AeroKITties/Kitties-Hardware/Hardware/ciam/impeller/impeller/Картинки/Снимок экрана (45).png

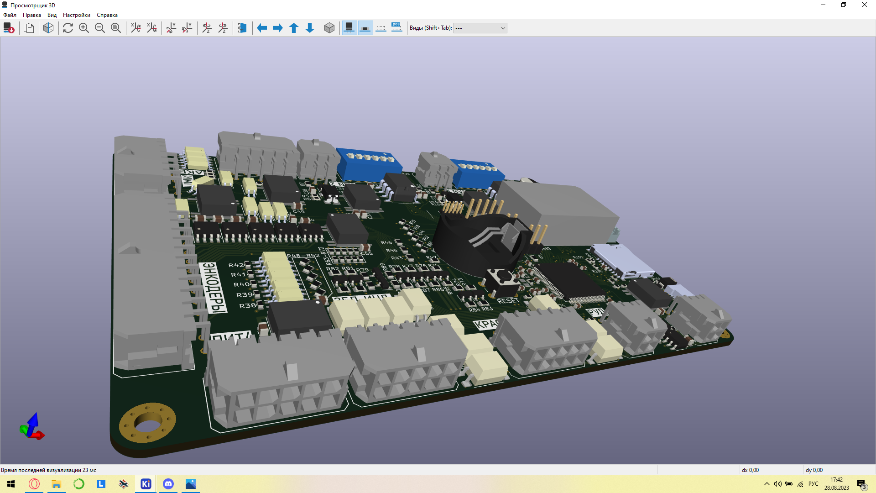
Hardware/ciam/impeller/impeller/Картинки/Снимок экрана (45).png
