AeroKITties/Kitties-Hardware/Hardware/ciam/impeller/impeller/Картинки/Снимок экрана (46).png

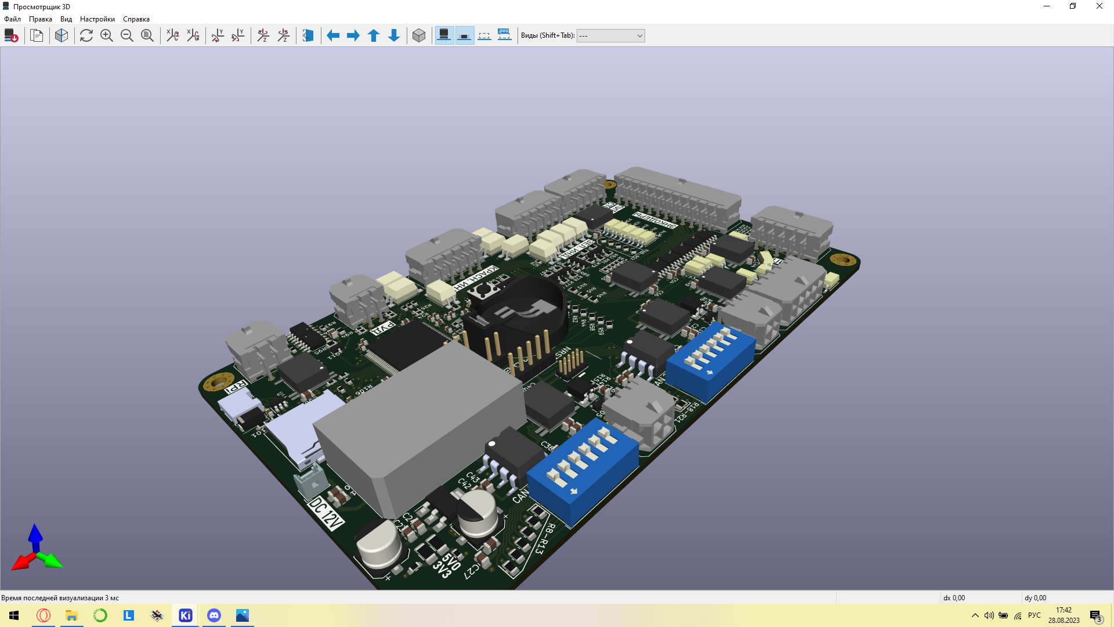
Hardware/ciam/impeller/impeller/Картинки/Снимок экрана (46).png
