AeroKITties/Kitties-Hardware/Documentation/gps/H52ce5d94572c492c8bb03de4b48cf365b.png

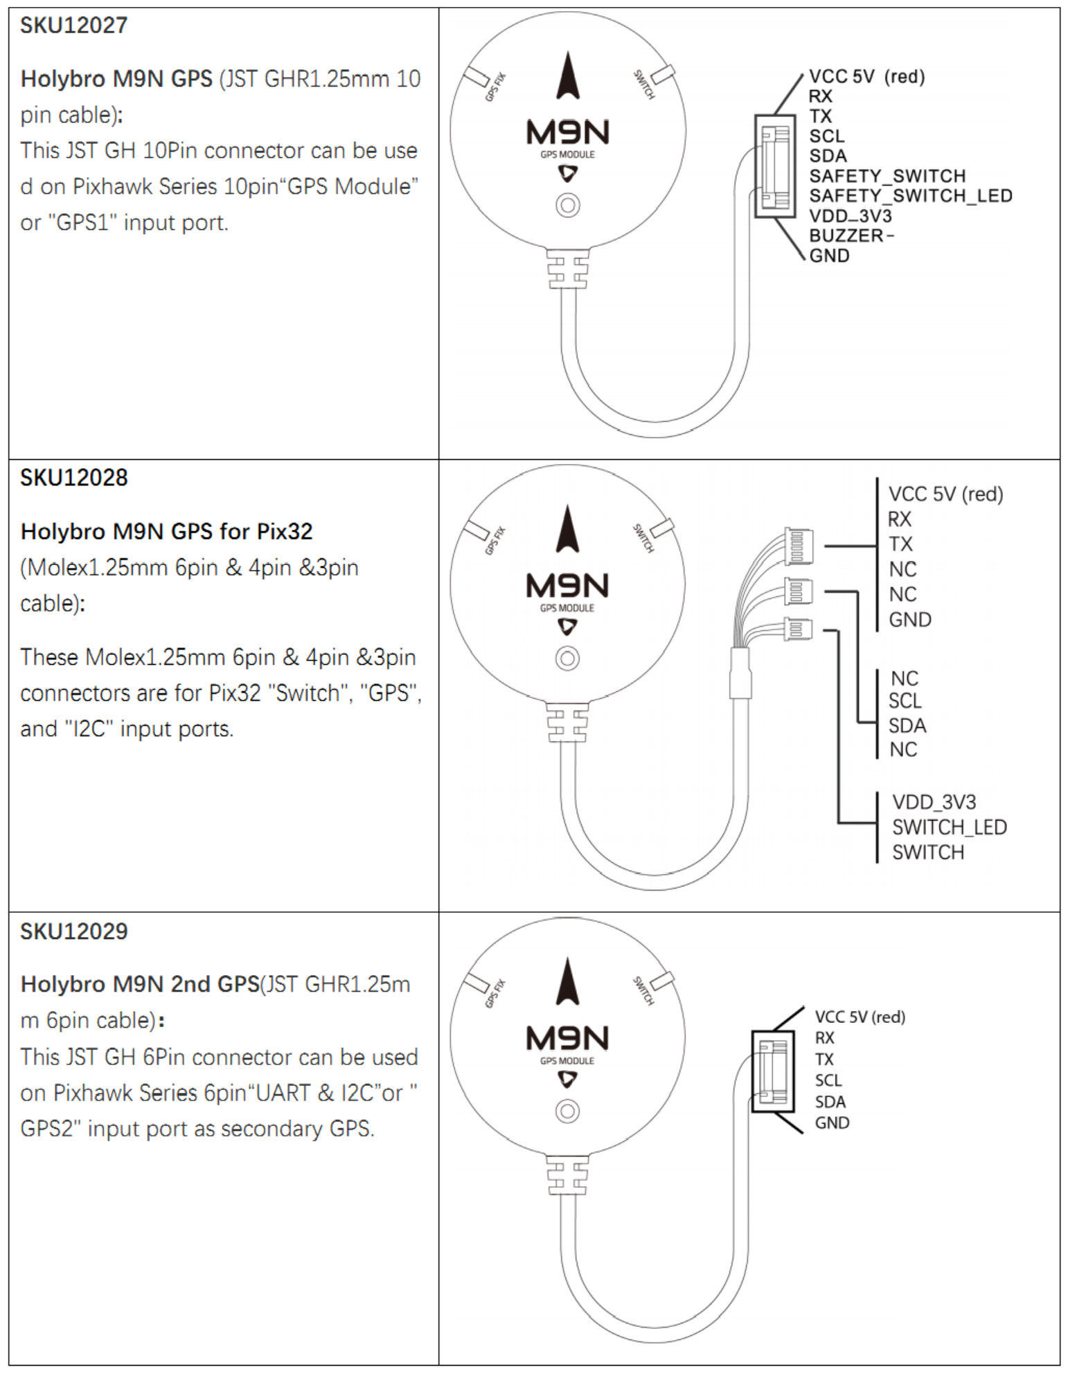
Documentation/gps/H52ce5d94572c492c8bb03de4b48cf365b.png
