AeroKITties/Kitties-Hardware/Documentation/gps/Neo-6-Neo7 module.jpg

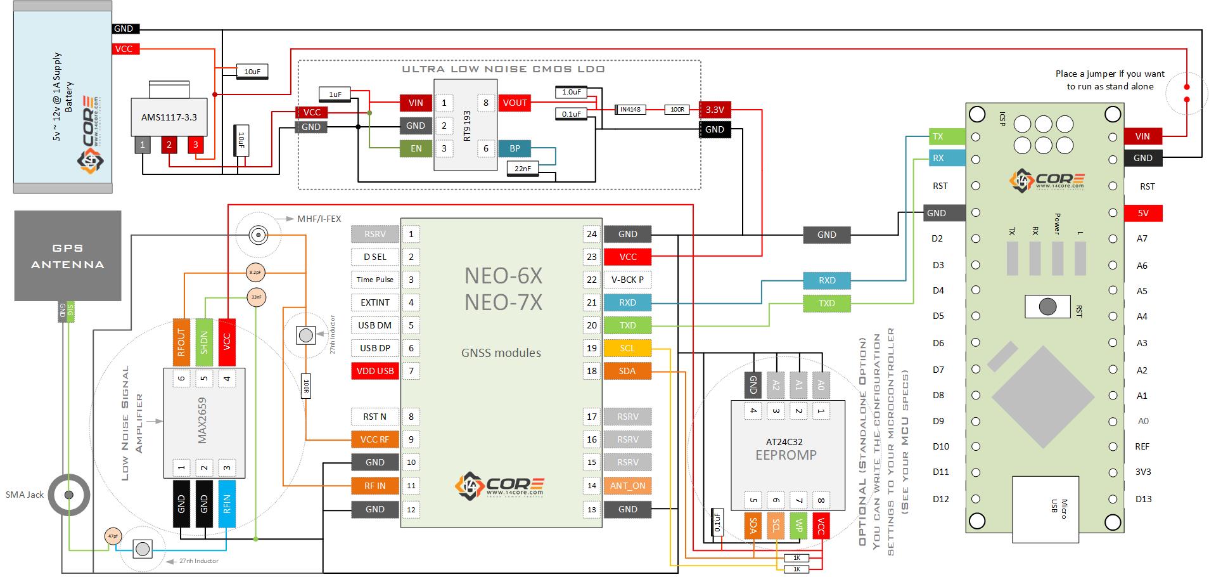
Documentation/gps/Neo-6-Neo7 module.jpg
