AeroKITties/Kitties-Hardware/Documentation/Transistor/MOSFET/mosfet-cheat-sheet.png

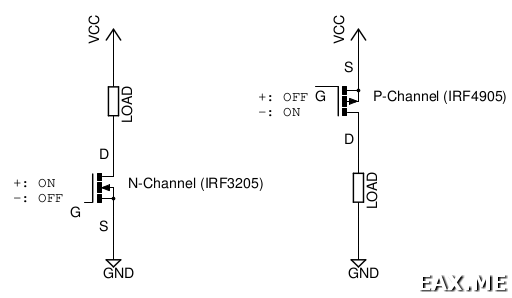
Documentation/Transistor/MOSFET/mosfet-cheat-sheet.png
