AeroKITties/Kitties-Hardware/Documentation/usb connector/EARU.jpg

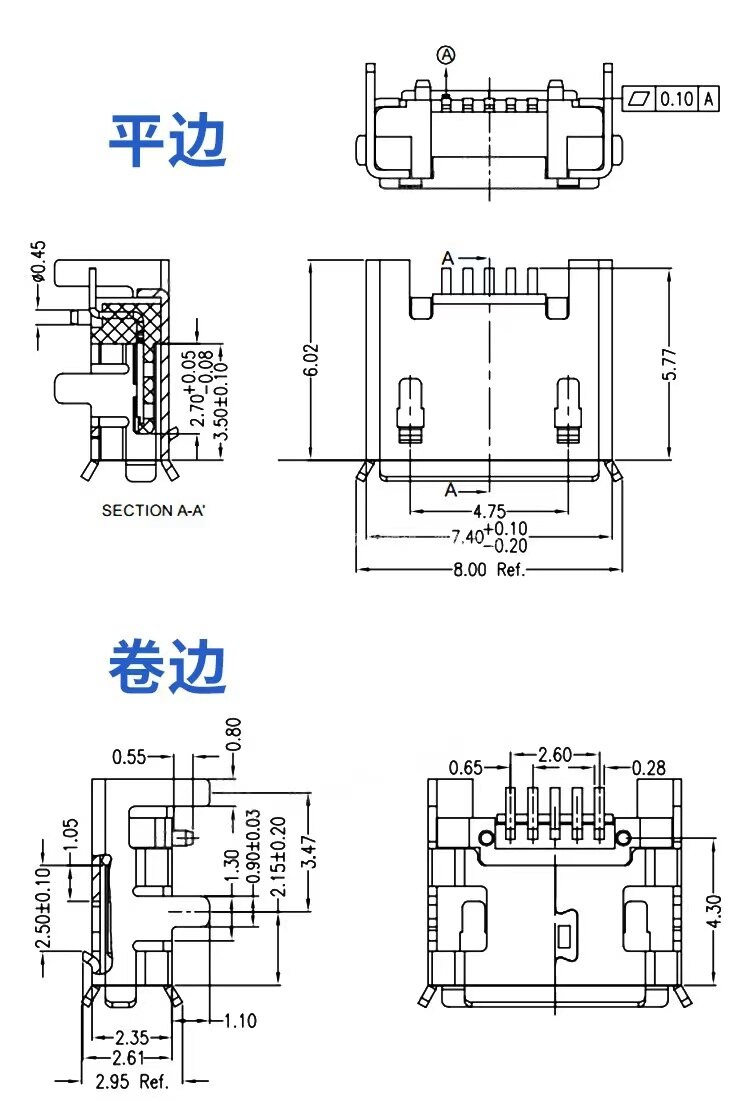
Documentation/usb connector/EARU.jpg
