AeroKITties/Kitties-Hardware/Documentation/usb connector/NIUEWISX.jpg

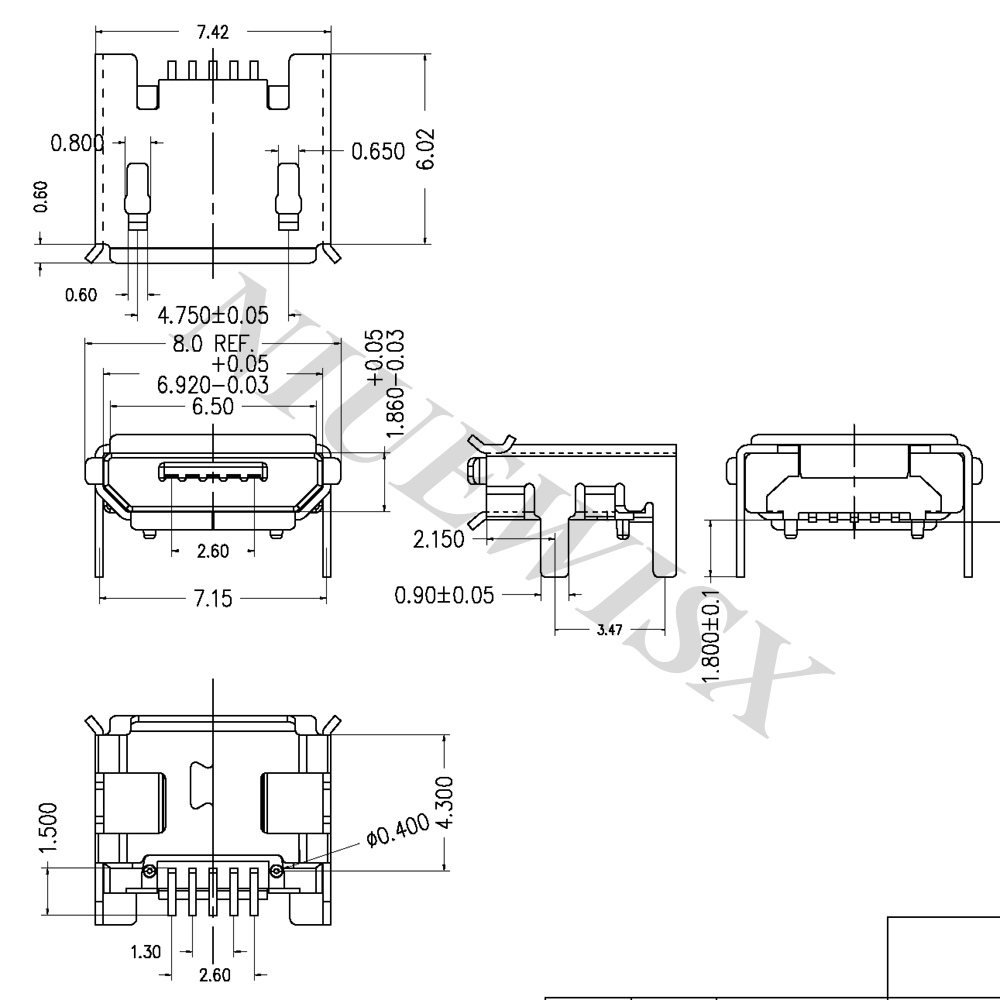
Documentation/usb connector/NIUEWISX.jpg
