AeroKITties/Kitties-Hardware/Hardware/ciam/impeller/impeller/Картинки/Снимок экрана (40).png

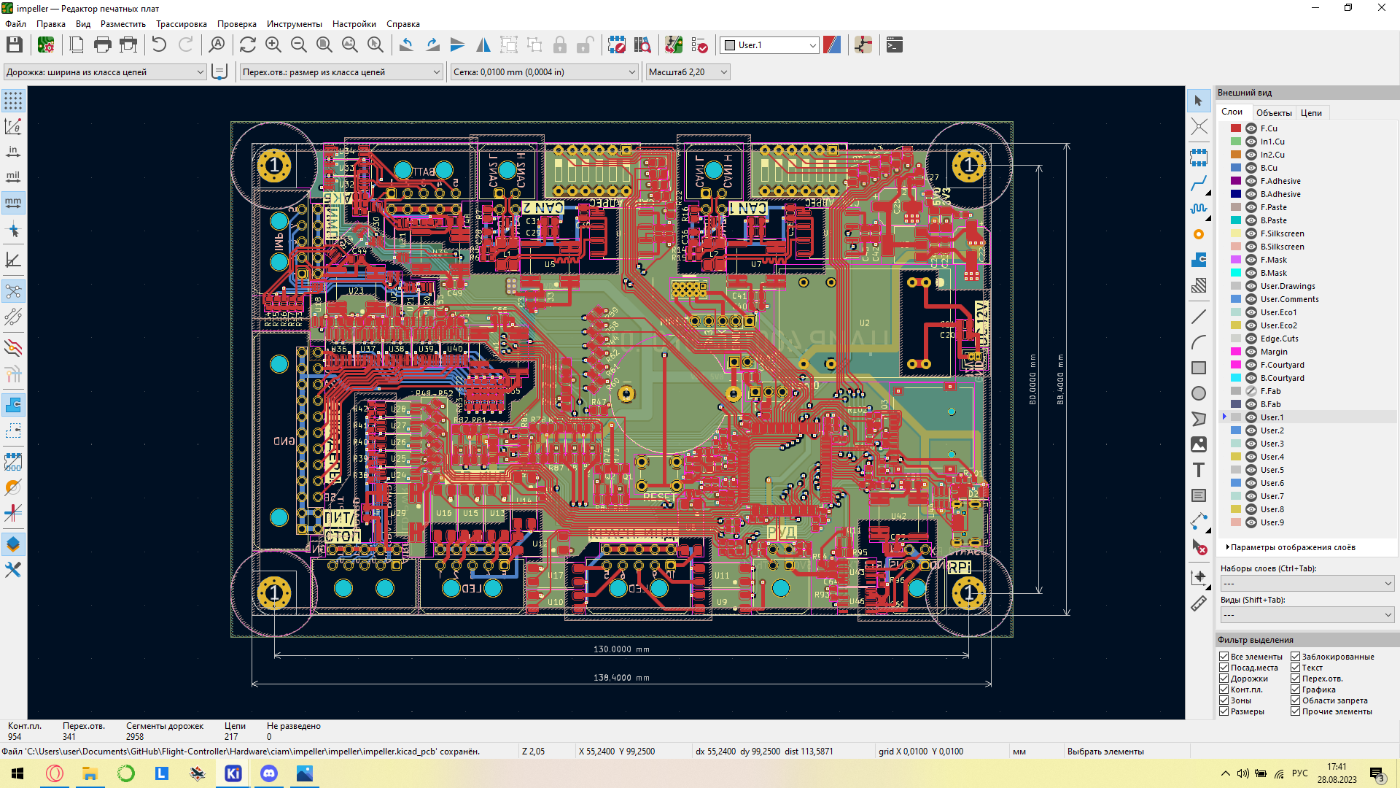
Hardware/ciam/impeller/impeller/Картинки/Снимок экрана (40).png
