AeroKITties/Kitties-Hardware/Hardware/ciam/impeller/impeller/Картинки/Снимок экрана (41).png

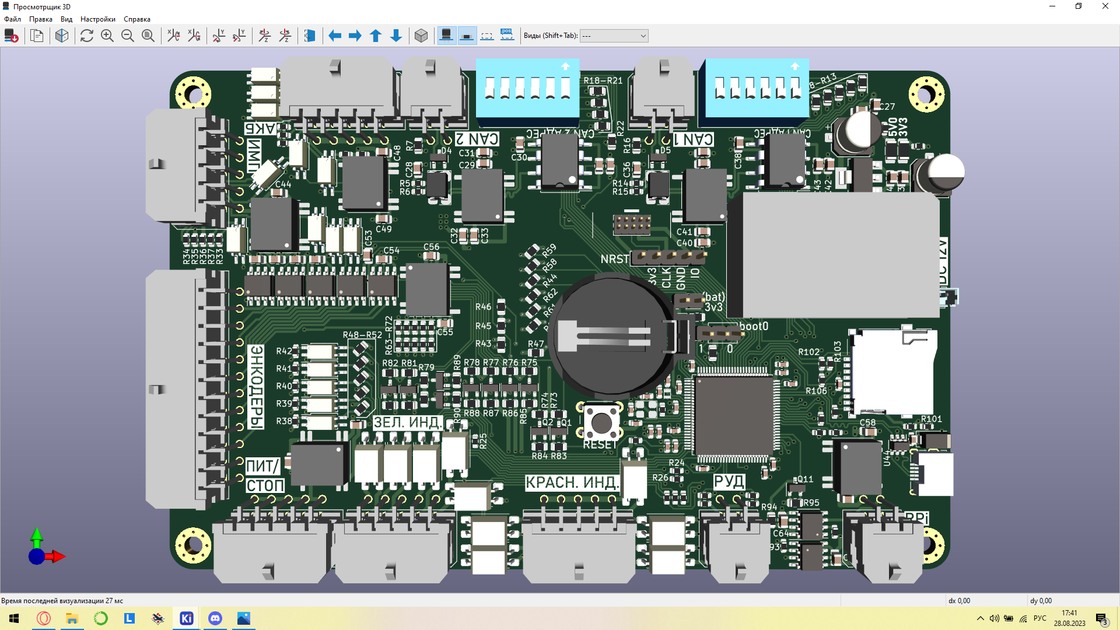
Hardware/ciam/impeller/impeller/Картинки/Снимок экрана (41).png
