AeroKITties/Kitties-Hardware/Hardware/ciam/impeller/impeller/Картинки/Снимок экрана (42).png

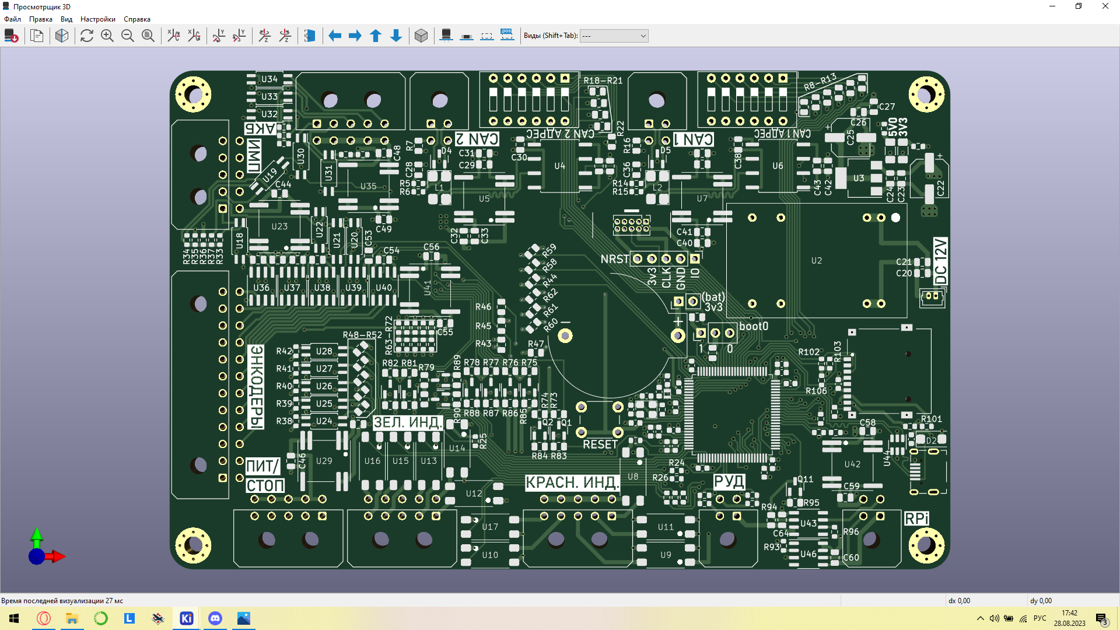
Hardware/ciam/impeller/impeller/Картинки/Снимок экрана (42).png
