AeroKITties/Kitties-Hardware/Hardware/ciam/impeller/impeller/Картинки/Снимок экрана (43).png

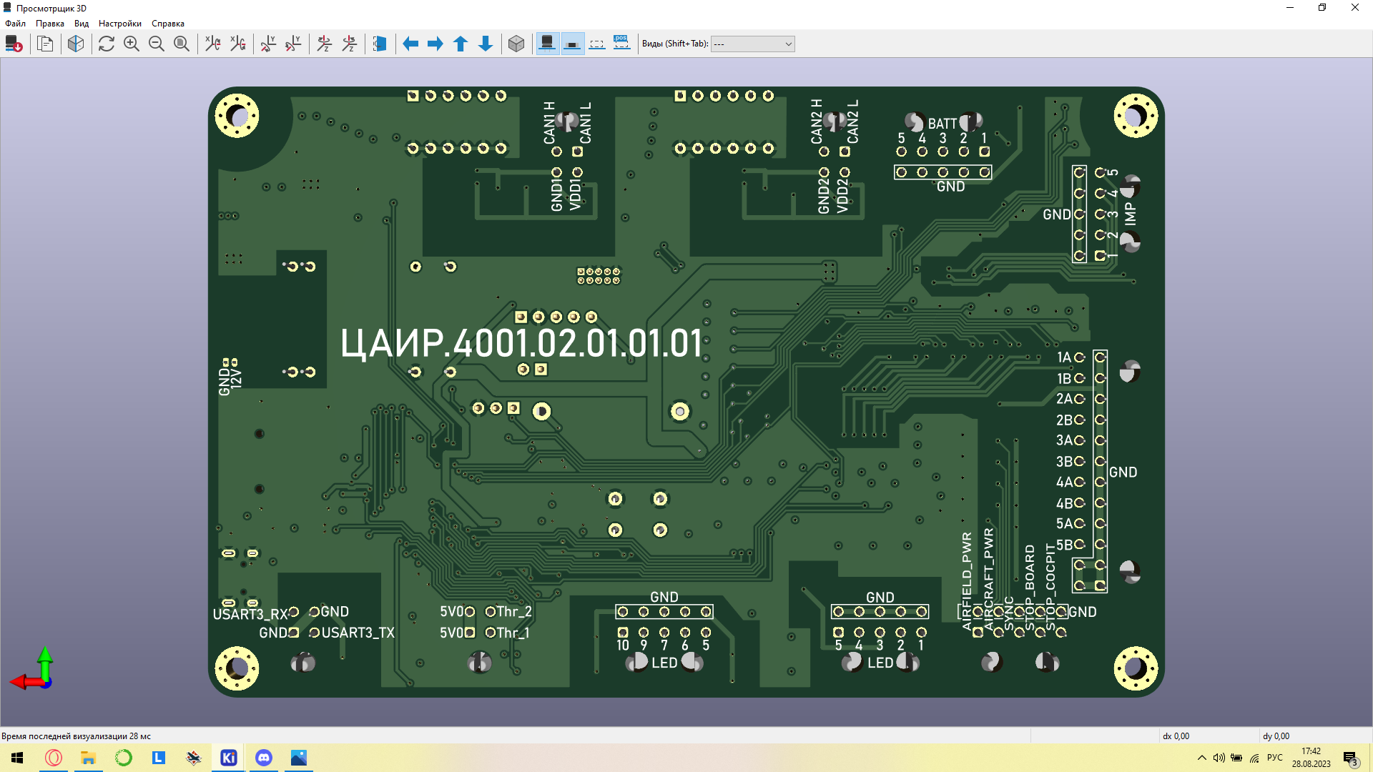
Hardware/ciam/impeller/impeller/Картинки/Снимок экрана (43).png
