AeroKITties/Kitties-Hardware/Hardware/ciam/impeller/rpi_power_shield/Картинки/Снимок экрана (33).png

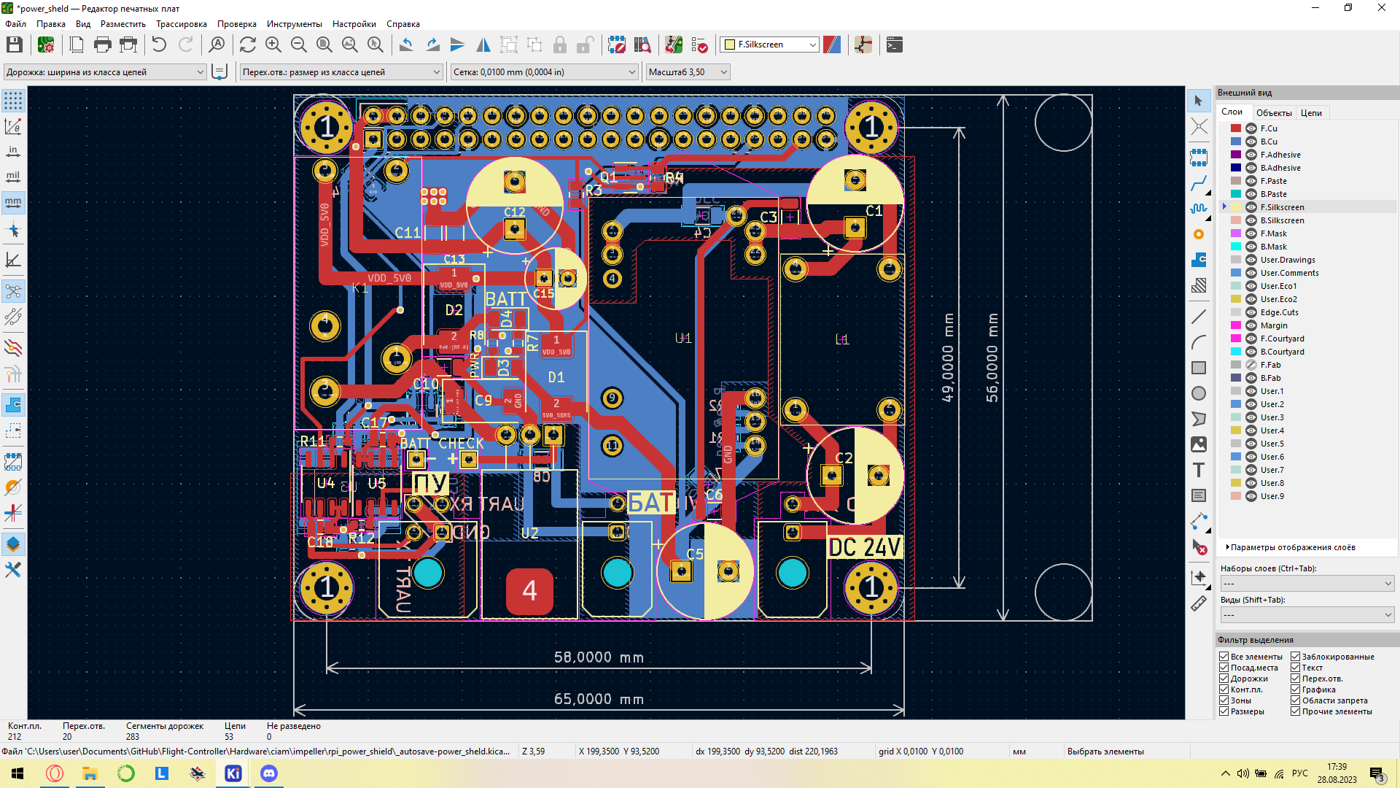
Hardware/ciam/impeller/rpi_power_shield/Картинки/Снимок экрана (33).png
