AeroKITties/Kitties-Hardware/Hardware/ciam/impeller/rpi_power_shield/Картинки/Снимок экрана (58).png

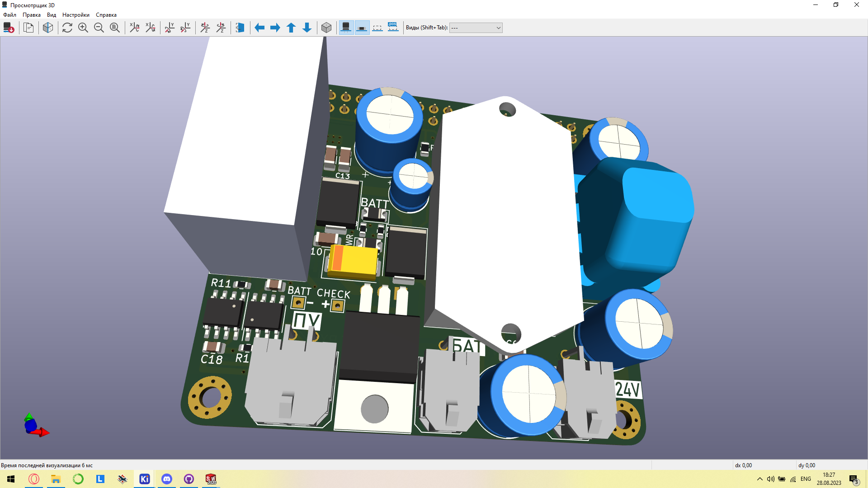
Hardware/ciam/impeller/rpi_power_shield/Картинки/Снимок экрана (58).png
