AeroKITties/Kitties-Hardware/Hardware/Royal Penguin/0.0/FC0.jpg

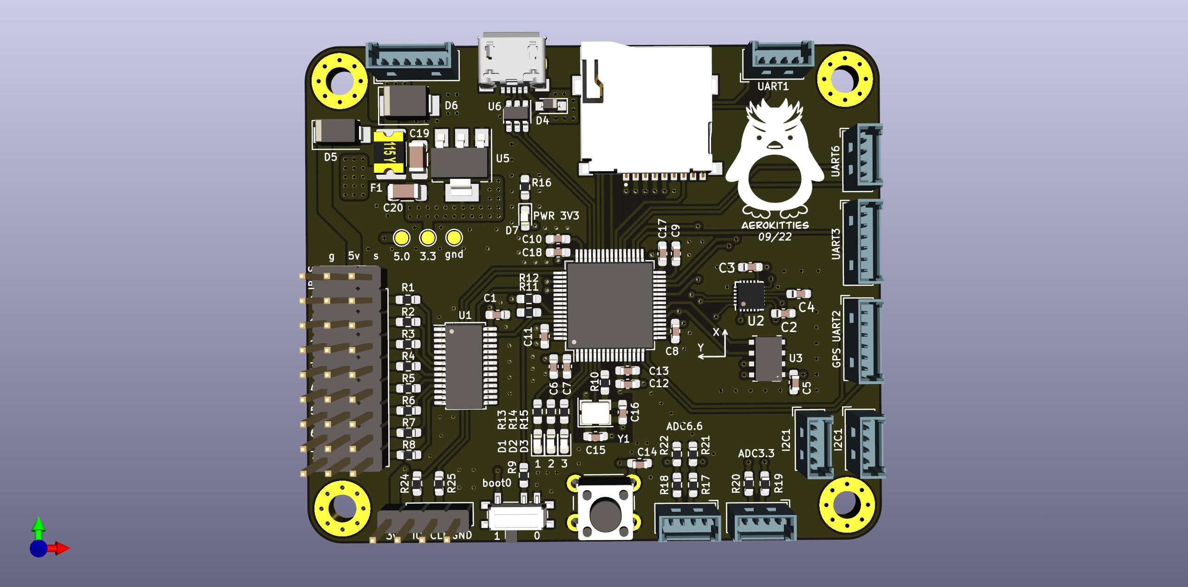
Hardware/Royal Penguin/0.0/FC0.jpg
