AeroKITties/Kitties-Hardware/Hardware/ciam/impeller/impeller/BOM_другое.xlsx

N | Название | Цена | Кол-во | Кол-во с запасом | Сумма | Ссылка
1 | Лампа зеленая | 170 | 5 | 10 | 1700 | https://www.chipdip.ru/product/ad-22ds-24-iek | СУММА
2 | Лампа красная | 180 | 5 | 10 | 1800 | https://www.chipdip.ru/product/ad-22ds-24 | 169717
3 | Кнопка аварийной остановки | 7220 | 2 | 2 | 14440 | https://www.chipdip.ru/product/ce4t-10r-11
4 | Энкодер инкрементальный | 370 | 5 | 10 | 3700 | https://www.platan.ru/cgi-bin/qwery.pl/id=216226127
5 | Ручка для энкодера | 370 | 5 | 10 | 3700 | https://www.chipdip.ru/product/knobs-42031-2
6 | Кнопка без фиксации зеленая | 530 | 1 | 3 | 1590 | https://www.chipdip.ru/product/mb100dy
7 | РУД Thrustmaster | 9449 | 1 | 1 | 9449 | https://www.citilink.ru/product/dzhoistik-thrustmaster-tca-quardrant-airbus-edition-ww-version-seryi-c-1583059/
8 | Тумблер | 1600 | 13 | 16 | 25600 | https://www.chipdip.ru/product/ma122
9 | Защитный колпачок | 71 | 1 | 3 | 213 | https://www.chipdip.ru/product0/8544855179
10 | Мышь компьютерная | 1710 | 1 | 2 | 3420 | https://www.chipdip.ru/product0/8020808726
11 | Одноплатный компьютер Raspberry pi | 23860 | 2 | 3 | 71580 | https://www.chipdip.ru/product/raspberry-pi-3-model-b-2
12 | Медный провод 22AWG красный | 510 | 3 | 5 | 2550 | https://www.li-force.ru/shop/view/22awg-10-033-60008-ul3135-lfw-22w-2
13 | Медный провод 22AWG серый | 510 | 3 | 5 | 2550 | https://www.li-force.ru/shop/view/22awg-10-033-60008-ul3135-lfw-22o
14 | Медный провод 22AWG синий | 510 | 2 | 3 | 1530 | https://www.li-force.ru/shop/view/22awg-10-033-60008-ul3135-lfw-22gr
15 | Медный провод 22AWG зеленый | 510 | 2 | 3 | 1530 | https://www.li-force.ru/shop/view/22awg-10-033-60008-ul3135-lfw-22y-2
16 | Потенциометр | 1130 | 2 | 5 | 5650 | https://www.chipdip.ru/product0/8008840025
17 | Разъем Micro-Fit 2x2 Ж | 30 | 4 | 15 | 450 | https://www.chipdip.ru/product/sct3001mh-2x2p
18 | Разъем Micro-Fit 2x5 Ж | 33 | 5 | 15 | 495 | https://www.chipdip.ru/product/sct3001mh-2x5p
19 | Разъем Micro-Fit 2x12 Ж | 60 | 1 | 5 | 300 | https://www.chipdip.ru/product/sct3001mh-2x12p
20 | Контакт-гнездо Micro-Fit | 8 | 200 | 500 | 4000 | https://www.chipdip.ru/product/sct3001-ft
21 | ethernet шнур m-m 15м | 720 | 1 | 2 | 1440 | https://www.chipdip.ru/product0/8003235821
22 | ethernet шнур m-m 2м | 830 | 1 | 2 | 1660 | https://www.chipdip.ru/product0/8007831350
23 | ethernet шнур m-m 20м | 1000 | 1 | 2 | 2000 | https://www.chipdip.ru/product0/8011591466
24 | Кабель HDMI - HDMI 1м | 320 | 1 | 2 | 640 | https://www.chipdip.ru/product/ox-hdmi1v1.4lx
25 | Кабель HDMI - HDMI 1.5м | 865 | 1 | 2 | 1730 | https://www.chipdip.ru/product0/8015598655
26 | Батарейка 3В плоская | 180 | 1 | 10 | 1800 | https://www.chipdip.ru/product/gp-cr2032
27 | micro sd карта | 700 | 3 | 6 | 4200 | https://www.chipdip.ru/product/sdcs2-64gb
