AeroKITties/Kitties-Hardware/Hardware/ciam/impeller/impeller/BOM_плата_кпу.xlsx

Reference | Value | Footprint | Ссылка | Цена | Человекопонятное название | Кол. | Кол-во с запасом | Сумма
BT1 | KLS5-CR2032-01 | user_lib:KLS5-CR2032-01 | https://www.chipdip.ru/product/bh-642 | 16 | Разъем для плоской батарейки 3В | 1 | 3 | 48
C1, C2, C4, C7-C12, C15, C56, C63 | 100n | Capacitor_SMD:C_0603_1608Metric | https://www.chipdip.ru/product/grm188r71h104k | 19 | Конденсатор 100нФ | 12 | 36 | 684
C3, C5 | 1u | Capacitor_SMD:C_0603_1608Metric | https://www.chipdip.ru/product/grm188r71c105ka12d | 20 | Конденсатор 1мкФ | 2 | 6 | 120
C6 | 4u7 | Capacitor_SMD:C_0603_1608Metric | https://www.chipdip.ru/product0/9000348448 | 21 | Конденсатор 4.7мкФ | 1 | 3 | 63
C13, C14, C16, C17 | 15p | Capacitor_SMD:C_0603_1608Metric | https://www.chipdip.ru/product/grm1885c2a150j | 6 | Конденсатор 15пФ | 4 | 12 | 72
C18, C19 | 2u2 | Capacitor_SMD:C_0603_1608Metric | https://www.chipdip.ru/product/grm188r61a225k | 11 | Конденсатор 2.2мкФ | 2 | 6 | 66
C20, C22, C25, C44, C46, C48, C55, C58, C61 | 4u7 | Capacitor_SMD:C_0805_2012Metric | https://www.chipdip.ru/product/grm21br61e475ka12l | 13 | Конденсатор 4.7мкФ | 9 | 27 | 351
C21, C24 | 47u | Capacitor_SMD:CP_Elec_6.3x5.4 | https://www.chipdip.ru/product0/9000565730 | 16 | Конденсатор 47мкФ | 2 | 6 | 96
C23, C26, C28, C30, C35, C38, C39, C42, C49-C53, C57, C60, C62 | 100n | Capacitor_SMD:C_0805_2012Metric | https://www.chipdip.ru/product/grm21br71h104k | 13 | Конденсатор 100нФ | 16 | 48 | 624
C27, C29, C31, C32 | 1u | Capacitor_SMD:C_0805_2012Metric | https://www.chipdip.ru/product/grm21br71e105k | 13 | Конденсатор 1мкФ | 4 | 12 | 156
C33, C34 | 4n7 | Capacitor_SMD:C_0805_2012Metric | https://www.chipdip.ru/product/grm216r71h472k | 8 | Конденсатор 4.7нФ | 2 | 6 | 48
C36, C37, C40, C41, C43, C45, C47, C54, C59 | 10u | Capacitor_SMD:C_0805_2012Metric | https://www.chipdip.ru/product/grm21br61e106ka73l | 13 | Конденсатор 10мкФ | 9 | 27 | 351
D1, D2 | PESD1CAN | Package_TO_SOT_SMD:SOT-23 | https://www.chipdip.ru/product/pesd1can.215 | 87 | Защитный диод от ESD для CAN шины | 2 | 6 | 522
D3 | ss24 | user_lib:SS24 | https://www.chipdip.ru/product/ss24-umw | 5 | Диод Шоттки | 1 | 3 | 15
D4, D5 | FYLS-1206SRC | Resistor_SMD:R_1206_3216Metric_Pad1.30x1.75mm_HandSolder | https://www.chipdip.ru/product0/8002031702 | 38 | Светодиод красный | 2 | 6 | 228
J1 | PLS-3 | Connector_PinHeader_2.54mm:PinHeader_1x03_P2.54mm_Vertical | https://www.chipdip.ru/product/pls-3 | 8 | Вилка штыревая 1x3 | 1 | 3 | 24
J5 | PicoBlade_1x2P | Connector_Molex:Molex_PicoBlade_53047-0210_1x02_P1.25mm_Vertical | https://www.chipdip.ru/product/sct1251wv-2p | 8 | Разъем Picoblade 1x2 | 1 | 3 | 24
J6, J7, J16, J17 | Micro-Fit_2x2P | Connector_Molex:Molex_Micro-Fit_3.0_43045-0400_2x02_P3.00mm_Horizontal | https://www.chipdip.ru/product/sct3001wr-2x02p | 26 | Разъем Micro-Fit 2x2 М | 4 | 12 | 312
J8-J12 | Micro-Fit_2x5P | Connector_Molex:Molex_Micro-Fit_3.0_43045-1000_2x05_P3.00mm_Horizontal | https://www.chipdip.ru/product/sct3001wr-2x05p | 34 | Разъем Micro-Fit 2x5 М | 5 | 15 | 510
J13 | Micro-Fit_2x12P | Connector_Molex:Molex_Micro-Fit_3.0_43045-2400_2x12_P3.00mm_Horizontal | https://www.chipdip.ru/product/sct3001wr-2x12p | 51 | Разъем Micro-Fit 2x12 М | 1 | 3 | 153
J14 | PLS-5 | Connector_PinHeader_2.54mm:PinHeader_1x05_P2.54mm_Vertical | https://www.chipdip.ru/product/pls-5 | 8 | Вилка штыревая 1x5 | 1 | 3 | 24
JP1 | PLS-2 | Connector_PinHeader_2.54mm:PinHeader_1x02_P2.54mm_Vertical | https://www.chipdip.ru/product/pls-2 | 8 | Вилка штыревая 1x2 | 1 | 3 | 24
L1, L2 | B82789C0513H002 | user_lib:B82789C0513H002 | https://www.chipdip.ru/product0/8002015174 | 510 | Подавитель синфазных помех | 2 | 6 | 3060
Q1-Q12 | BSS138 | Package_TO_SOT_SMD:SOT-23 | https://www.chipdip.ru/product/bss138-umw | 3 | Транзистор полевой n типа | 12 | 36 | 108
R1, R9-R20, R31, R32, R35, R36, R39, R40, R43, R44, R47, R48, R51, R53, R55, R57, R59, R61, R62, R64, R65, R67, R68, R70, R71, R73, R74, R76, R77, R79, R80, R82, R83, R85, R86, R88, R89, R91, R92, R94, R95 | 10k | Resistor_SMD:R_0805_2012Metric | https://www.chipdip.ru/product/0.125w-0805-10-kom-5 | 5 | Резистор 10k Ом | 52 | 156 | 780
R2 | 0 | Resistor_SMD:R_0603_1608Metric | https://www.chipdip.ru/product/0.1w-0603-0-om-5 | 5 | Резистор 0 ОМ (перемычка) | 1 | 3 | 15
R7, R8 | 0 | Resistor_SMD:R_0805_2012Metric | https://www.chipdip.ru/product/0.125w-0805-peremychka-0-om | 5 | Резистор 0 ОМ (перемычка) | 2 | 6 | 30
R21-R30, R93, R96 | 220 | Resistor_SMD:R_0603_1608Metric | https://www.chipdip.ru/product/0.1w-0603-220-om-1 | 5 | Резистор 220 Ом | 12 | 36 | 180
R33, R34, R37, R38, R41, R42, R45, R46, R49, R50, R52, R54, R56, R58, R60 | 360 | Resistor_SMD:R_0603_1608Metric | https://www.chipdip.ru/product/0.1w-0603-360-om-1 | 5 | Резистор 360 Ом | 15 | 45 | 225
R63, R66, R69, R72, R75, R78, R81, R84, R87, R90 | 330 | Resistor_SMD:R_0603_1608Metric | https://www.chipdip.ru/product/0.1w-0603-330-om-1 | 5 | Резистор 330 Ом | 10 | 30 | 150
R97 | 150 | Resistor_SMD:R_0603_1608Metric | https://www.chipdip.ru/search?searchtext=150%D0%9E%D0%BC | 5 | Резистор 150 Ом | 1 | 3 | 15
R98 | 65 | Resistor_SMD:R_0603_1608Metric | https://www.chipdip.ru/product/0.1w-0603-75-om-1 | 5 | Резистор 65 Ом | 1 | 3 | 15
R99-R104 | 100k | Resistor_SMD:R_0603_1608Metric | https://www.chipdip.ru/product/0.1w-0603-100-kom-1 | 5 | Резистор 100k Ом | 6 | 18 | 90
R105, R107 | 1k | Resistor_SMD:R_0603_1608Metric | https://www.chipdip.ru/product/0.1w-0603-1-kom-1 | 5 | Резистор 1К ОМ | 2 | 6 | 30
R106, R108 | 2k | Resistor_SMD:R_0603_1608Metric | https://www.chipdip.ru/product/0.1w-0603-2-kom-1 | 5 | Резистор 2К ОМ | 2 | 6 | 30
SW1 | KLS7-TS6601-11-180 | Button_Switch_THT:SW_PUSH_6mm_H4.3mm | https://www.chipdip.ru/product/kls7-ts6601-11.0-180-it-1102k | 8 | Кнопка тактовая прямая | 1 | 3 | 24
SW2, SW3 | DS1040-06RN | Button_Switch_THT:SW_DIP_SPSTx06_Slide_9.78x17.42mm_W7.62mm_P2.54mm | https://www.chipdip.ru/product/ds1040-06rn | 38 | DIP переключатель 6pin красный | 2 | 6 | 228
U1 | STM32F405VGT6 | Package_QFP:LQFP-100_14x14mm_P0.5mm | https://www.chipdip.ru/product0/8884285457 | 930 | Микроконтроллер | 1 | 3 | 2790
U2, U44 | LDL1117S33R | Package_TO_SOT_SMD:SOT-223-3_TabPin2 | https://www.chipdip.ru/product/ldl1117s33r-stm | 33 | LDO-стабилизатор напряжения | 2 | 6 | 198
U3 | TEL 5-1211 | user_lib:TEL 5-1211 | https://www.chipdip.ru/product/tel-5-1211 | 2500 | DC-DC преобразователь | 1 | 3 | 7500
U4, U5 | ISO1050DUB | Package_SO:SOP-8_6.62x9.15mm_P2.54mm | https://energoflot.ru/item/ISO1050DUB | 225 | Изолированный приемопередатчик интерфейса CAN | 2 | 6 | 1350
U6, U7, U28, U29, U35, U41, U45 | B0505MT-1WR4 | user_lib:B0505MT-1WR4 | https://www.chipdip.ru/product0/8003333290 | 120 | DC/DC преобразователь | 7 | 21 | 2520
U8-U17 | G3VM61D1 | user_lib:G3VM61D1 | https://www.chipdip.ru/product0/8006782491 | 710 | Оптореле | 10 | 30 | 21300
U18-U27, U30-U34 | TLP291 | Package_SO:SOIC-4_4.55x2.6mm_P1.27mm | https://www.chipdip.ru/product/tlp291-gb-tp-se-t | 62 | Оптопара с транзисторным выходом | 15 | 45 | 2790
U42 | USBLC6-2SC6 | Package_TO_SOT_SMD:SOT-23-6 | https://www.chipdip.ru/product/usblc6-2sc6 | 25 | Защита интерфейса USB от электростатических разрядов | 1 | 3 | 75
Y1 | KSE-7K32768KDY2400A3 | user_lib:KSE-7K32768KDY2400A3 | https://www.chipdip.ru/product0/8022143960 | 34 | Кристаллический резонатор 32КГц | 1 | 3 | 102
Y2 | KSE-7U08000MAB143ZA3 | user_lib:KSE-7U08000MAB143ZA3 | https://www.chipdip.ru/product0/8022069891 | 12 | Кристаллический резонатор 8МГц | 1 | 3 | 36
 |  |  |  |  |  |  |  | СУММА
 |  |  |  |  |  |  |  | 48156
