AeroKITties/Kitties-Hardware/Hardware/ciam/impeller/rpi_power_shield/BOM_RPi_Shield_PCB.xlsx

Reference | Value | Footprint | Ссылка | Цена | Человекопонятное название | Кол. | Кол-во с запасом | Сумма
C1, C2, C12 | 10u |  | https://www.chipdip.ru/product0/9000383642 | 30 | Конденсатор электролитический | 3 | 9 | 270
C3, C4, C6, C7 | 330p |  | https://www.chipdip.ru/product/grm31a7u2j331jw31d | 25 | Керамический конденсатор | 4 | 12 | 300
C5 | 220u |  | https://www.chipdip.ru/product0/9000239379 | 52 | Конденсатор электролитический | 1 | 3 | 156
C8, C10, C11, C14 | 100n |  | https://www.chipdip.ru/product/grm319r71h104k | 13 | Конденсатор керамический | 4 | 12 | 156
C9 | 22u |  | https://www.chipdip.ru/product/tecap-22-mkf-20-v-tip-d-10 | 36 | Конденсатор электролитический | 1 | 3 | 108
C13 | 1u |  | https://www.chipdip.ru/product/grm31mr71e105k | 25 | Конденсатор керамический | 1 | 3 | 75
C15 | 100u |  | https://www.chipdip.ru/product0/14560 | 13 | Конденсатор электролитический | 1 | 3 | 39
D1, D2 | SS54C |  | https://www.chipdip.ru/product/ss54c | 14 | Диод Шоттки | 2 | 6 | 84
D3, D4 | FYLS-1206SRC | Resistor_SMD:R_1206_3216Metric_Pad1.30x1.75mm_HandSolder | https://www.chipdip.ru/product0/8002031702 | 38 | Светодиод красный | 2 | 6 | 228
J1, J3 | Micro-fit_1x2P |  | https://www.chipdip.ru/product/sct3001wr-2x01p | 29 | Коннектор micro-fit | 2 | 6 | 174
J2 | RPi |  | https://www.chipdip.ru/product/pbd-40 | 29 | Разъем штыревой 2x20 | 1 | 3 | 87
K1 | NRP-12-C-05D-H |  | https://www.chipdip.ru/product/nrp-12-c-05d-h | 260 | электромех. реле | 1 | 3 | 780
L1 | B82721-K2222-U30 |  | https://www.chipdip.ru/product/b82721-k2222-u30-2x1000 | 380 | Дроссель подавления ЭМП | 1 | 3 | 1140
Q1 | BSS138 | Package_TO_SOT_SMD:SOT-23 | https://www.chipdip.ru/product/bss138-umw | 3 | Транзистор полевой n типа | 1 | 3 | 9
R1, R2 | R_reg | Resistor_SMD:R_0603_1608Metric |  |  |  | 2 | 6 | 0
R3, R4 | 10k | Resistor_SMD:R_0805_2012Metric | https://www.chipdip.ru/product/0.125w-0805-10-kom-5 | 5 | Резистор 10k Ом | 2 | 6 | 30
R5 | 1k5 | Resistor_SMD:R_0603_1608Metric | https://www.chipdip.ru/product/0.1w-0603-1.5-kom-1 | 5 | Резистор 1К ОМ | 1 | 3 | 15
R6 | 2k | Resistor_SMD:R_0603_1608Metric | https://www.chipdip.ru/product/0.1w-0603-2-kom-1 | 5 | Резистор 2К ОМ | 1 | 3 | 15
R7, R8 | 360 | Resistor_SMD:R_0603_1608Metric | https://www.chipdip.ru/product/0.1w-0603-360-om-1 | 5 | Резистор 360 Ом | 2 | 6 | 30
U1 | VDV8-1E05 |  | https://www.chipdip.ru/product0/8010397463 | 8260 | DC-DC преобразователь 24->5В | 1 | 3 | 24780
U2 | L4940V5 |  | https://www.chipdip.ru/product/l4940v5 | 200 | LDO регулятор | 1 | 3 | 600
 |  |  |  |  |  |  |  | СУММА
 |  |  |  |  |  |  |  | 29076
