AeroKITties/Kitties-Hardware/Hardware/Royal Penguin/0.0/FC0.xlsx

Item | Qty | Reference(s) | Value | Footprint | JLCPCB Part # | Link
1 | 11 | C1, C3, C4, C5, C7, C8, C9, C10, C11, C12, C14 | 100n | Capacitor_SMD:C_0603_1608Metric_Pad1.08x0.95mm_HandSolder | C14663
2 | 1 | C2 | 10n | Capacitor_SMD:C_0603_1608Metric_Pad1.08x0.95mm_HandSolder | C57112
3 | 1 | C6 | 4.7u | Capacitor_SMD:C_0603_1608Metric_Pad1.08x0.95mm_HandSolder | C19666
4 | 1 | C13 | 1u | Capacitor_SMD:C_0603_1608Metric_Pad1.08x0.95mm_HandSolder | C15849
5 | 2 | C15, C16 | 8p | Capacitor_SMD:C_0603_1608Metric_Pad1.08x0.95mm_HandSolder | C327316
6 | 2 | C17, C18 | 2.2u | Capacitor_SMD:C_0603_1608Metric_Pad1.08x0.95mm_HandSolder | C23630
7 | 2 | C19, C20 | 22u | Capacitor_SMD:C_1206_3216Metric_Pad1.33x1.80mm_HandSolder | C12891
8 | 4 | D1, D2, D3, D7 | LED | LED_SMD:LED_0603_1608Metric_Pad1.05x0.95mm_HandSolder
9 | 1 | D4 | SD103AWS | Diode_SMD:D_SOD-323_HandSoldering | C22452
10 | 1 | D5 | SS54 | Diode_SMD:D_SMA | C22452
11 | 1 | D6 | 1SMB5919B | Diode_SMD:D_SMB
12 | 1 | F1 | MF-MSMFxxx | Fuse:Fuse_1812_4532Metric_Pad1.30x3.40mm_HandSolder
13 | 4 | H1, H2, H3, H4 | MountingHole | MountingHole:MountingHole_3.2mm_M3_Pad_Via
14 | 1 | J1 | Micro_SD_Card | sd:TF15X15
15 | 1 | J2 | Power Conn6 | Connector_Molex:Molex_PicoBlade_53047-0610_1x06_P1.25mm_Vertical
16 | 1 | J3 | ADC6.6 conn4 | Connector_Molex:Molex_PicoBlade_53047-0410_1x04_P1.25mm_Vertical
17 | 1 | J4 | ADC3.3 conn4 | Connector_Molex:Molex_PicoBlade_53047-0410_1x04_P1.25mm_Vertical
18 | 1 | J5 | PWM_SIG | Connector_PinHeader_2.54mm:PinHeader_1x09_P2.54mm_Vertical
19 | 1 | J6 | PWM_POWER | Connector_PinHeader_2.54mm:PinHeader_2x09_P2.54mm_Vertical
20 | 2 | J7, J10 | UART conn6 | Connector_Molex:Molex_PicoBlade_53047-0610_1x06_P1.25mm_Vertical
21 | 2 | J8, J9 | UART conn4 | Connector_Molex:Molex_PicoBlade_53047-0410_1x04_P1.25mm_Vertical
22 | 2 | J11, J12 | I2C conn4 | Connector_Molex:Molex_PicoBlade_53047-0410_1x04_P1.25mm_Vertical
23 | 1 | J13 | SWD_CONN4 | Connector_PinHeader_2.54mm:PinHeader_1x04_P2.54mm_Vertical
24 | 1 | J14 | USB_B_Micro | user_lib:USB_MICRO_B_10118193_0001LF
25 | 10 | R1, R2, R3, R4, R5, R6, R7, R8, R24, R25 | 22 | Resistor_SMD:R_0603_1608Metric_Pad0.98x0.95mm_HandSolder | C23345
26 | 7 | R9, R17, R18, R19, R20, R21, R22 | 10k | Resistor_SMD:R_0603_1608Metric_Pad0.98x0.95mm_HandSolder | C25804
27 | 1 | R10 | 0 | Resistor_SMD:R_0603_1608Metric_Pad0.98x0.95mm_HandSolder | C21189
28 | 2 | R11, R12 | 4.7k | Resistor_SMD:R_0603_1608Metric_Pad0.98x0.95mm_HandSolder | C23162
29 | 4 | R13, R14, R15, R16 | 1k | Resistor_SMD:R_0603_1608Metric_Pad0.98x0.95mm_HandSolder | C21190
30 | 1 | SW1 | NRST | Button_Switch_THT:SW_PUSH_6mm_H5mm
31 | 1 | SW2 | SW_SPDT | Button_Switch_SMD:SW_SPDT_PCM12
32 | 3 | TP1, TP2, TP3 | TestPoint | TestPoint:TestPoint_Pad_D1.5mm
33 | 1 | U1 | PCA9685PW | Package_SO:TSSOP-28_4.4x9.7mm_P0.65mm
34 | 1 | U2 | MPU-9250 | Sensor_Motion:InvenSense_QFN-24_3x3mm_P0.4mm
35 | 1 | U3 | MS5611-01BA | user_lib:LGA-8_3x5mm_P1.25mm_handsolder
36 | 1 | U4 | STM32F405RGTx | Package_QFP:LQFP-64_10x10mm_P0.5mm
37 | 1 | U5 | AMS1117-3.3 | Package_TO_SOT_SMD:SOT-223-3_TabPin2
38 | 1 | U6 | USBLC6-2SC6 | Package_TO_SOT_SMD:SOT-23-6
39 | 1 | Y1 | X322516MLB4SI | Crystal:Crystal_SMD_3225-4Pin_3.2x2.5mm
