AeroKITties/Kitties-Hardware/Hardware/ciam/impeller/rpi_power_shield/BOM_RPi_Shield.xlsx

N | Название | Цена | Кол-во | Кол-во с запасом | Сумма | Ссылка
1 | Проставка латунная | 110 | 8 | 16 | 1760 | https://www.chipdip.ru/product0/8010398729
2 | Проставка латунная | 110 | 8 | 16 | 1760 | https://www.chipdip.ru/product0/8010398730
3 | Проставка латунная | 80 | 8 | 16 | 1280 | https://www.chipdip.ru/product0/8010398728
4 | Проставка латунная | 74 | 8 | 16 | 1184 | https://www.chipdip.ru/product0/8010398723
5 | Проставка латунная | 92 | 8 | 16 | 1472 | https://www.chipdip.ru/product0/8010398726
6 | DC-DC преобразователь | 3510 | 2 | 3 | 10530 | https://www.chipdip.ru/product/rsd-60l-24
7 | Аккумулятор 7.4В | 1095 | 2 | 4 | 4380 | https://allbat.ru/akkumulyator-li-po-74v-1500mah-format-903462-razem-jst/
8 | Micro-fit 1x2P Ж | 21 | 2 | 4 | 84 | https://www.chipdip.ru/product/sct3001mh-2x1p
 |  |  |  |  | СУММА
 |  |  |  |  | 22450
