AeroKITties/Kitties-Hardware/Hardware/Kicad 3D/XT30PW-M--3DModel-STEP-1.STEP

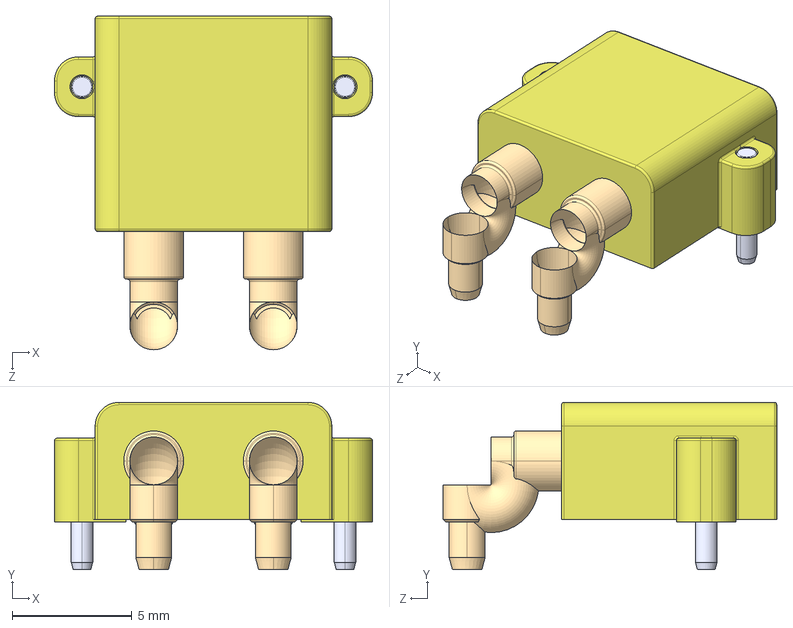
[picture p20: CAD file, 2024-03-14]
Hardware/Kicad 3D/XT30PW-M--3DModel-STEP-1.STEP
13.3 x 7.00 x 14.0 mm
