AeroKITties/Kitties-Hardware/Hardware/Kicad 3D/XT60PW-M--3DModel-STEP-269445.STEP

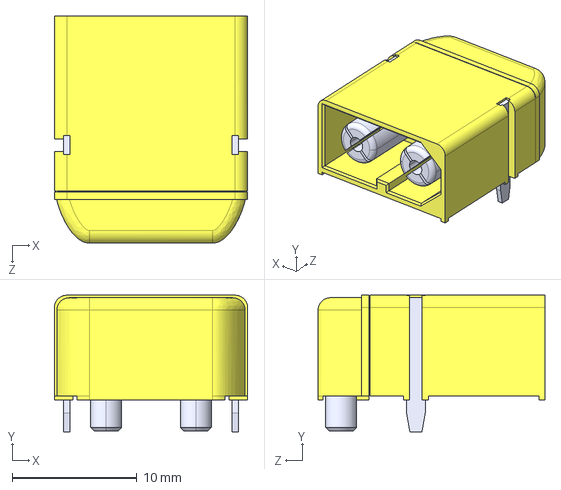
[picture p21: CAD file, 2024-03-14]
Hardware/Kicad 3D/XT60PW-M--3DModel-STEP-269445.STEP
15.5 x 11.0 x 18.2 mm
