AeroKITties/Kitties-Hardware/Hardware/Kicad 3D/LED_3528_RGB.STEP

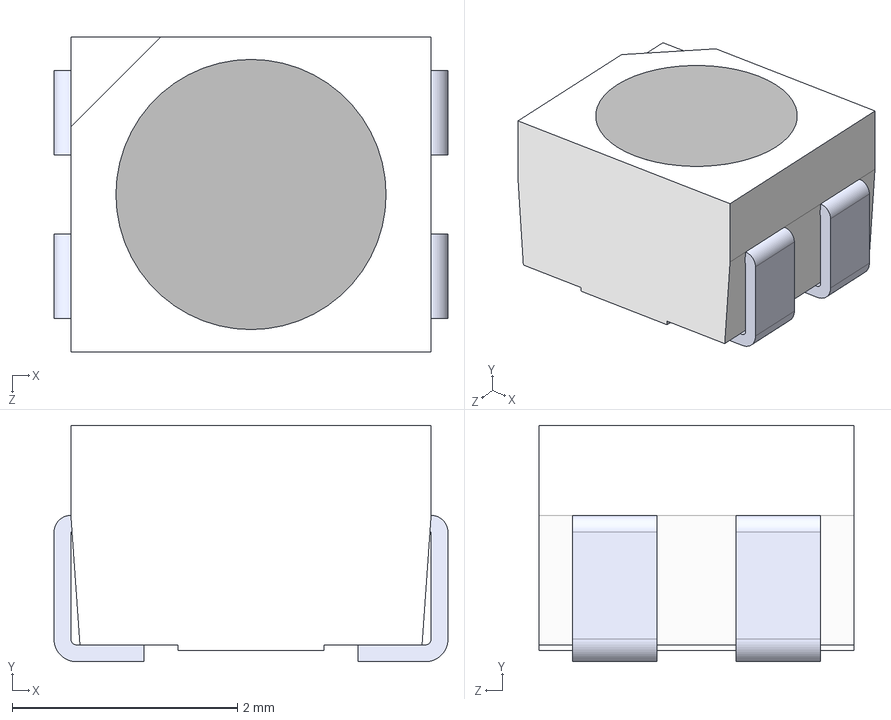
[picture p22: CAD file, 2024-03-14]
Hardware/Kicad 3D/LED_3528_RGB.STEP
3.50 x 2.10 x 2.80 mm
