AeroKITties/Kitties-Hardware/Hardware/Kicad 3D/TLP291GB-TPSE.STEP

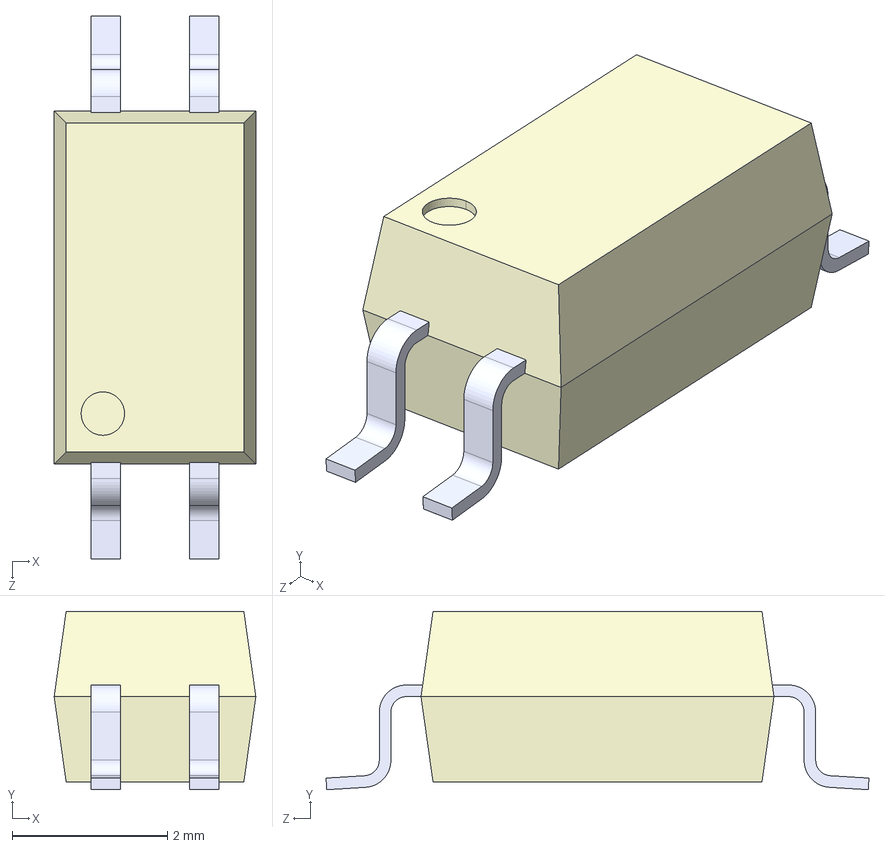
[picture p23: CAD file, 2024-03-14]
Hardware/Kicad 3D/TLP291GB-TPSE.STEP
2.60 x 2.30 x 7.00 mm
