AeroKITties/Kitties-Hardware/Hardware/Kicad 3D/g3vm-61d1.stp

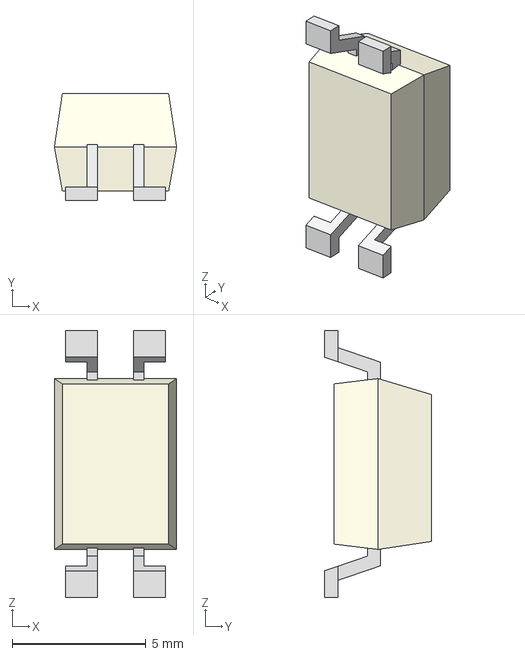
[picture p24: CAD file, 2024-03-14]
Hardware/Kicad 3D/g3vm-61d1.stp
4.58 x 4.00 x 10.0 mm
