AeroKITties/Kitties-Hardware/Hardware/Kicad 3D/NRP-12-C-05D-H.STEP

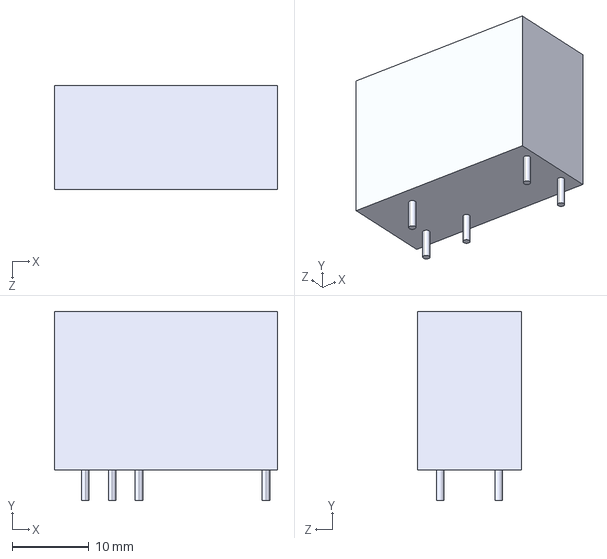
[picture p25: CAD file, 2024-03-14]
Hardware/Kicad 3D/NRP-12-C-05D-H.STEP
29.0 x 24.6 x 13.5 mm
