AeroKITties/Kitties-Hardware/Hardware/Kicad 3D/tel5_single_3d_drawing.stp

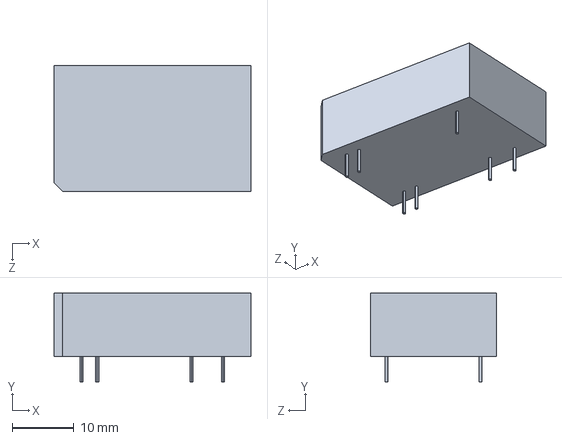
[picture p26: CAD file, 2024-03-14]
Hardware/Kicad 3D/tel5_single_3d_drawing.stp
31.8 x 14.3 x 20.3 mm
