AeroKITties/Kitties-Hardware/Hardware/Kicad 3D/KLS5-CR2032-01_battery_holder.stp

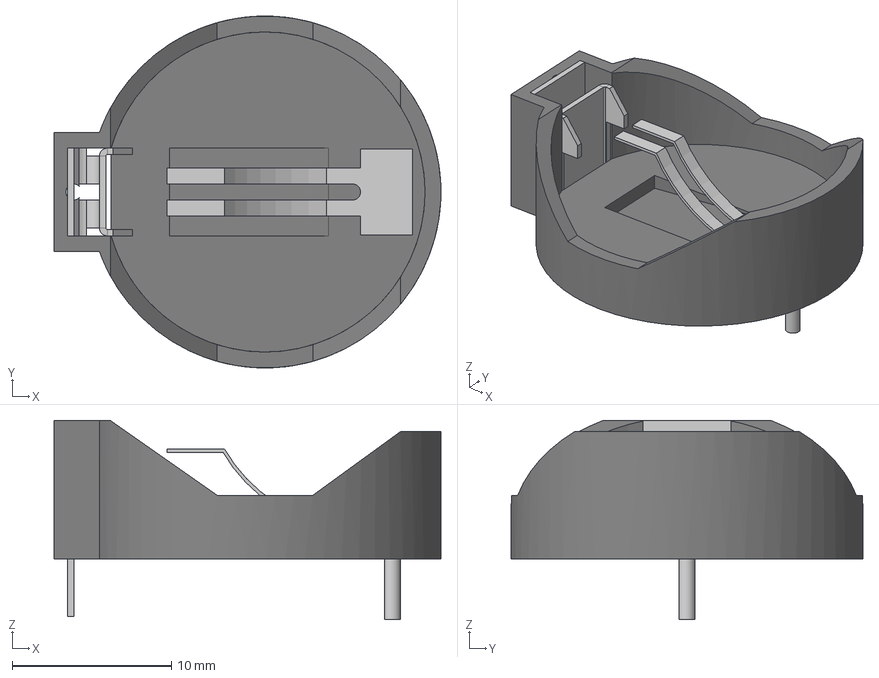
[picture p27: CAD file, 2024-03-14]
Hardware/Kicad 3D/KLS5-CR2032-01_battery_holder.stp
24.3 x 22.1 x 12.5 mm
