AeroKITties/Kitties-Hardware/Hardware/Kicad 3D/Molex_PicoBlade_1x02_P1.25mm_Vertical.stp

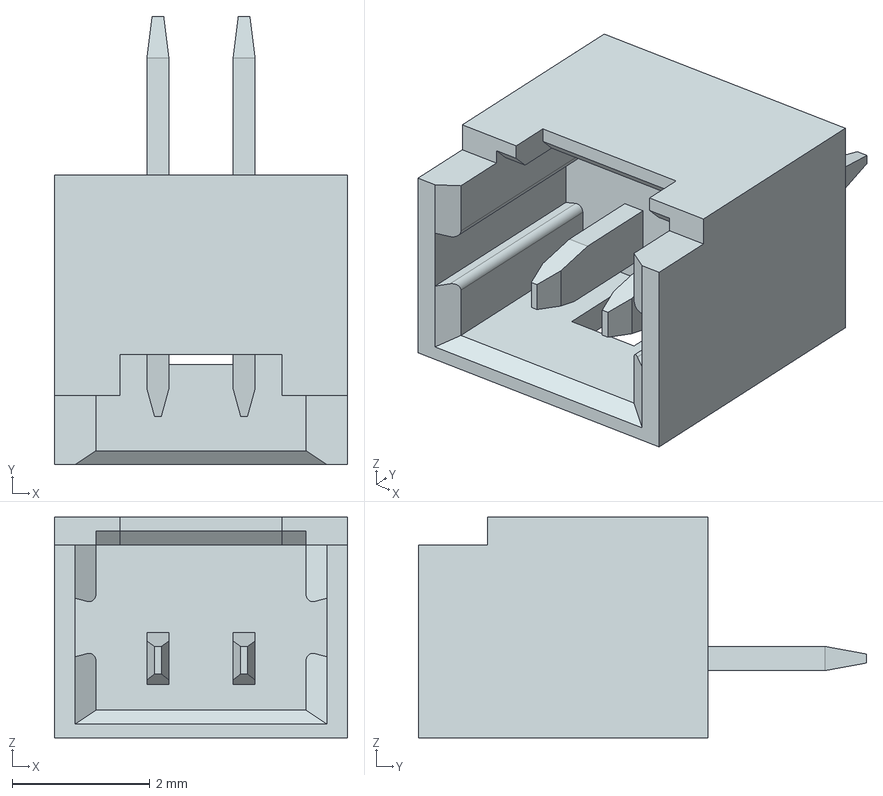
[picture p28: CAD file, 2024-03-14]
Hardware/Kicad 3D/Molex_PicoBlade_1x02_P1.25mm_Vertical.stp
4.25 x 6.50 x 3.20 mm
