AeroKITties/Kitties-Hardware/Hardware/Kicad 3D/Micro-Fit 3_0 Vertical Header, 3_00mm Pitch, Dual Row, 2 Circuits.stp

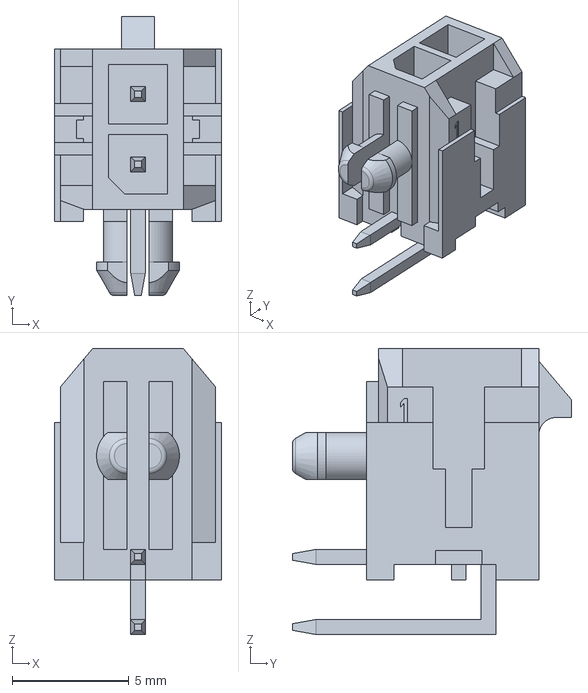
[picture p29: CAD file, 2024-03-14]
Hardware/Kicad 3D/Micro-Fit 3_0 Vertical Header, 3_00mm Pitch, Dual Row, 2 Circuits.stp
7.15 x 11.9 x 12.2 mm
