AeroKITties/Kitties-Hardware/Hardware/Kicad 3D/Micro-Fit 3_0 Vertical Header, 3_00mm Pitch, Dual Row, 10 Circuits.stp

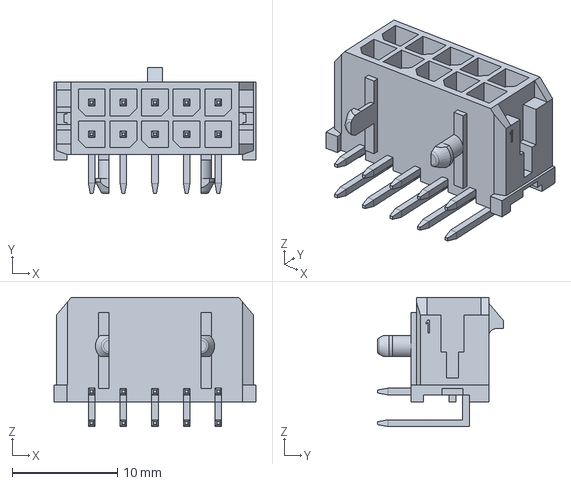
[picture p32: CAD file, 2024-03-14]
Hardware/Kicad 3D/Micro-Fit 3_0 Vertical Header, 3_00mm Pitch, Dual Row, 10 Circuits.stp
19.1 x 11.9 x 12.2 mm
