AeroKITties/Kitties-Hardware/Hardware/Kicad 3D/B0505MT-1WR4--3DModel-STEP-269445.STEP

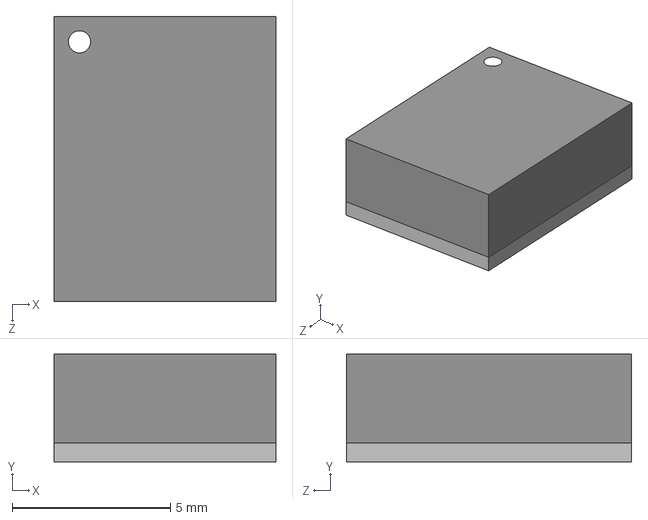
[picture p33: CAD file, 2024-03-14]
Hardware/Kicad 3D/B0505MT-1WR4--3DModel-STEP-269445.STEP
7.00 x 3.40 x 9.00 mm
