AeroKITties/Kitties-Hardware/Hardware/Kicad 3D/BMI088.STEP

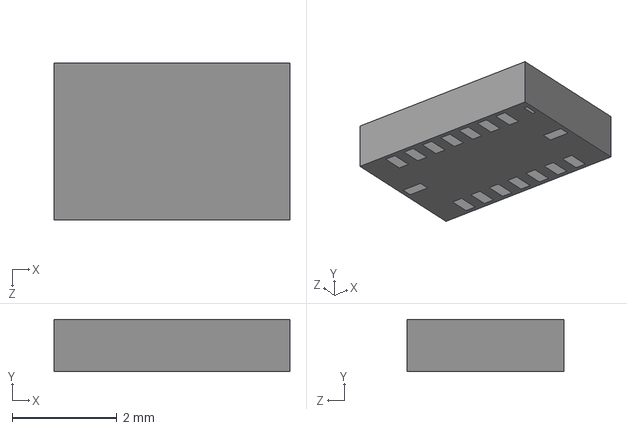
[picture p34: CAD file, 2023-06-28]
Hardware/Kicad 3D/BMI088.STEP
4.50 x 1.00 x 3.00 mm
