AeroKITties/Kitties-Hardware/Hardware/Kicad 3D/MAX7456.STEP

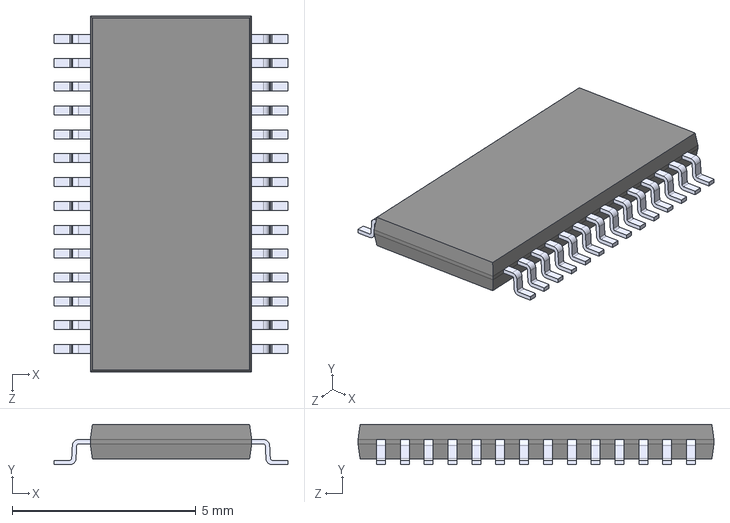
[picture p35: CAD file, 2023-06-28]
Hardware/Kicad 3D/MAX7456.STEP
6.38 x 1.10 x 9.70 mm
