AeroKITties/Kitties-Hardware/Hardware/Kicad 3D/Fuse_1206.STEP

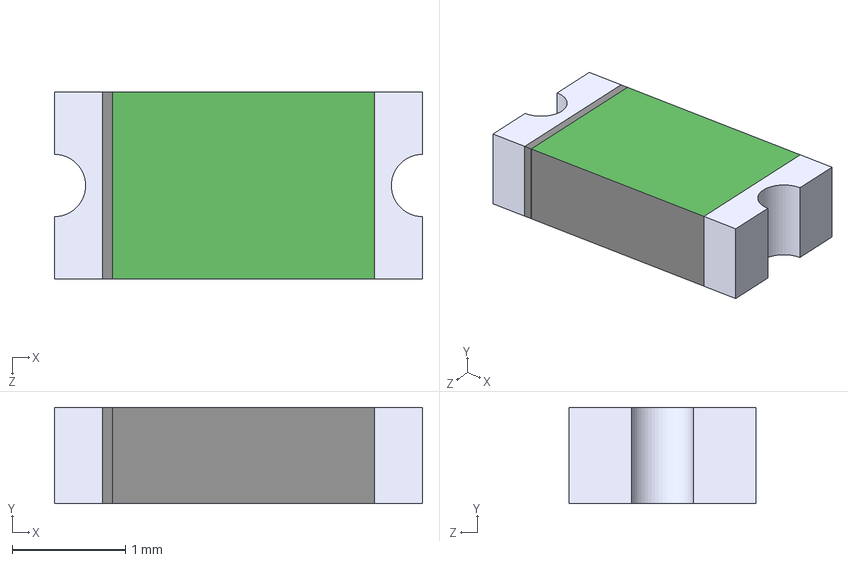
[picture p36: CAD file, 2023-06-28]
Hardware/Kicad 3D/Fuse_1206.STEP
3.25 x 0.85 x 1.65 mm
