AeroKITties/Kitties-Hardware/Hardware/Kicad 3D/Fuse_1812.STEP

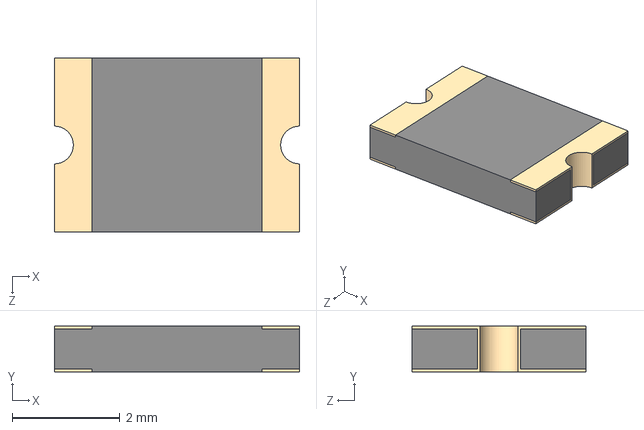
[picture p37: CAD file, 2023-06-28]
Hardware/Kicad 3D/Fuse_1812.STEP
4.55 x 0.85 x 3.24 mm
