AeroKITties/Kitties-Hardware/Hardware/Kicad 3D/BMP388.STEP

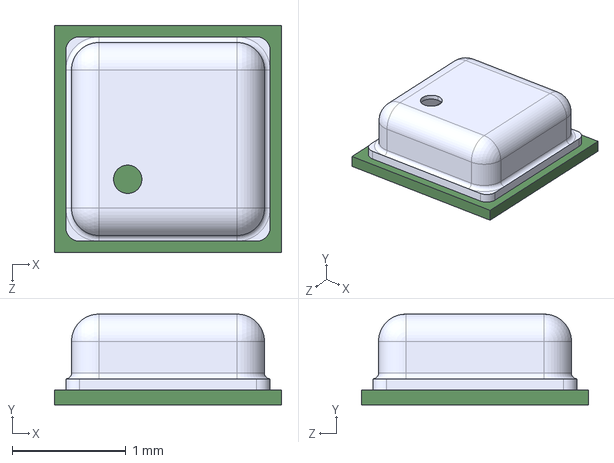
[picture p38: CAD file, 2023-06-28]
Hardware/Kicad 3D/BMP388.STEP
2.00 x 0.8 x 2.00 mm
