AeroKITties/Kitties-Hardware/Hardware/Kicad 3D/ICM-42688-P.STEP

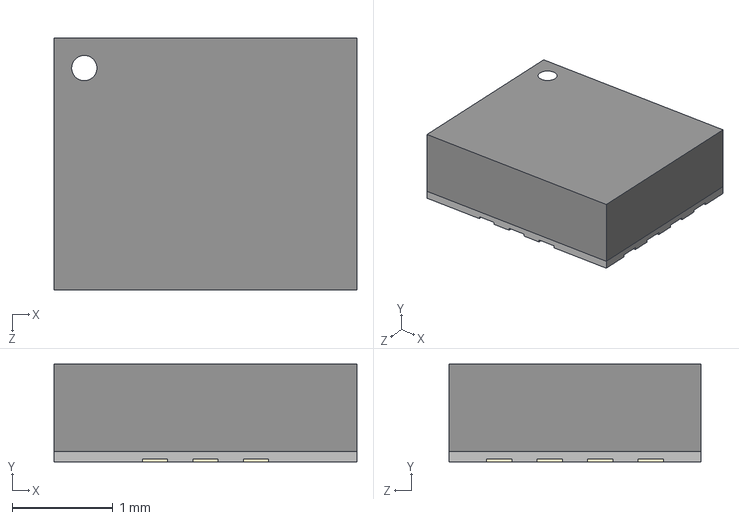
[picture p39: CAD file, 2023-06-28]
Hardware/Kicad 3D/ICM-42688-P.STEP
3.00 x 0.97 x 2.50 mm
