AeroKITties/Kitties-Hardware/Hardware/Kicad 3D/usb.STEP

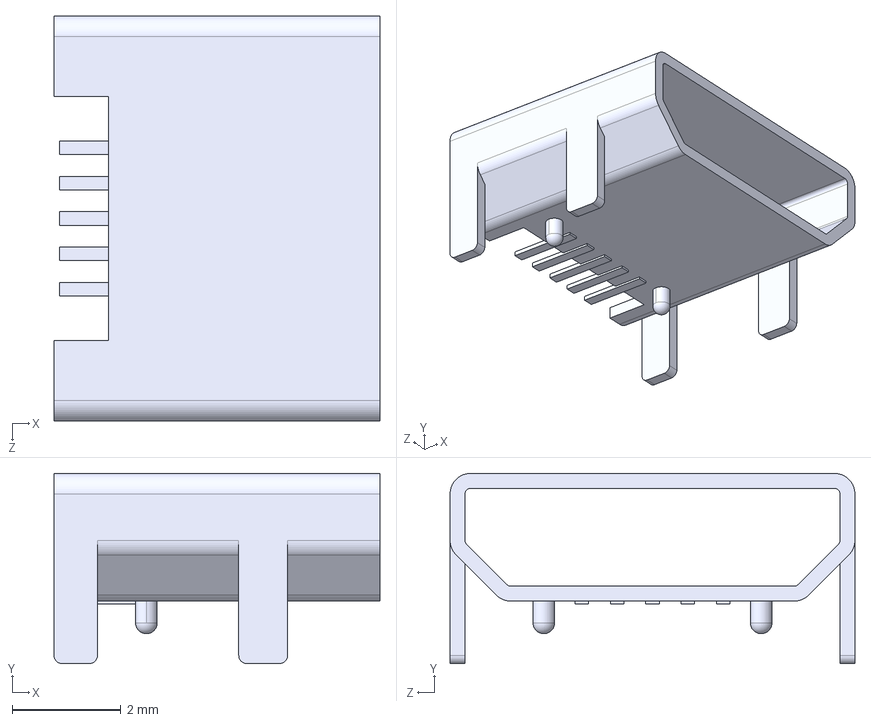
[picture p40: CAD file, 2023-06-28]
Hardware/Kicad 3D/usb.STEP
6.00 x 3.50 x 7.45 mm
