AeroKITties/Kitties-Hardware/Hardware/Kicad 3D/MPU-9250.STEP

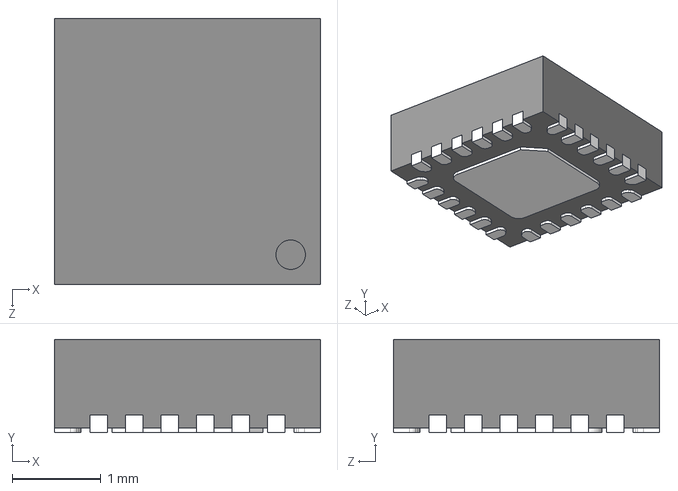
[picture p41: CAD file, 2023-06-28]
Hardware/Kicad 3D/MPU-9250.STEP
3.00 x 1.05 x 3.00 mm
