AeroKITties/Kitties-Hardware/Hardware/Kicad 3D/switch 6x6 smd.stp

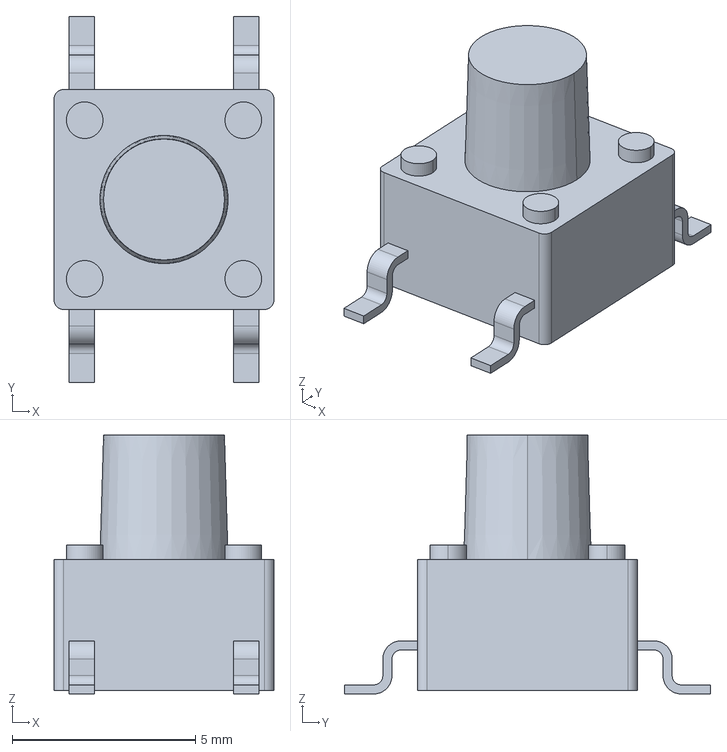
[picture p42: CAD file, 2023-06-28]
Hardware/Kicad 3D/switch 6x6 smd.stp
6.00 x 10.0 x 7.07 mm
