AeroKITties/Kitties-Hardware/Hardware/Kicad 3D/usb_A.stp

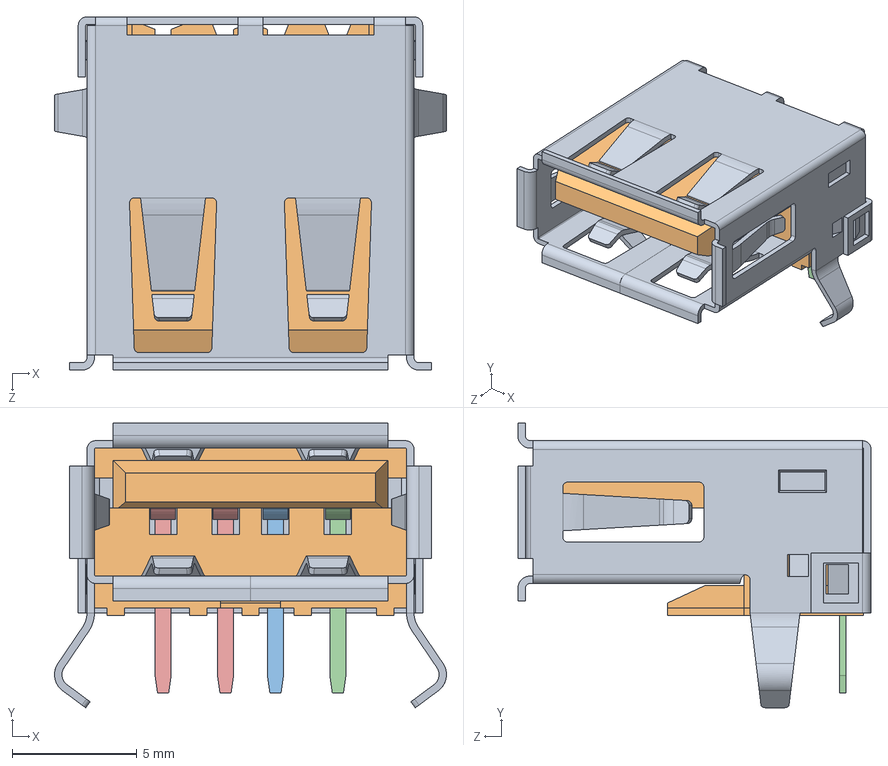
[picture p43: CAD file, 2023-02-15]
Hardware/Kicad 3D/usb_A.stp
15.7 x 11.4 x 14.1 mm
Cover
Internal Part
Pin
