AeroKITties/Kitties-Hardware/Hardware/Kicad 3D/usb_A_1.stp

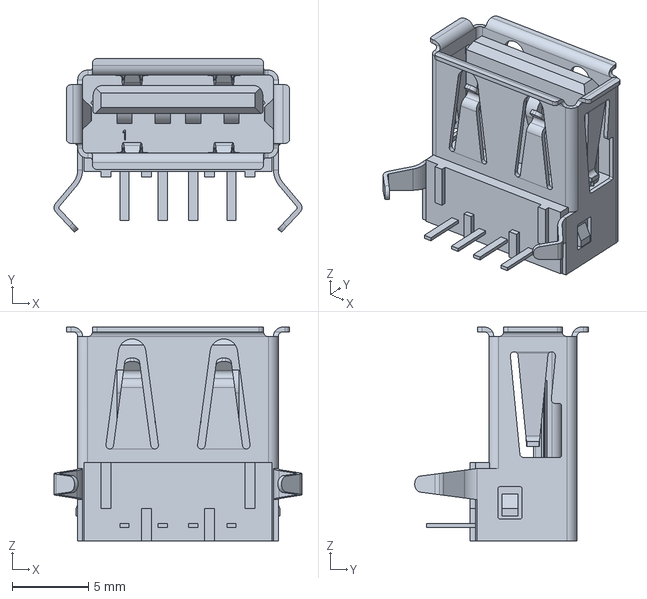
[picture p44: CAD file, 2023-02-15]
Hardware/Kicad 3D/usb_A_1.stp
16.2 x 11.4 x 14.0 mm
