AeroKITties/Kitties-Hardware/Hardware/Kicad 3D/Molex_PicoBlade_53047-0710_1x07_P1.25mm_Vertical.stp

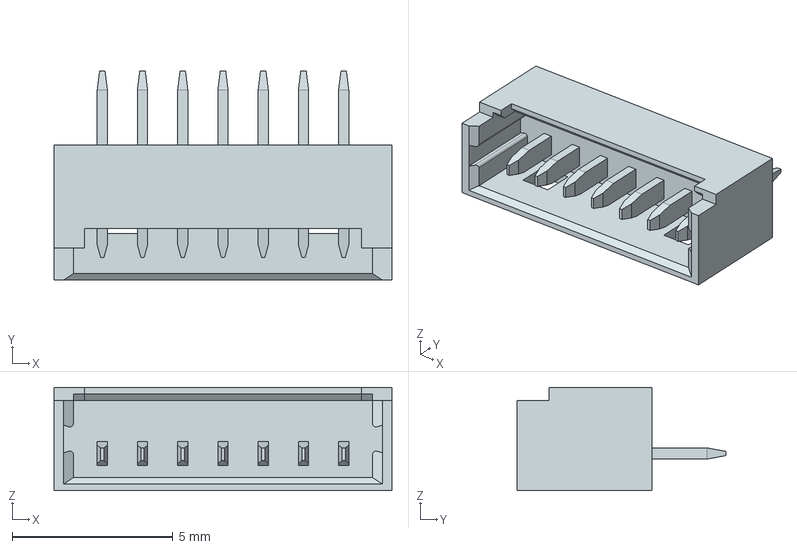
[picture p45: CAD file, 2023-02-15]
Hardware/Kicad 3D/Molex_PicoBlade_53047-0710_1x07_P1.25mm_Vertical.stp
10.5 x 6.50 x 3.20 mm
