AeroKITties/Kitties-Hardware/Hardware/Kicad 3D/Molex_PicoBlade_53047-0610_1x06_P1.25mm_Vertical.stp

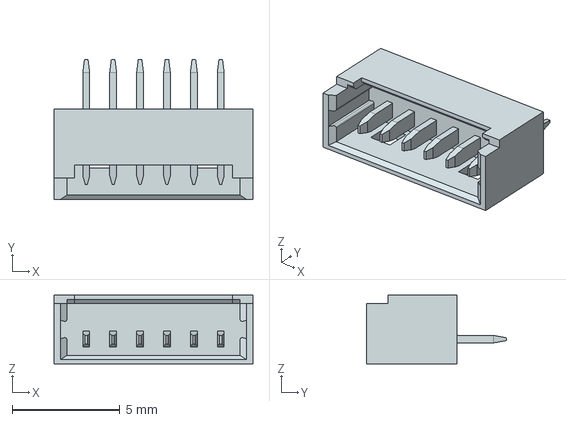
[picture p46: CAD file, 2022-10-11]
Hardware/Kicad 3D/Molex_PicoBlade_53047-0610_1x06_P1.25mm_Vertical.stp
9.25 x 6.50 x 3.20 mm
