AeroKITties/Kitties-Hardware/Hardware/Kicad 3D/NEO.STEP

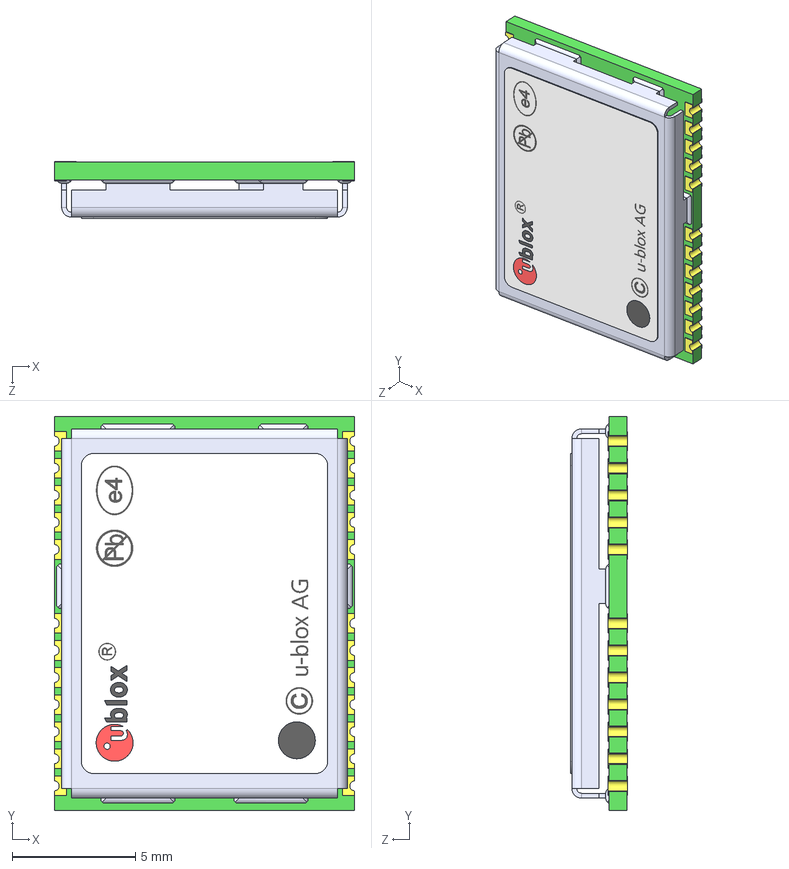
[picture p47: CAD file, 2022-10-11]
Hardware/Kicad 3D/NEO.STEP
12.2 x 16.0 x 2.33 mm
NEO_PCB
Shield_NEO
u-blox_NEO_label
