AeroKITties/Kitties-Hardware/Hardware/Kicad 3D/Molex_PicoBlade_53047-0410_1x04_P1.25mm_Vertical.stp

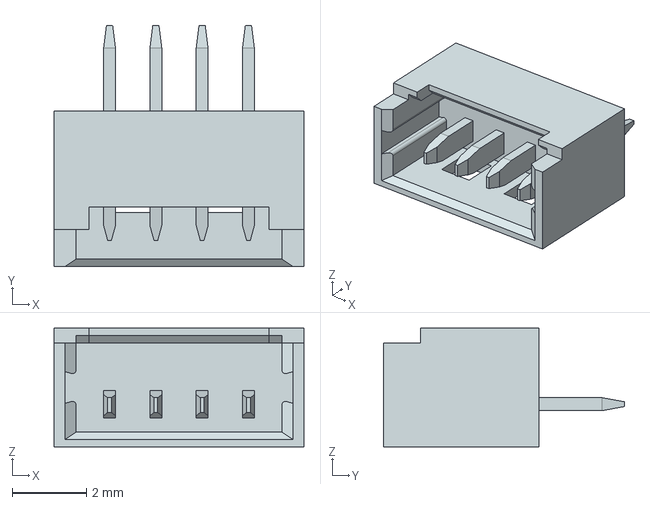
[picture p48: CAD file, 2022-10-11]
Hardware/Kicad 3D/Molex_PicoBlade_53047-0410_1x04_P1.25mm_Vertical.stp
6.75 x 6.50 x 3.20 mm
