AeroKITties/Kitties-Hardware/Hardware/Kicad 3D/smd1812.stp

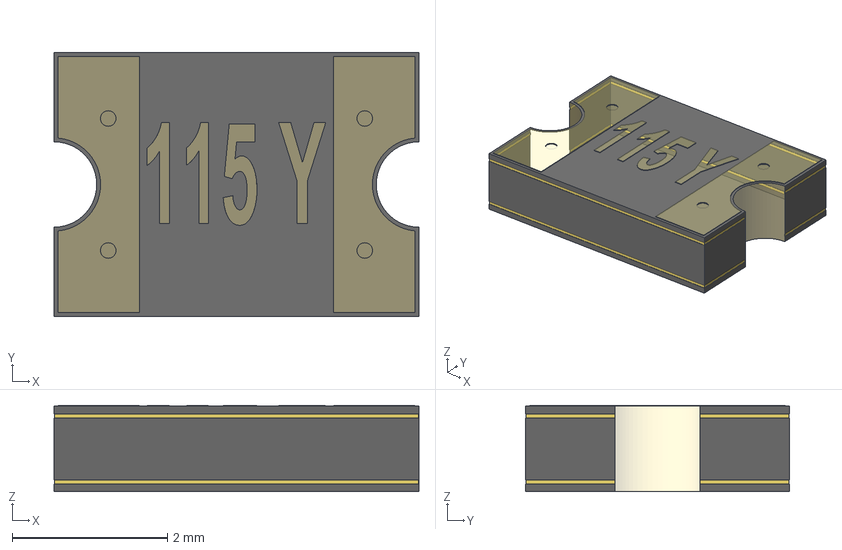
[picture p49: CAD file, 2022-10-11]
Hardware/Kicad 3D/smd1812.stp
4.70 x 3.40 x 1.11 mm
