AeroKITties/Kitties-Hardware/Hardware/Kicad 3D/SMA-angled.STEP

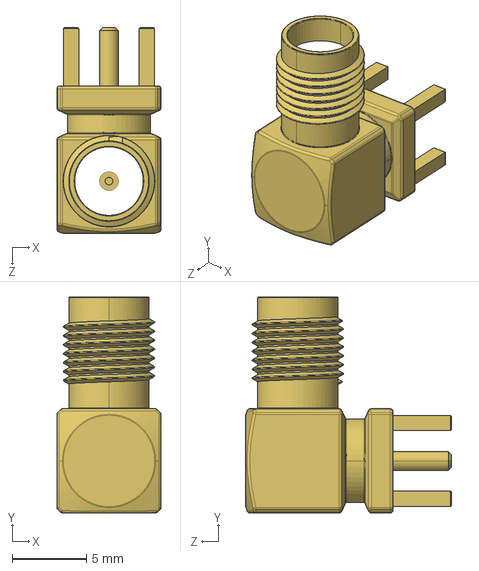
[picture p50: CAD file, 2022-10-11]
Hardware/Kicad 3D/SMA-angled.STEP
7.00 x 14.5 x 13.8 mm
