AeroKITties/Kitties-Hardware/(list of files, cad)

Other CAD files:
Hardware/Kicad 3D/B82721-K2222-U30.step
Hardware/Kicad 3D/B82789_Series_SIMDAD1812_simplified_model.stp
Hardware/Kicad 3D/ISO1050DUB.STEP
