AeroKITties/Kitties-Hardware/Hardware/Royal Penguin/0.0/FC0 11.10.22.pdf

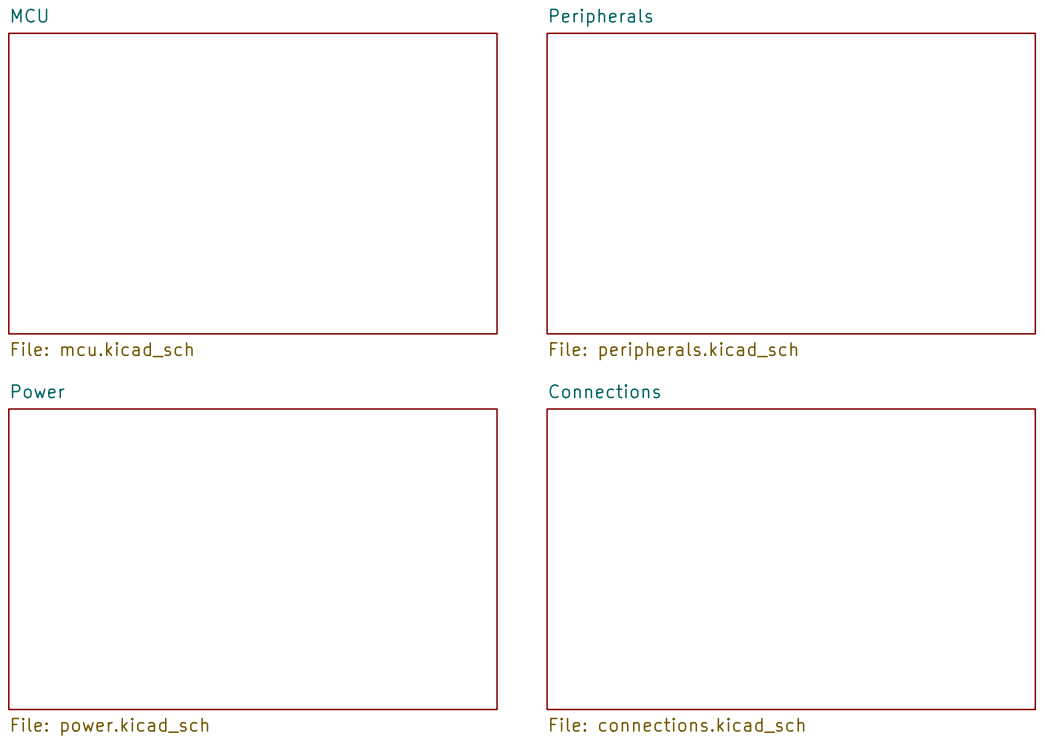
[picture p51: page 1]

Connections File: connections.kicad_sch MCU

File: peripherals.kicad_sch Power File: power.kicad_sch

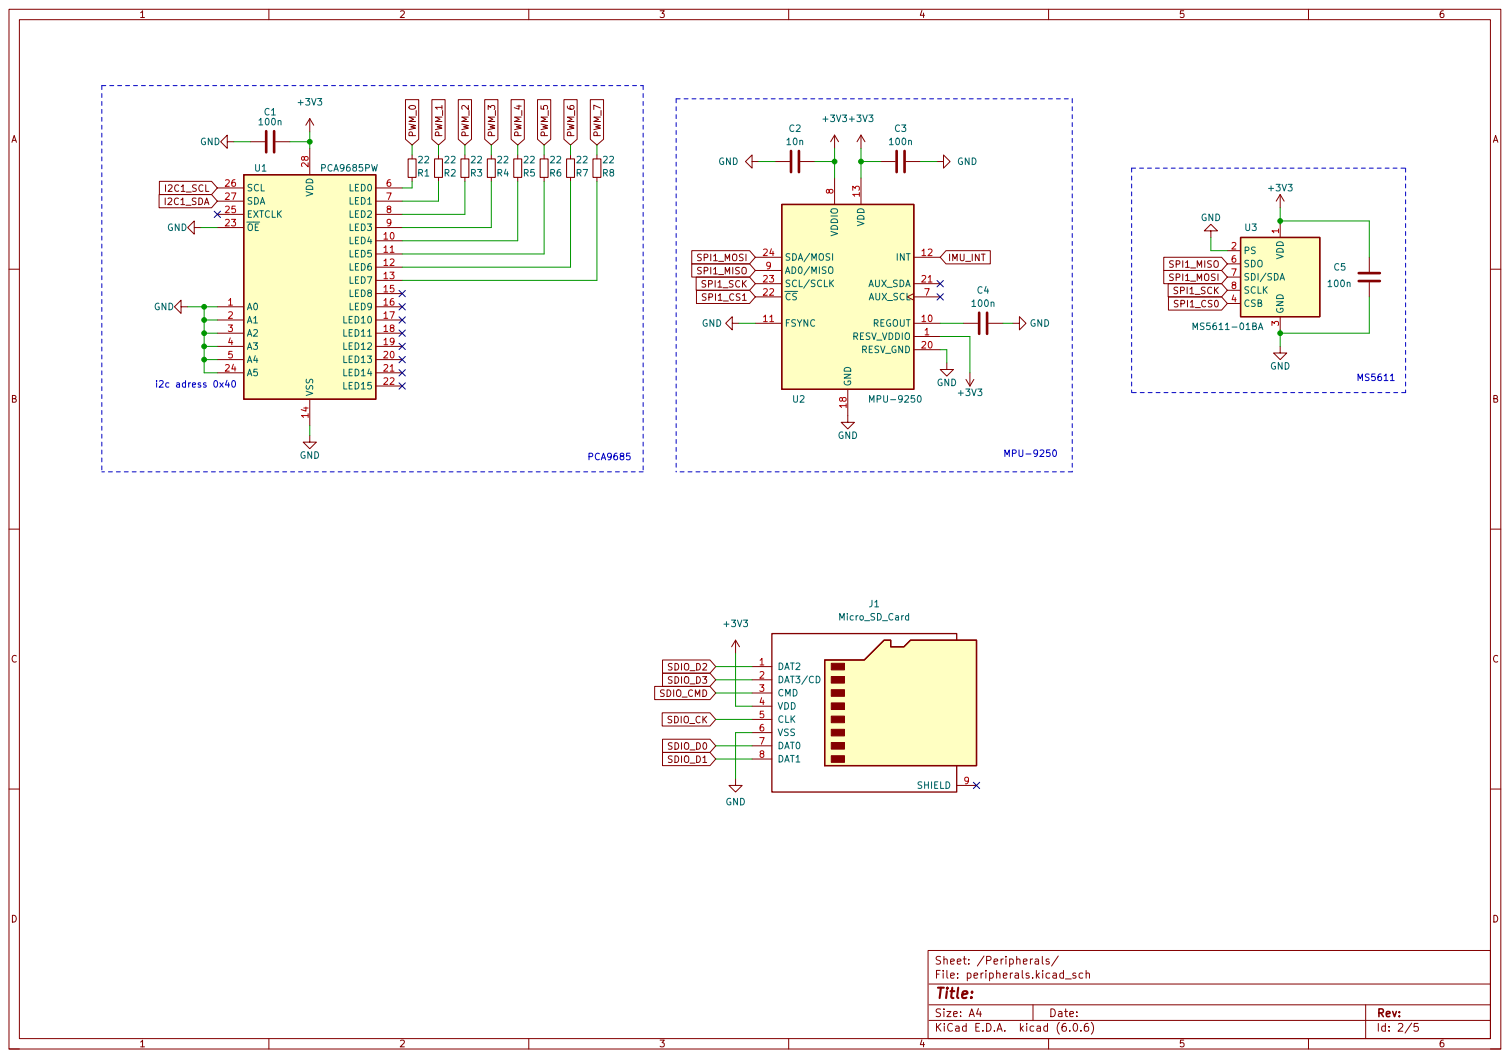
[picture p52: page 2]

8 AD0/MISO 9 U2 MPU-9250 GND GND

3 CSB 4 SDO 6 SDI/SDA 7 SCLK 8 U3 MS5611-01BA

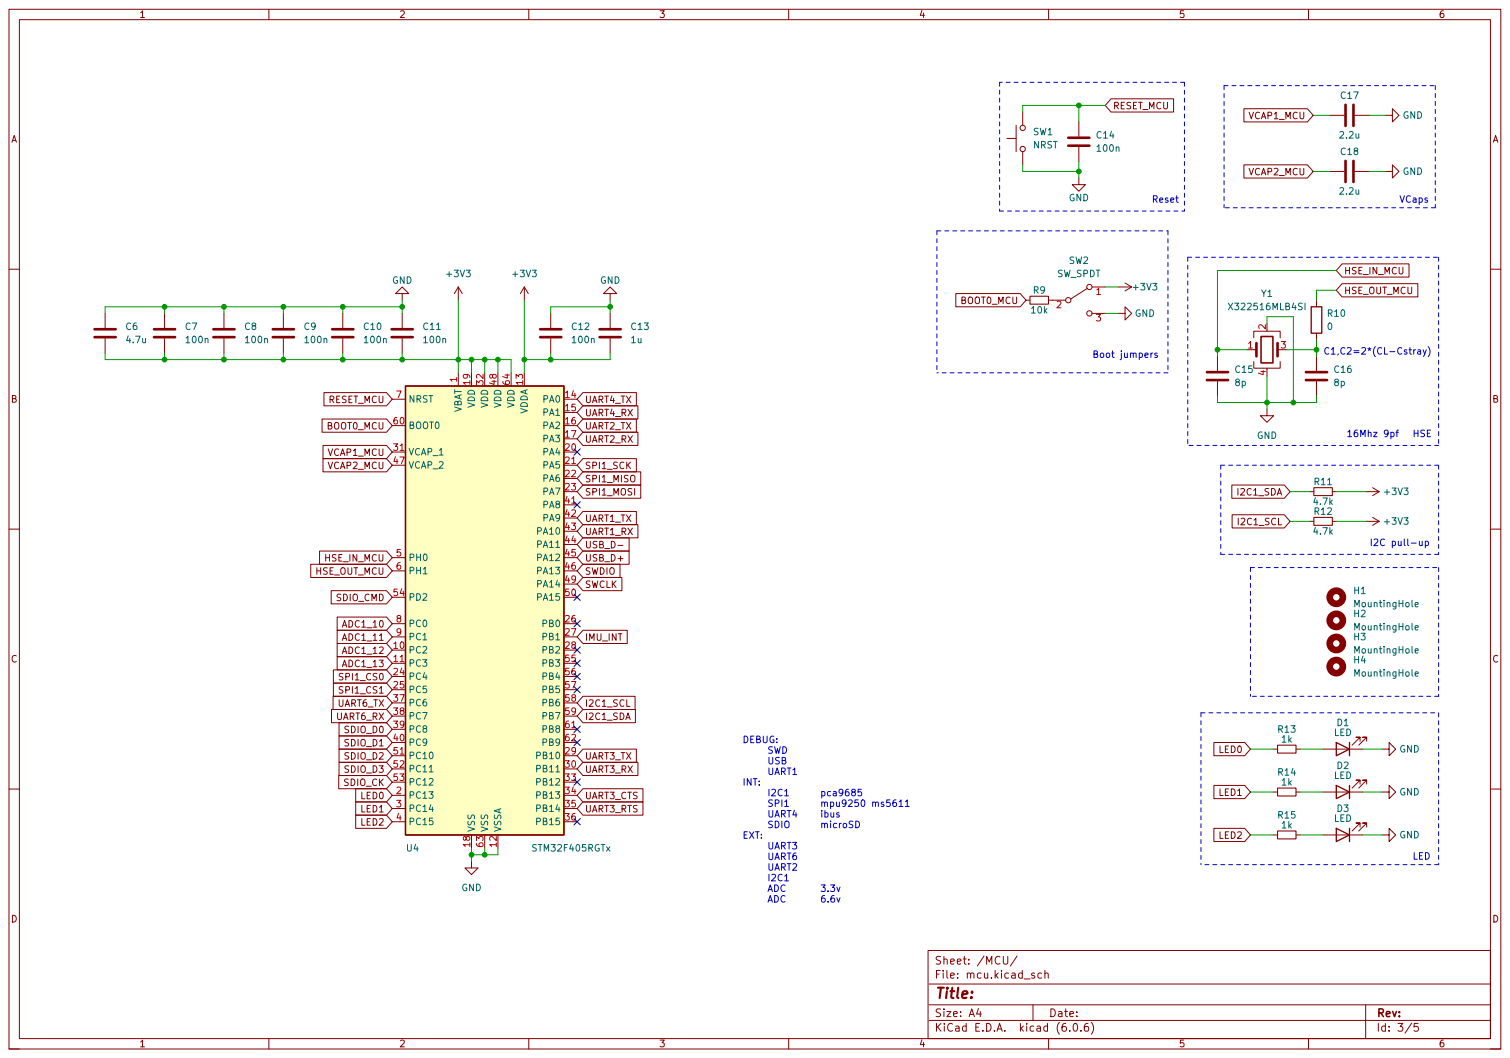
[picture p53: page 3]

I2C pull-upHSE C1,C2=2*(CL-Cstray) DEBUG:

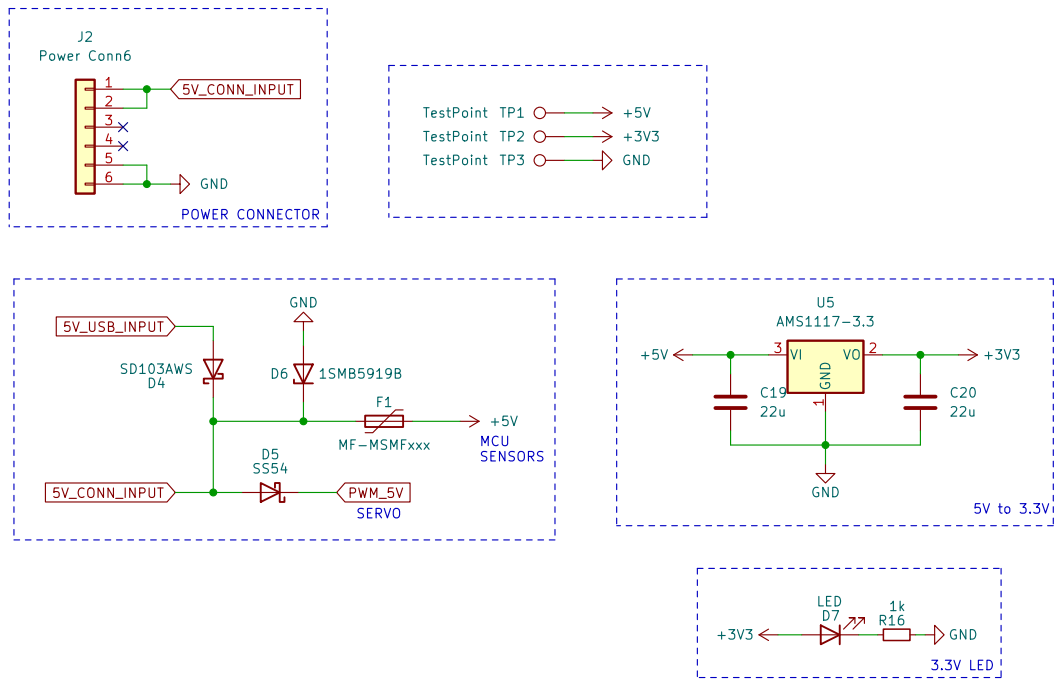
[picture p54: page 4]

File: power.kicad_sch Sheet: /Power/

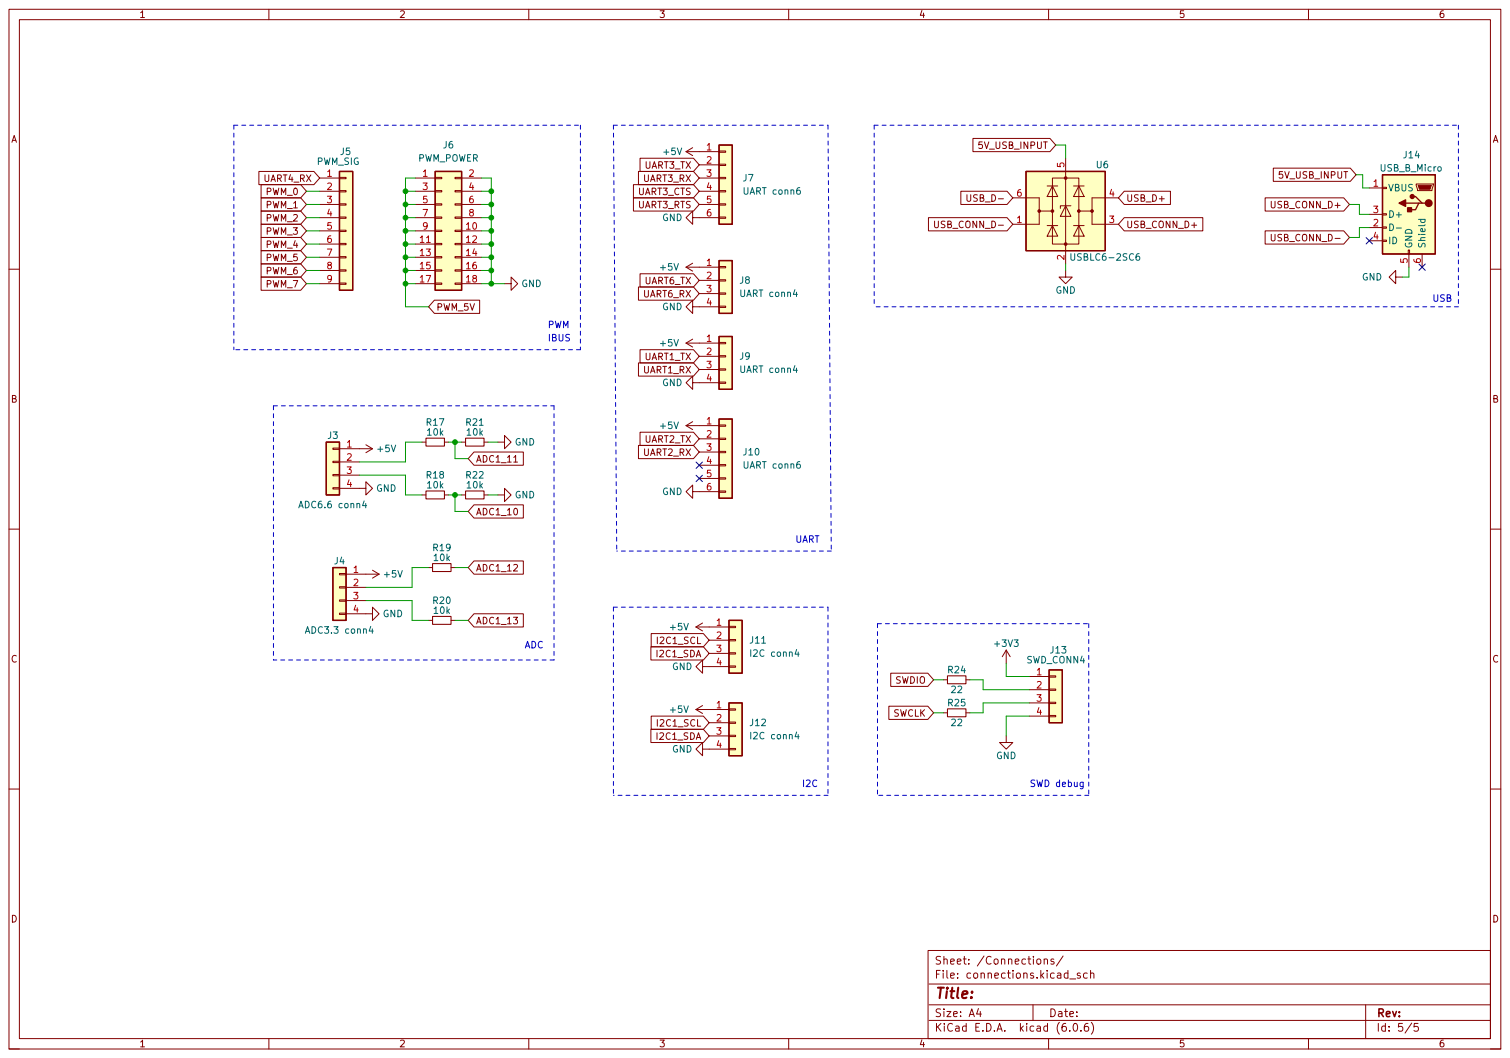
[picture p55: page 5]

13 | 14
15 | 16

File: connections.kicad_sch Sheet: /Connections/
