AeroKITties/Kitties-Hardware/Hardware/ciam/impeller/impeller/impeller_05_08_23_v2.pdf

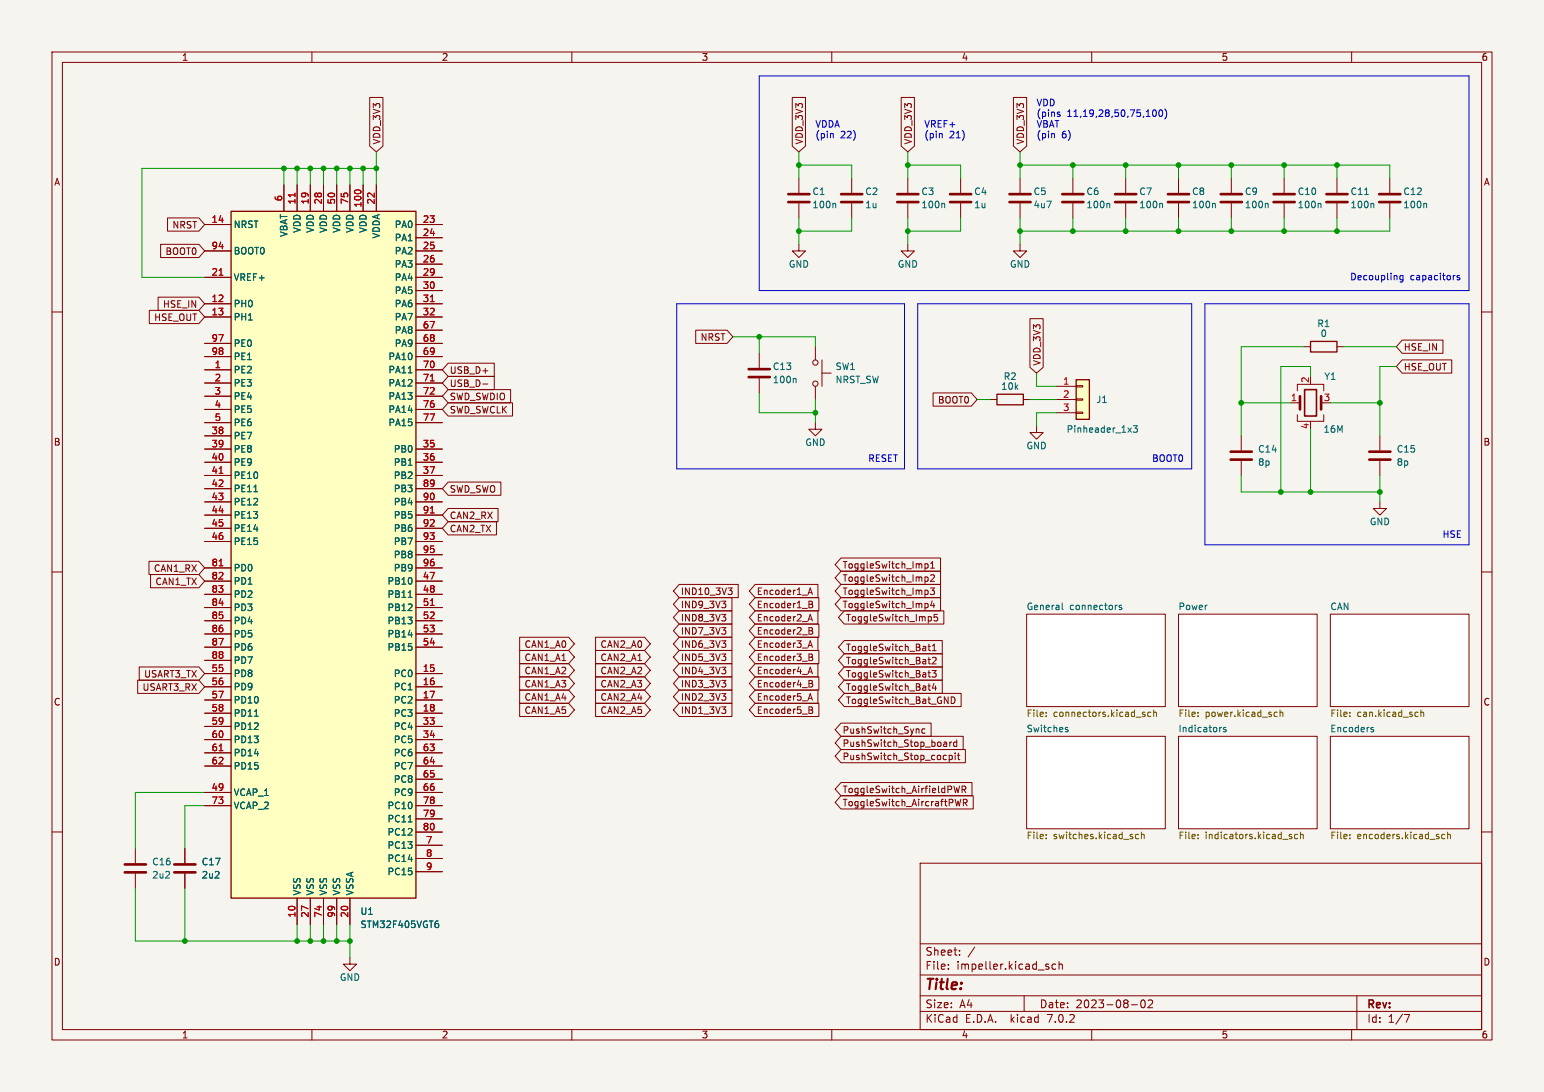
[picture p56: page 1]

Indicators File: indicators.kicad_sch Switches File: switches.kicad_sch General connectors File: connectors.kicad_sch

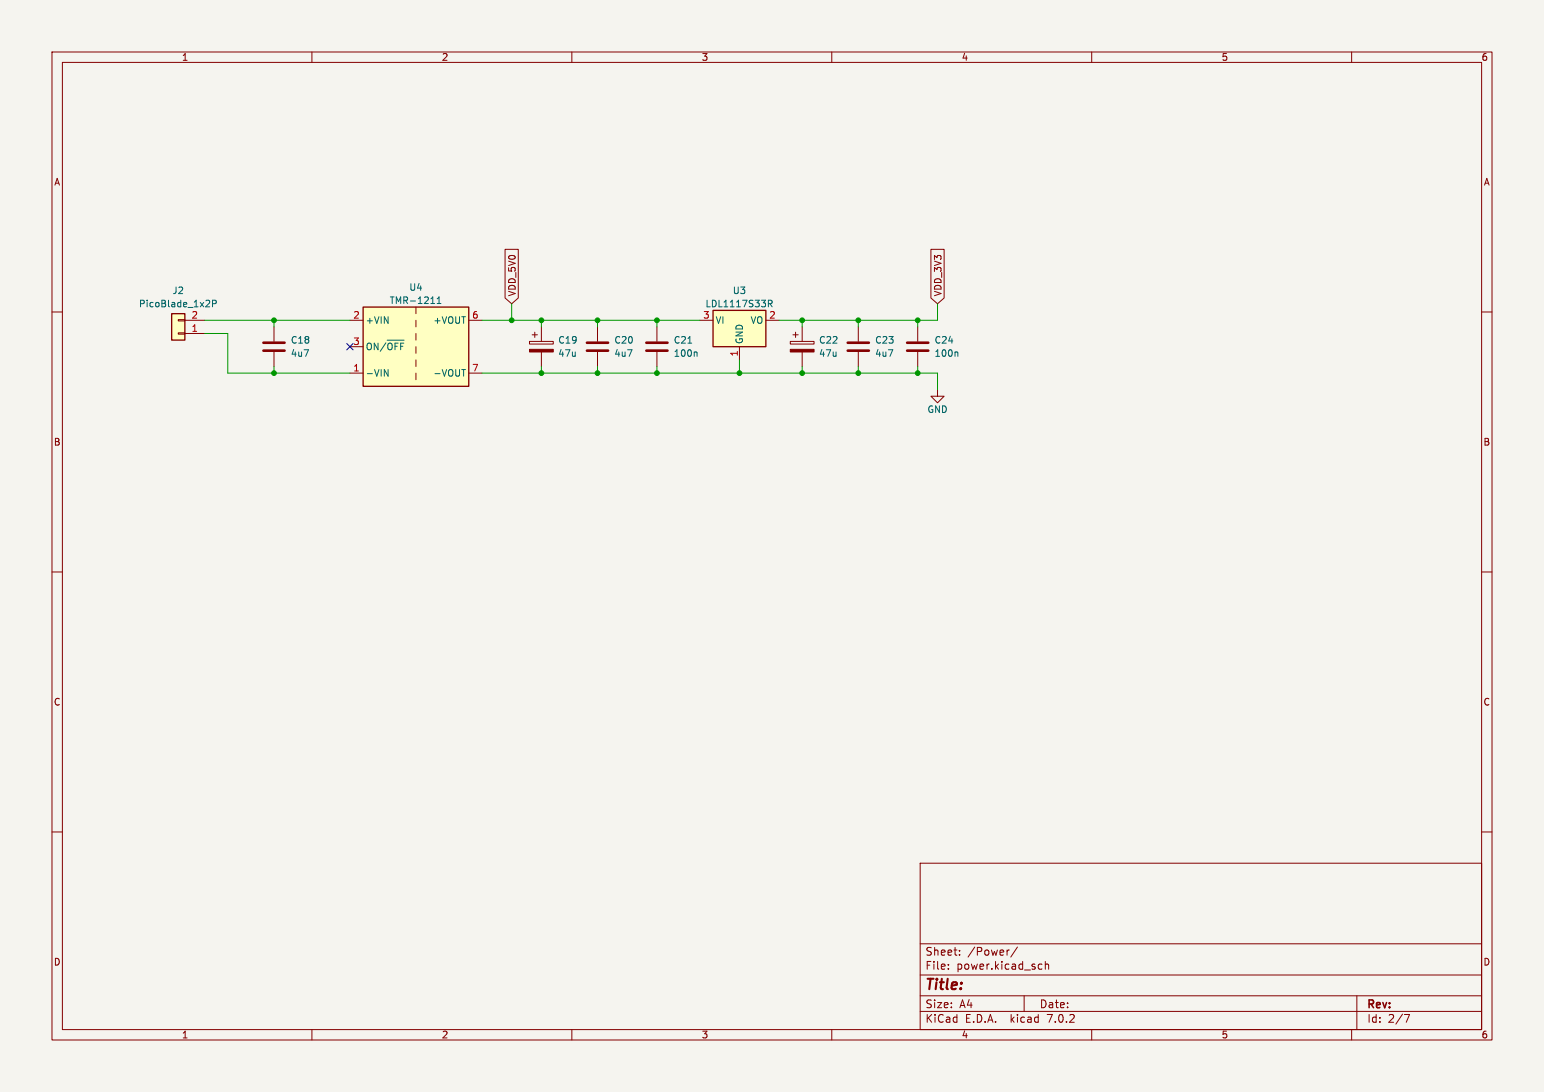
[picture p57: page 2]

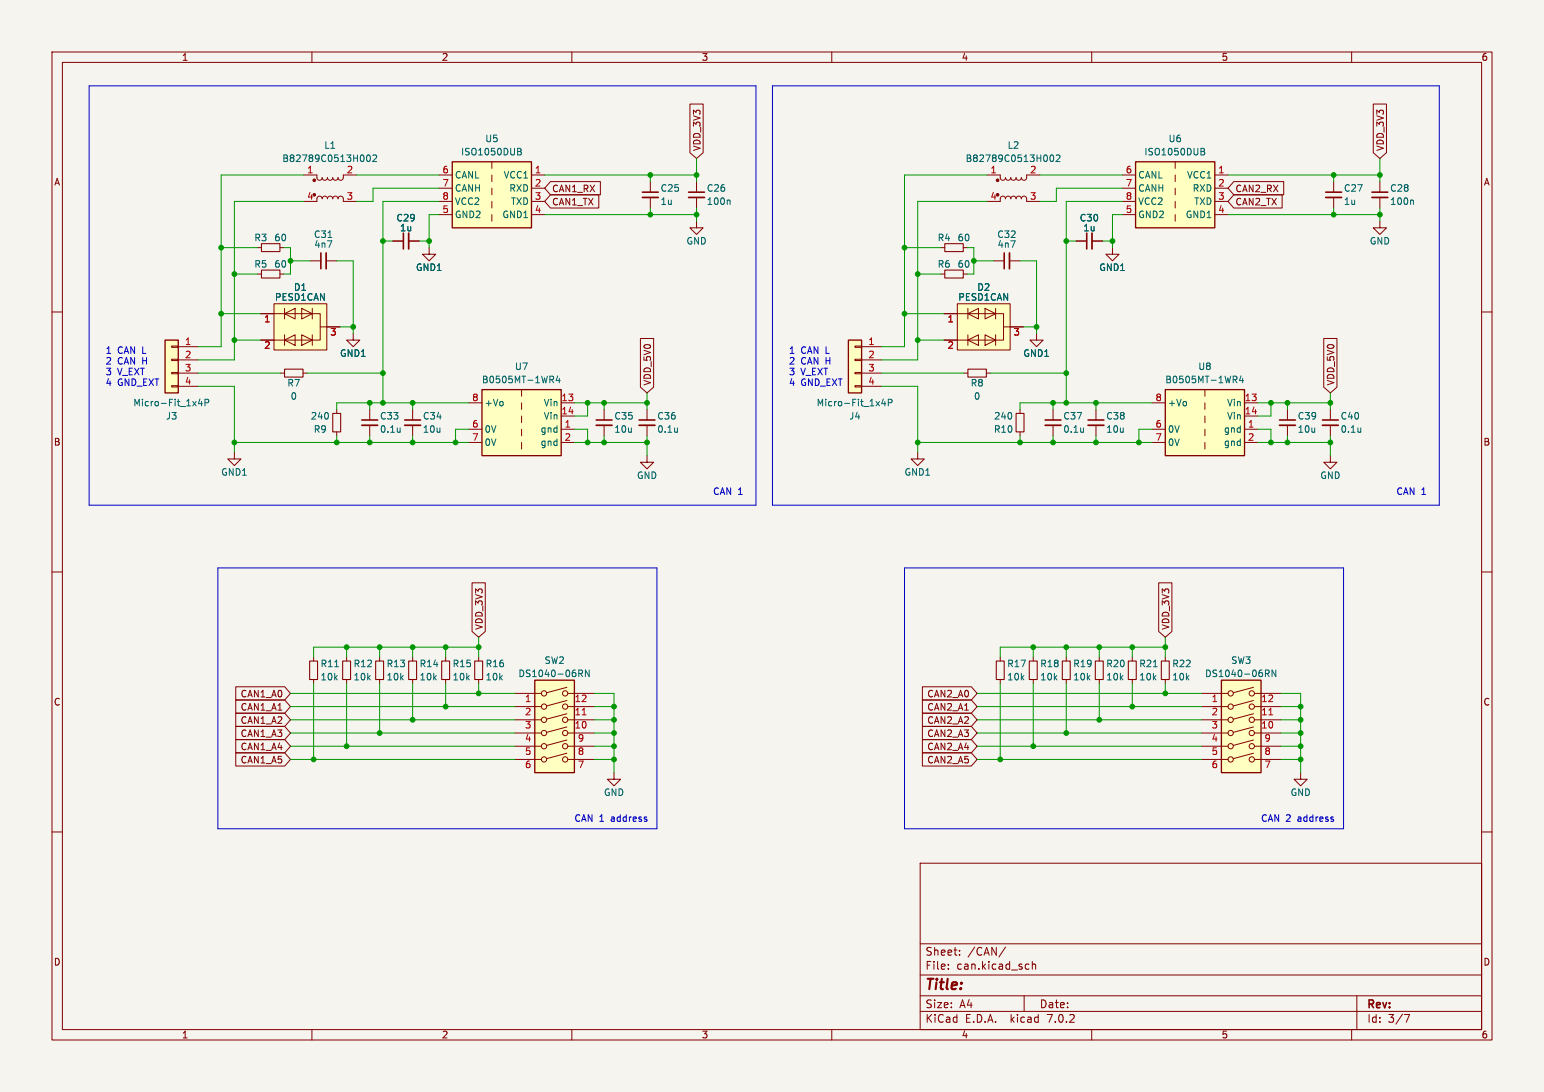
[picture p58: page 3]

Id: 3/7 Title: File: can.kicad_sch Sheet: /CAN/

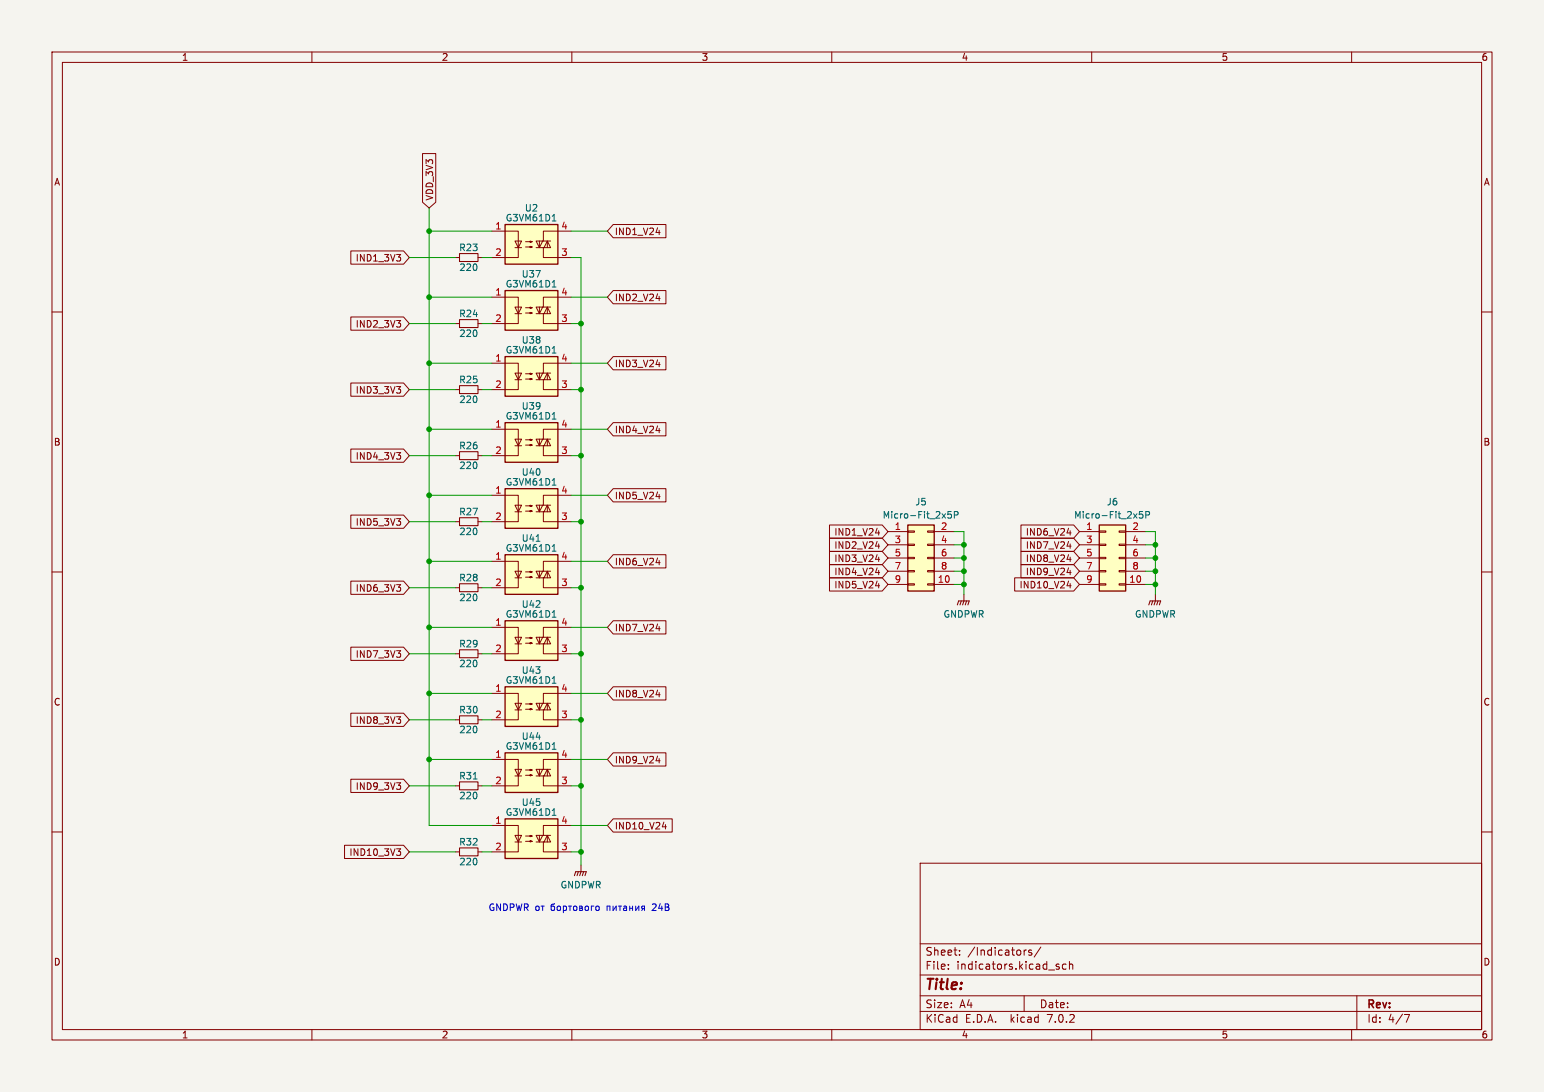
[picture p59: page 4]

IND4_V24 GNDPWR þÿ>Bþÿ1>@B>2>3> þÿ?8B0=8O þÿ24

J5 Micro-Fit_2x5P R32
Id: 4/7 Title: File: indicators.kicad_sch Sheet: /Indicators/ R27

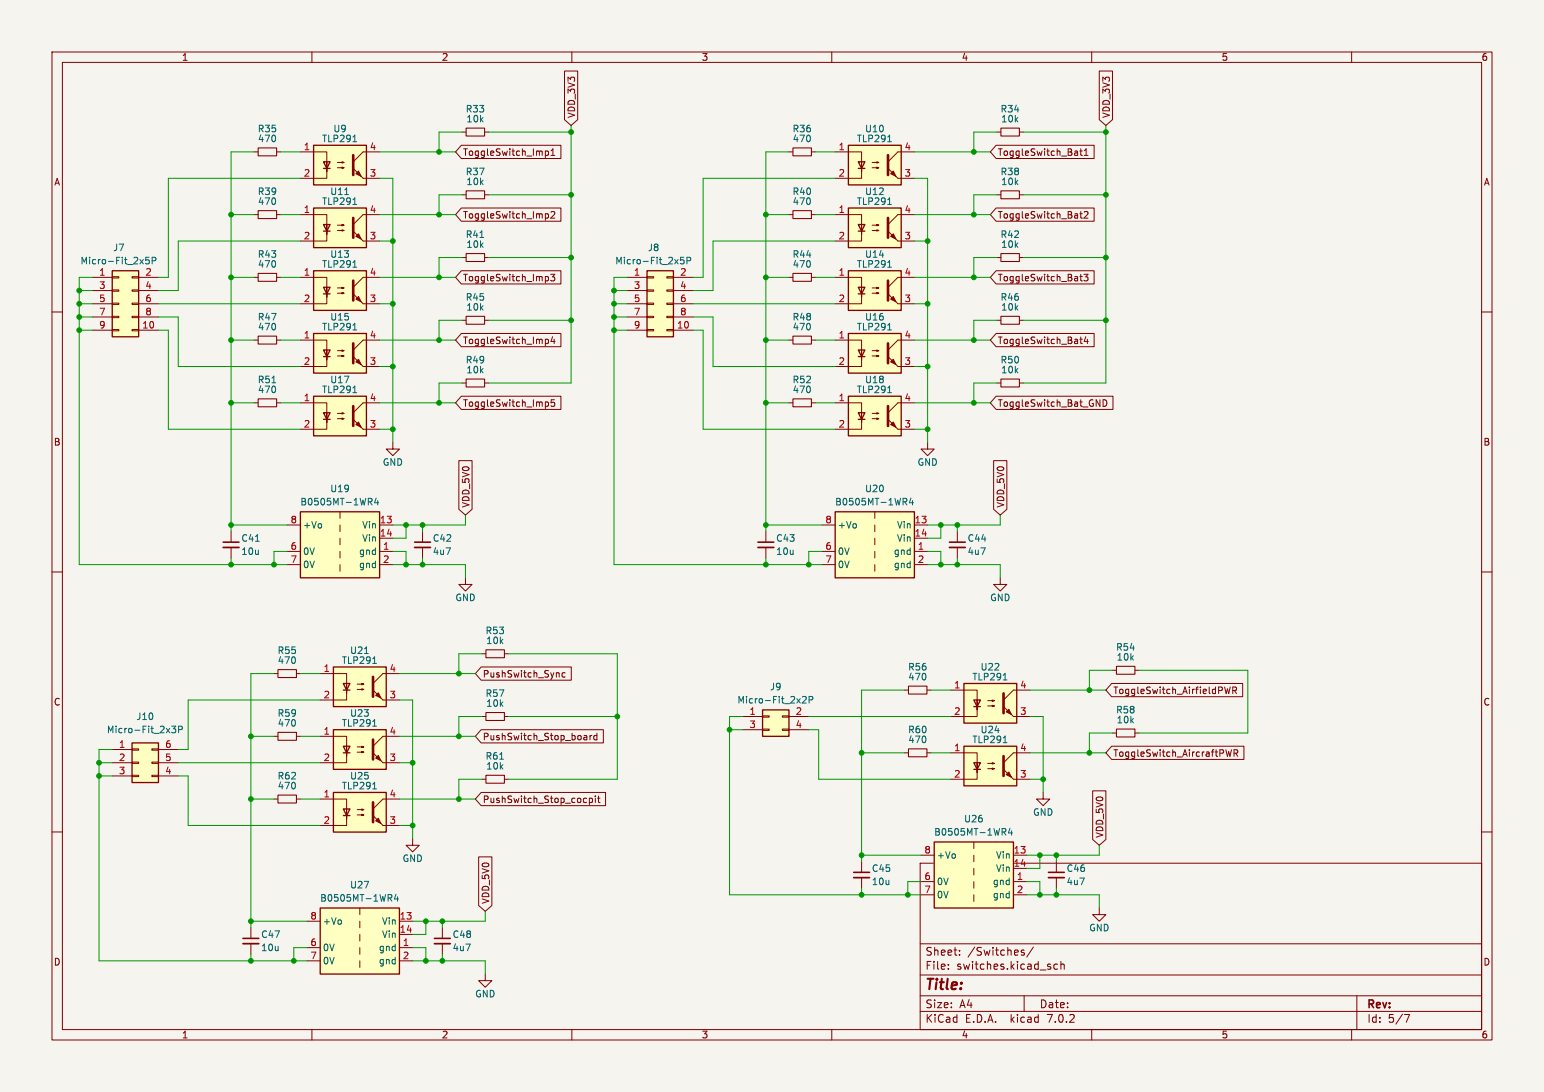
[picture p60: page 5]

Id: 5/7 Title: File: switches.kicad_sch Sheet: /Switches/

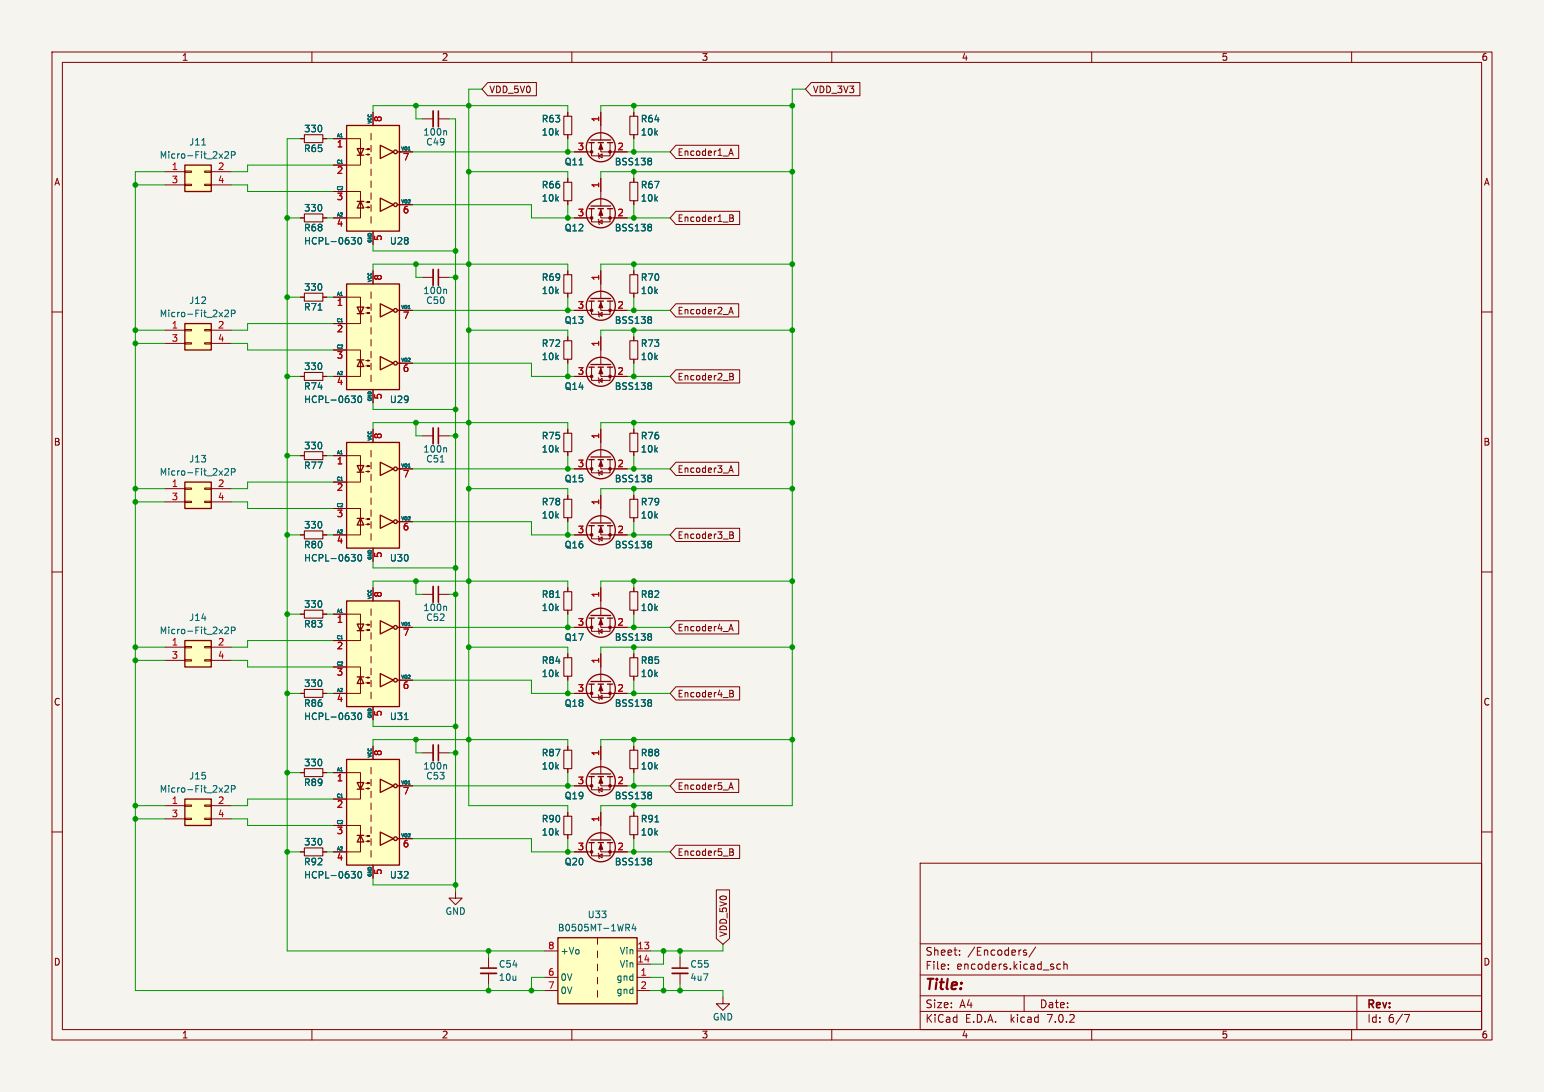
[picture p61: page 6]

Id: 6/7 Title: File: encoders.kicad_sch Sheet: /Encoders/

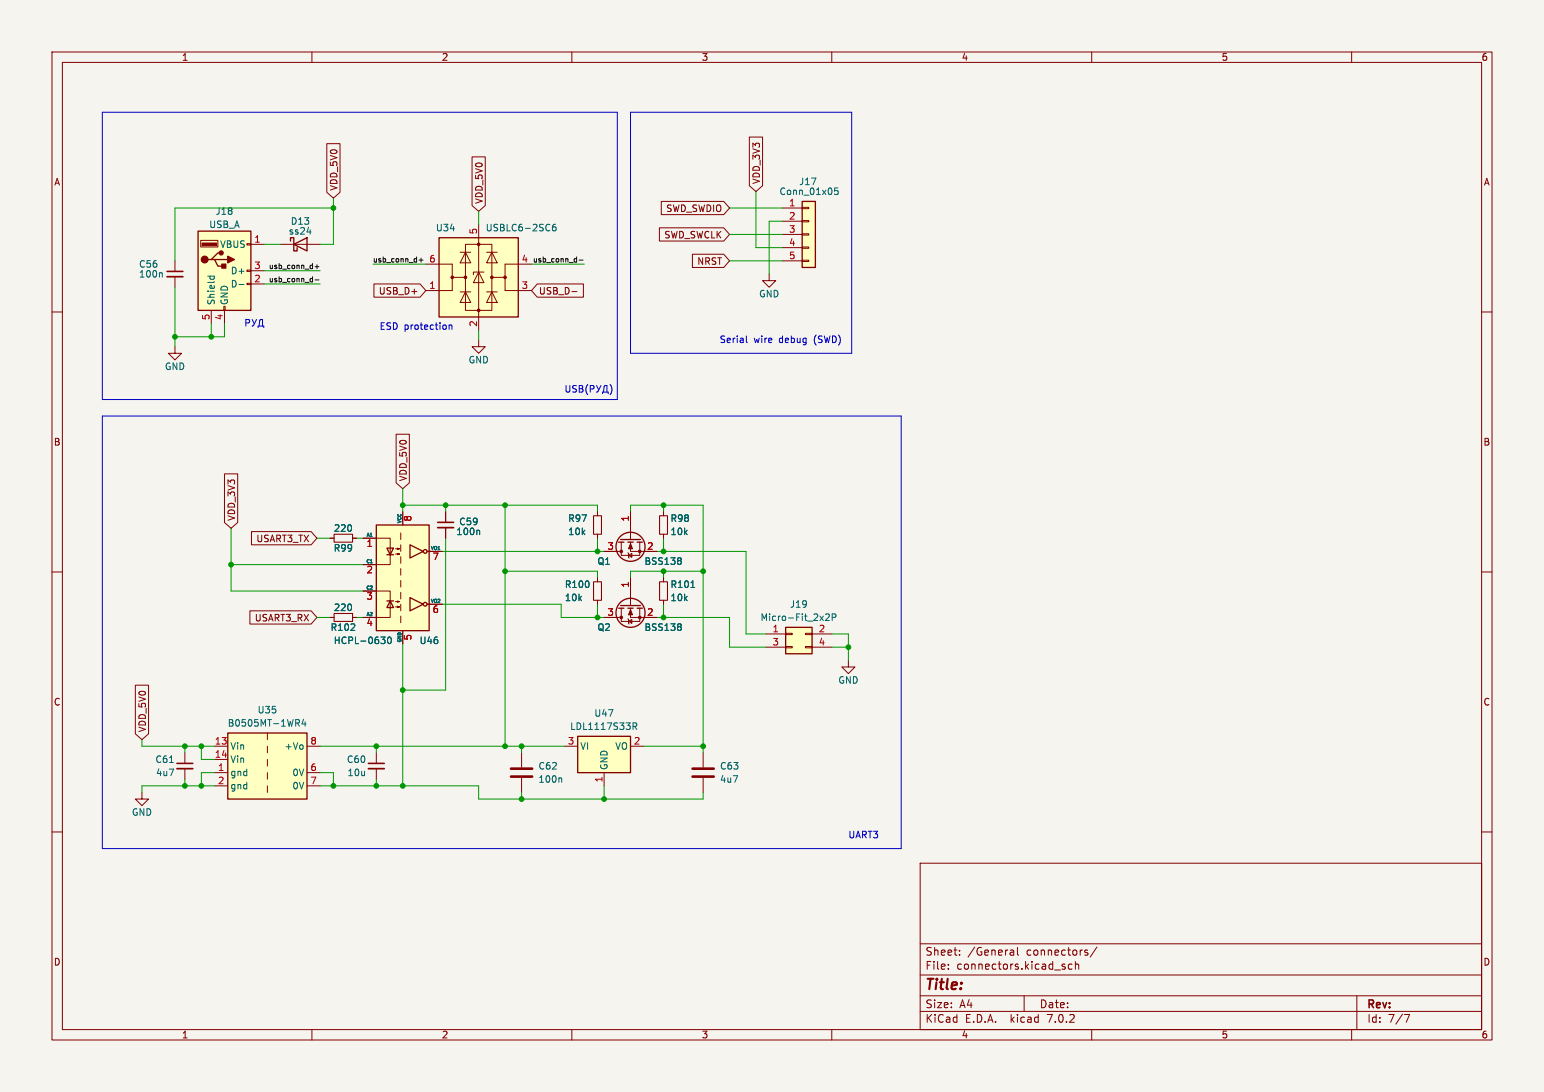
[picture p62: page 7]
