AeroKITties/Kitties-Hardware/Hardware/ciam/impeller/impeller/impeller_09_08_2023.pdf

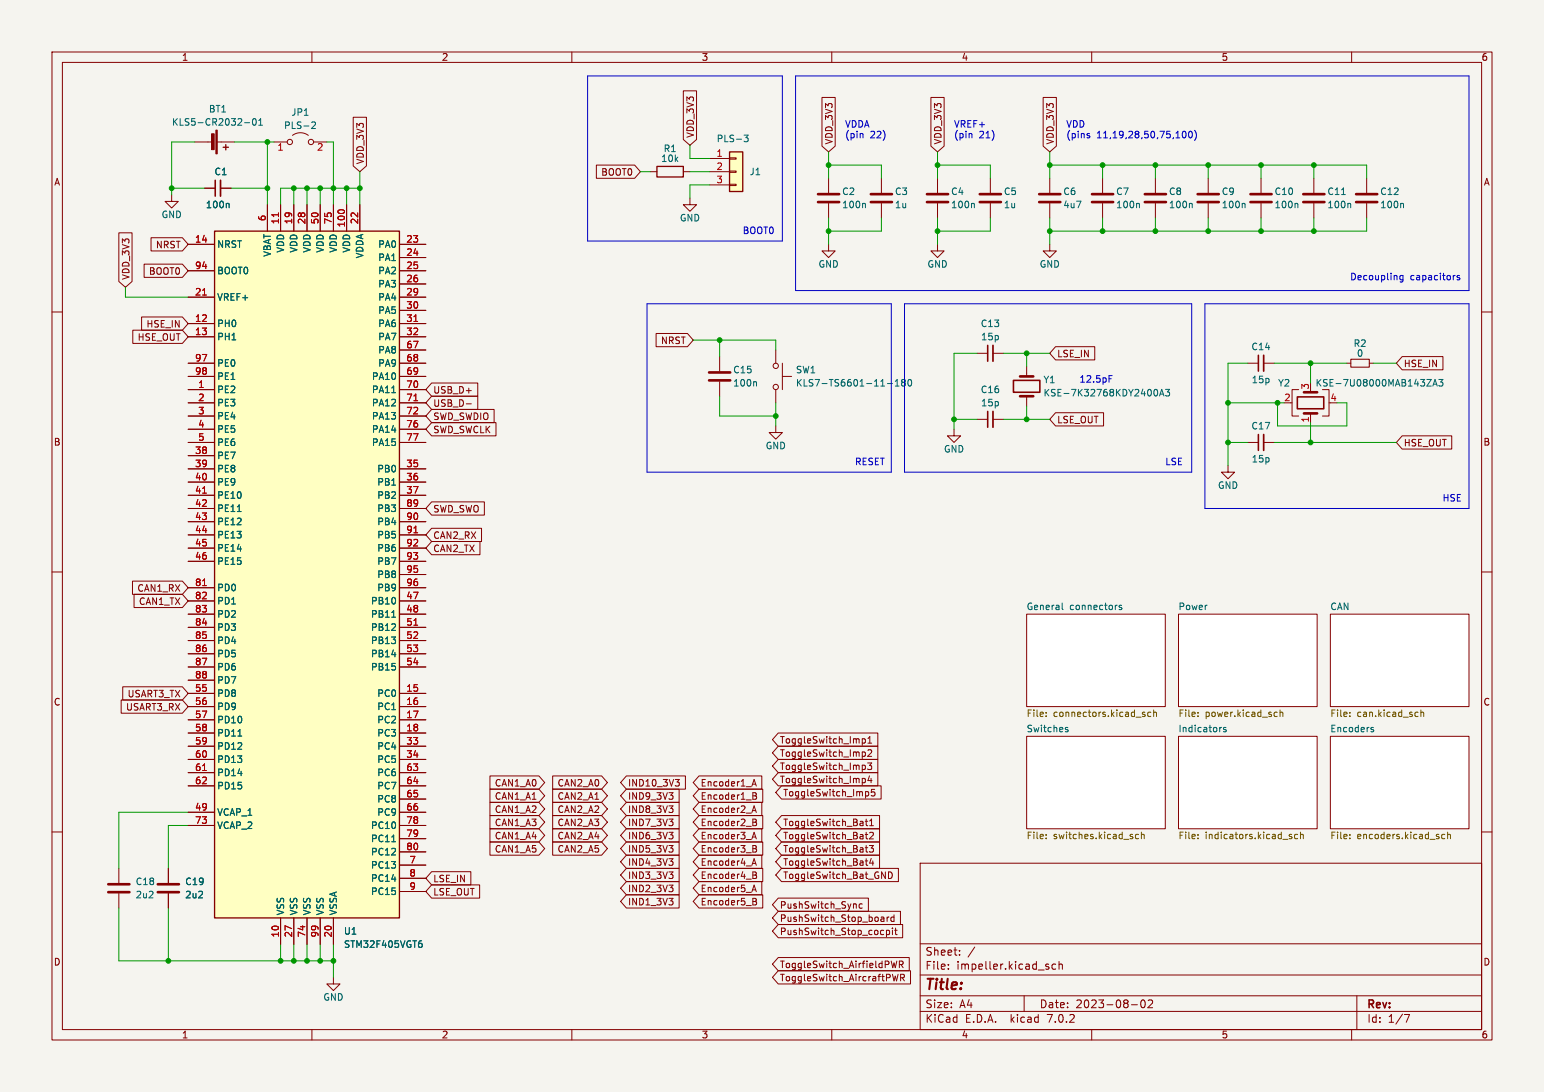
[picture p63: page 1]

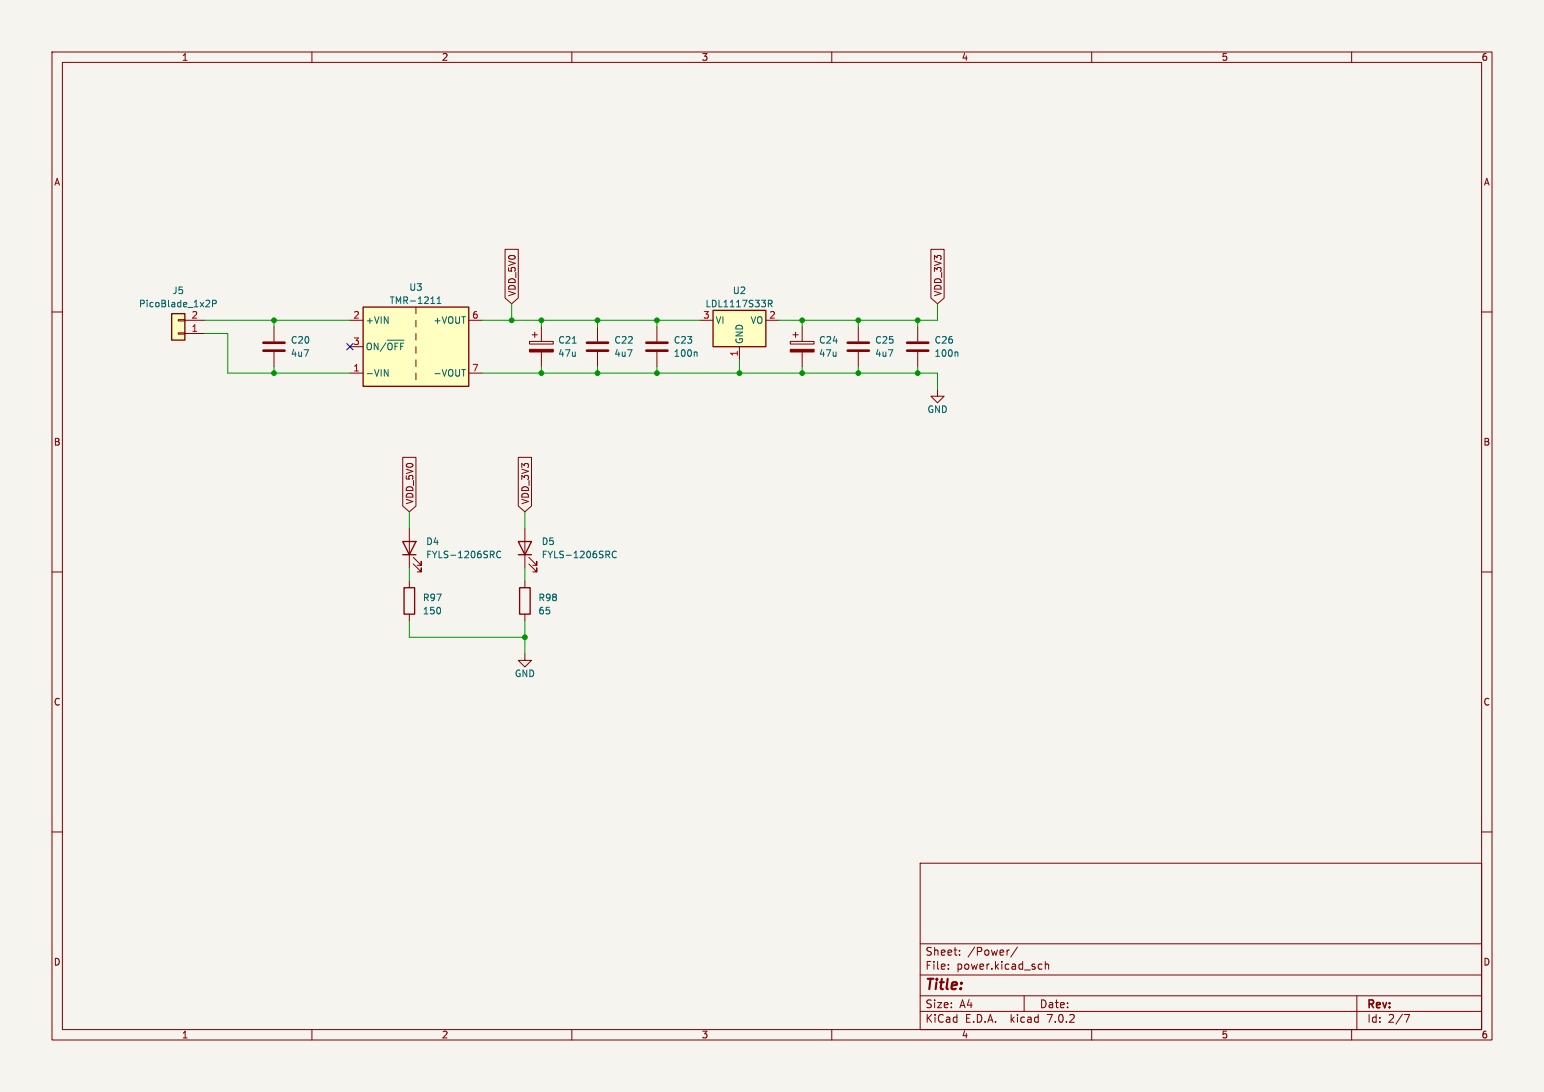
[picture p64: page 2]

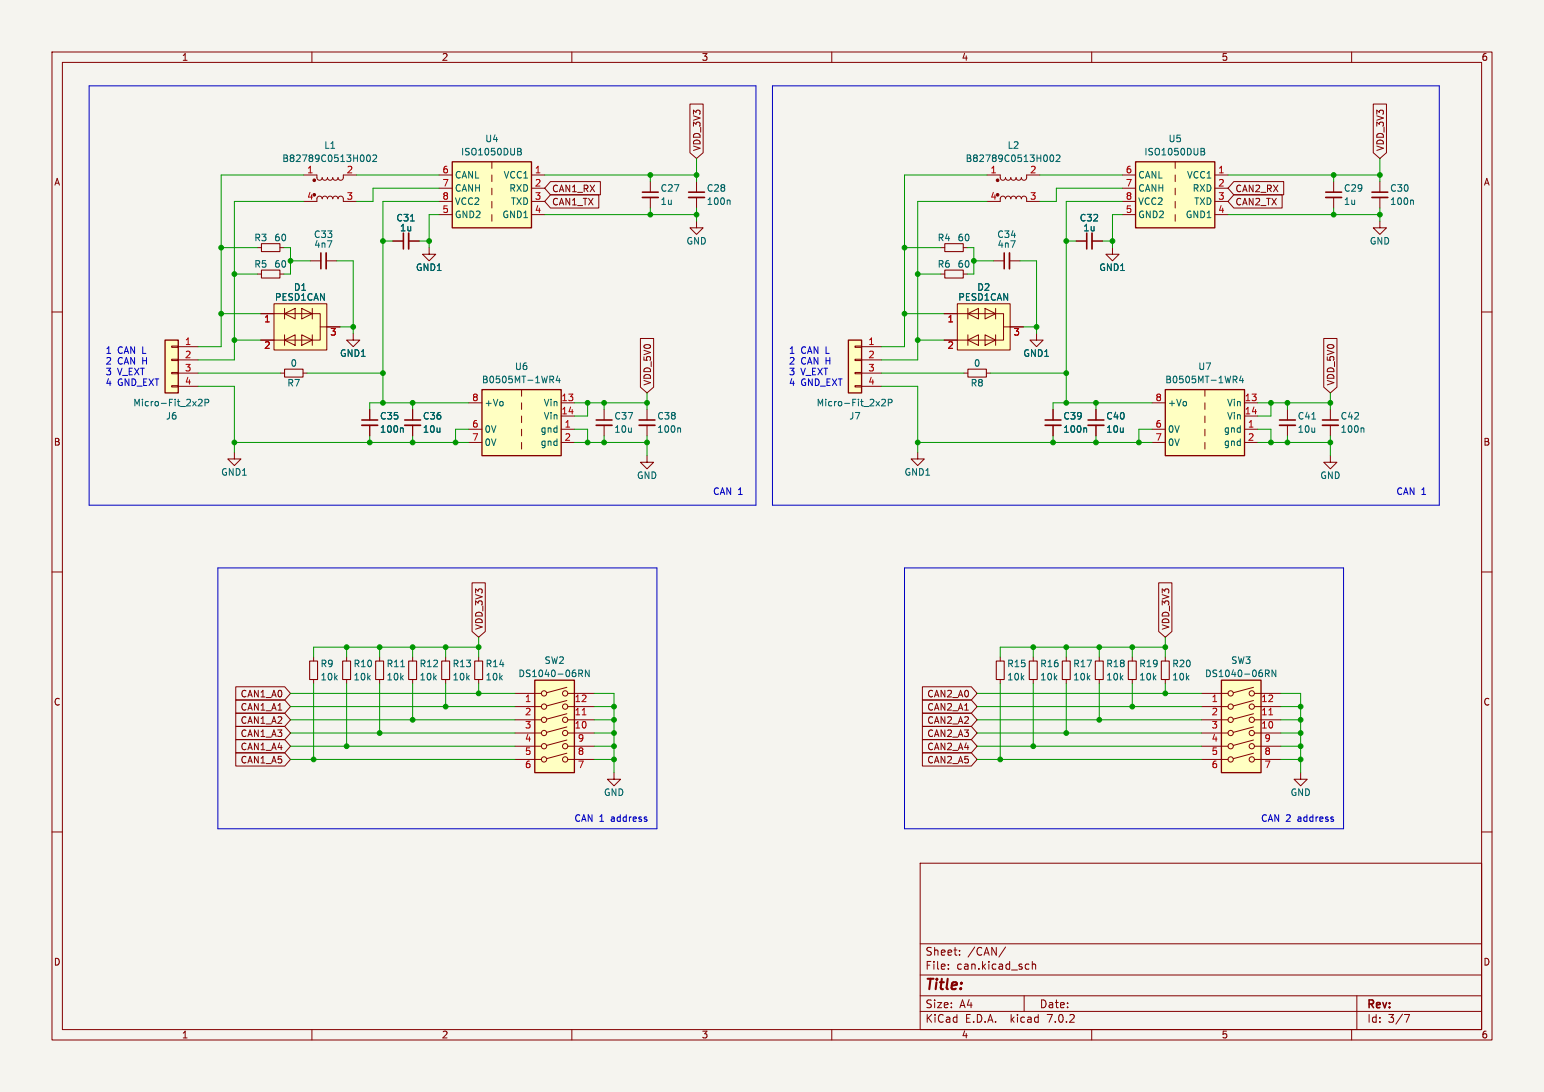
[picture p65: page 3]

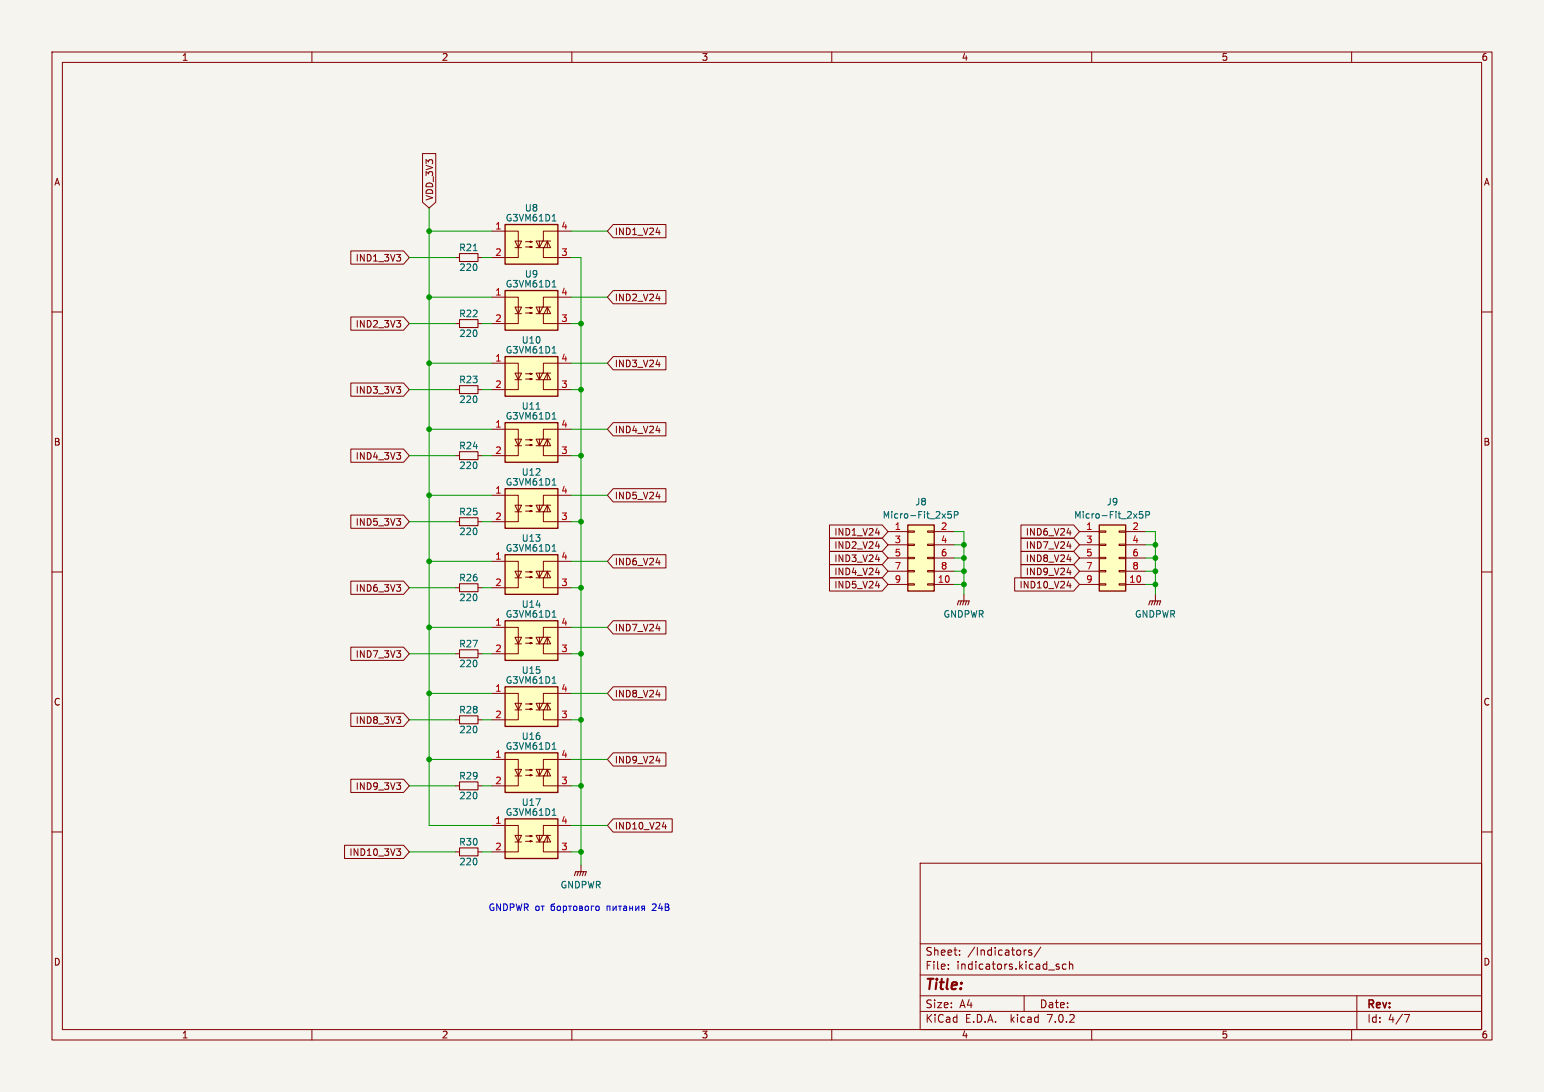
[picture p66: page 4]

IND4_V24 GNDPWR þÿ>Bþÿ1>@B>2>3> þÿ?8B0=8O þÿ24

J8 Micro-Fit_2x5P R30
Id: 4/7 Title: File: indicators.kicad_sch Sheet: /Indicators/ R25

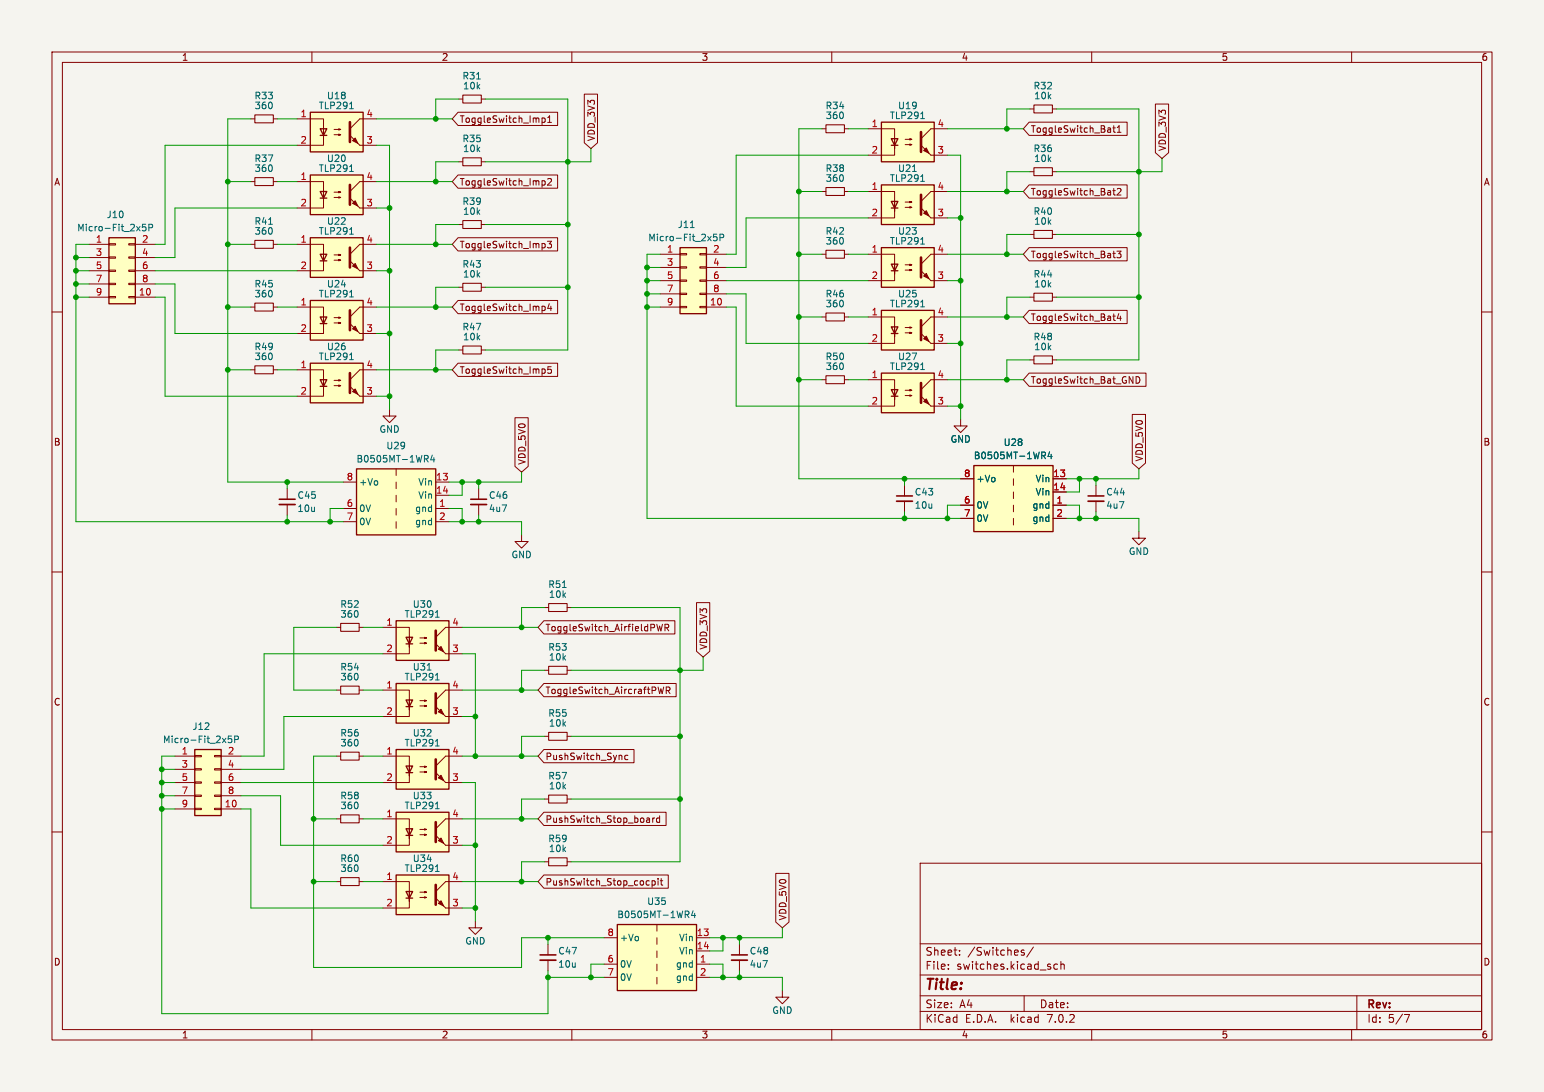
[picture p67: page 5]

Id: 5/7 Title: File: switches.kicad_sch Sheet: /Switches/ R60

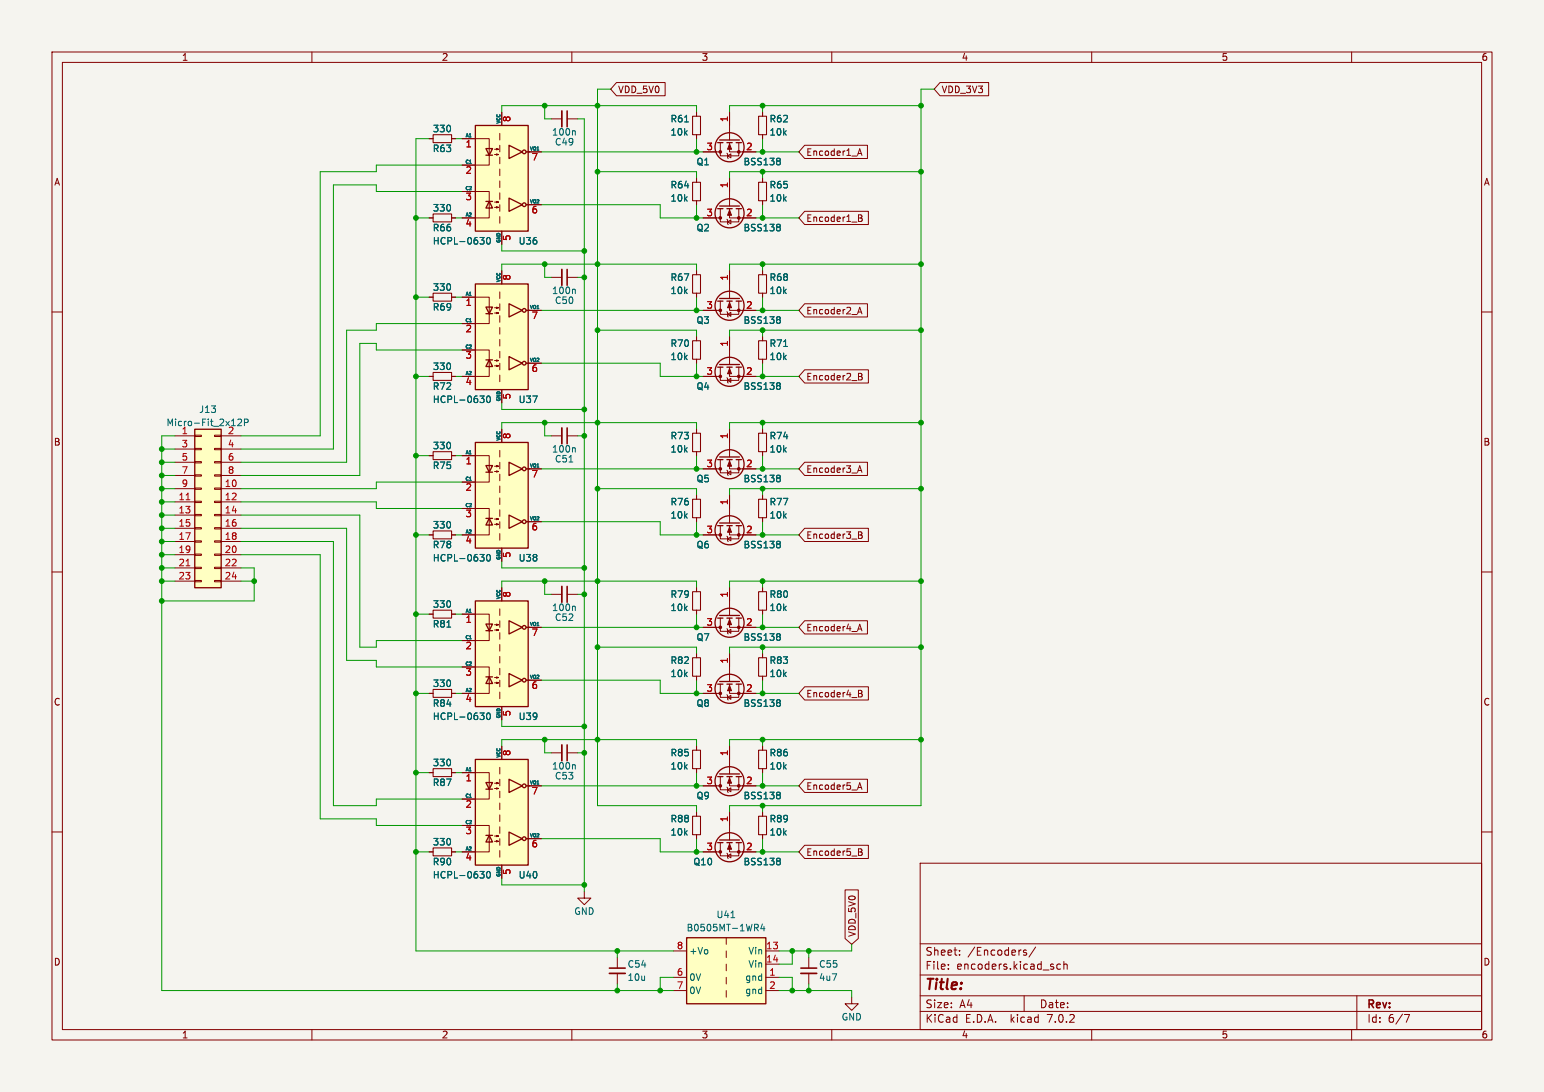
[picture p68: page 6]

Id: 6/7 Title: File: encoders.kicad_sch Sheet: /Encoders/

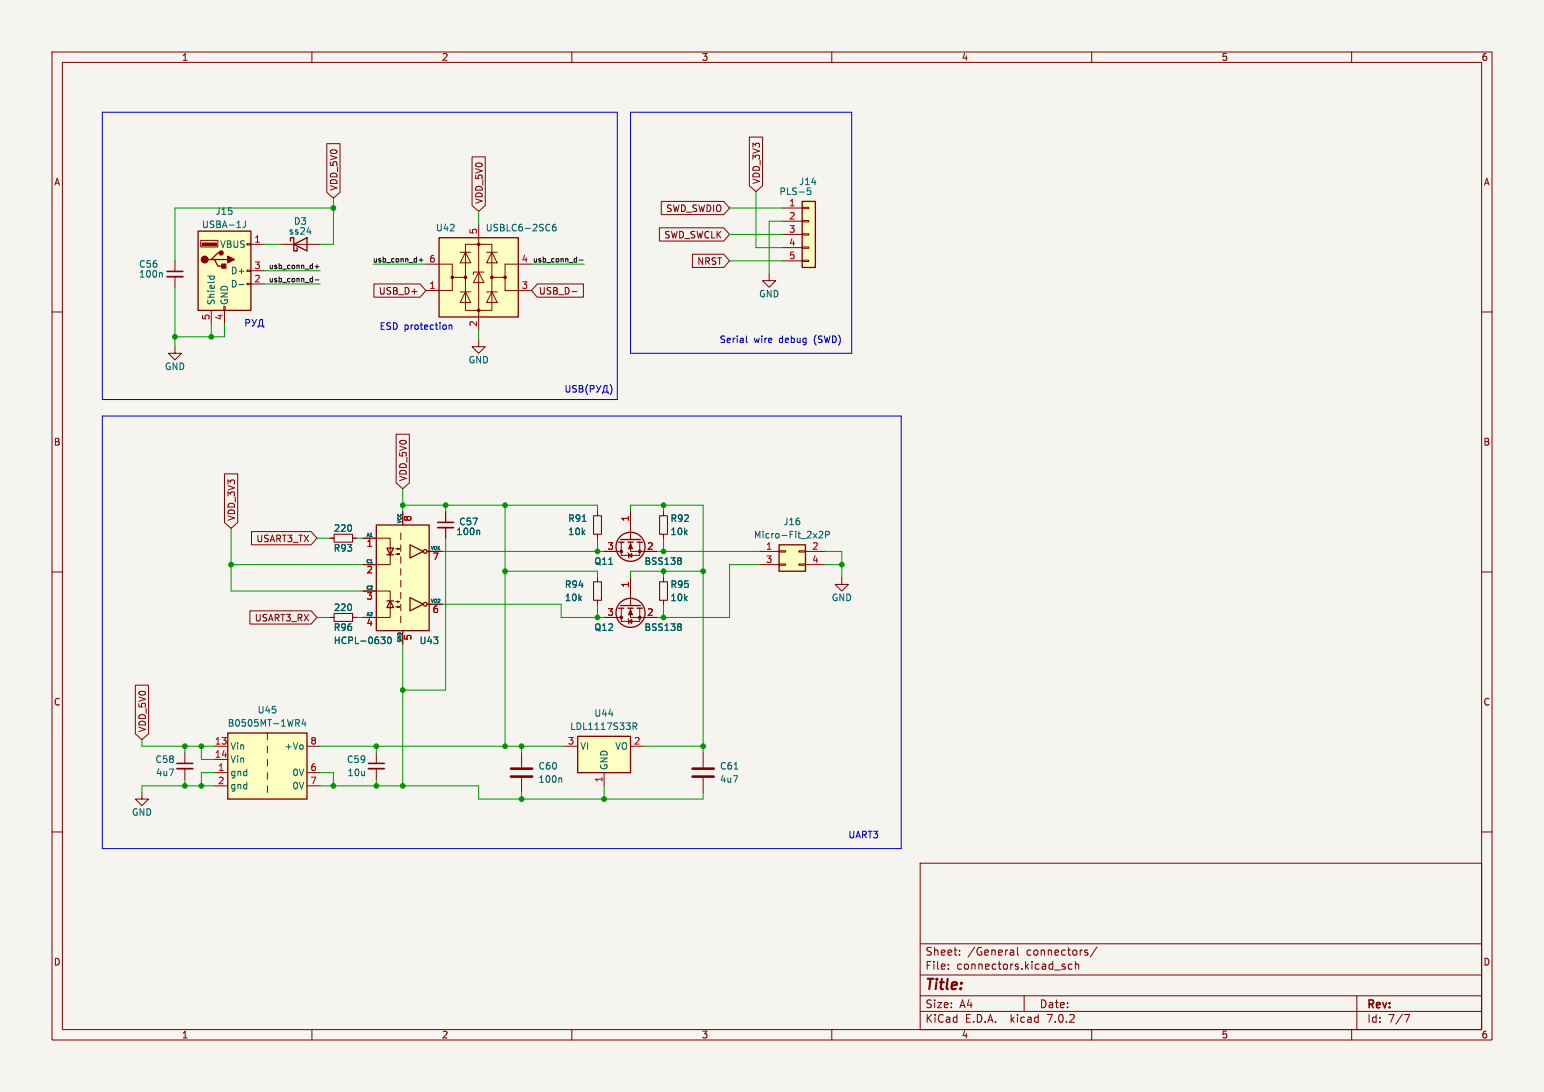
[picture p69: page 7]
