AeroKITties/Kitties-Hardware/Hardware/ciam/impeller/rpi_power_shield/power_sheld.pdf

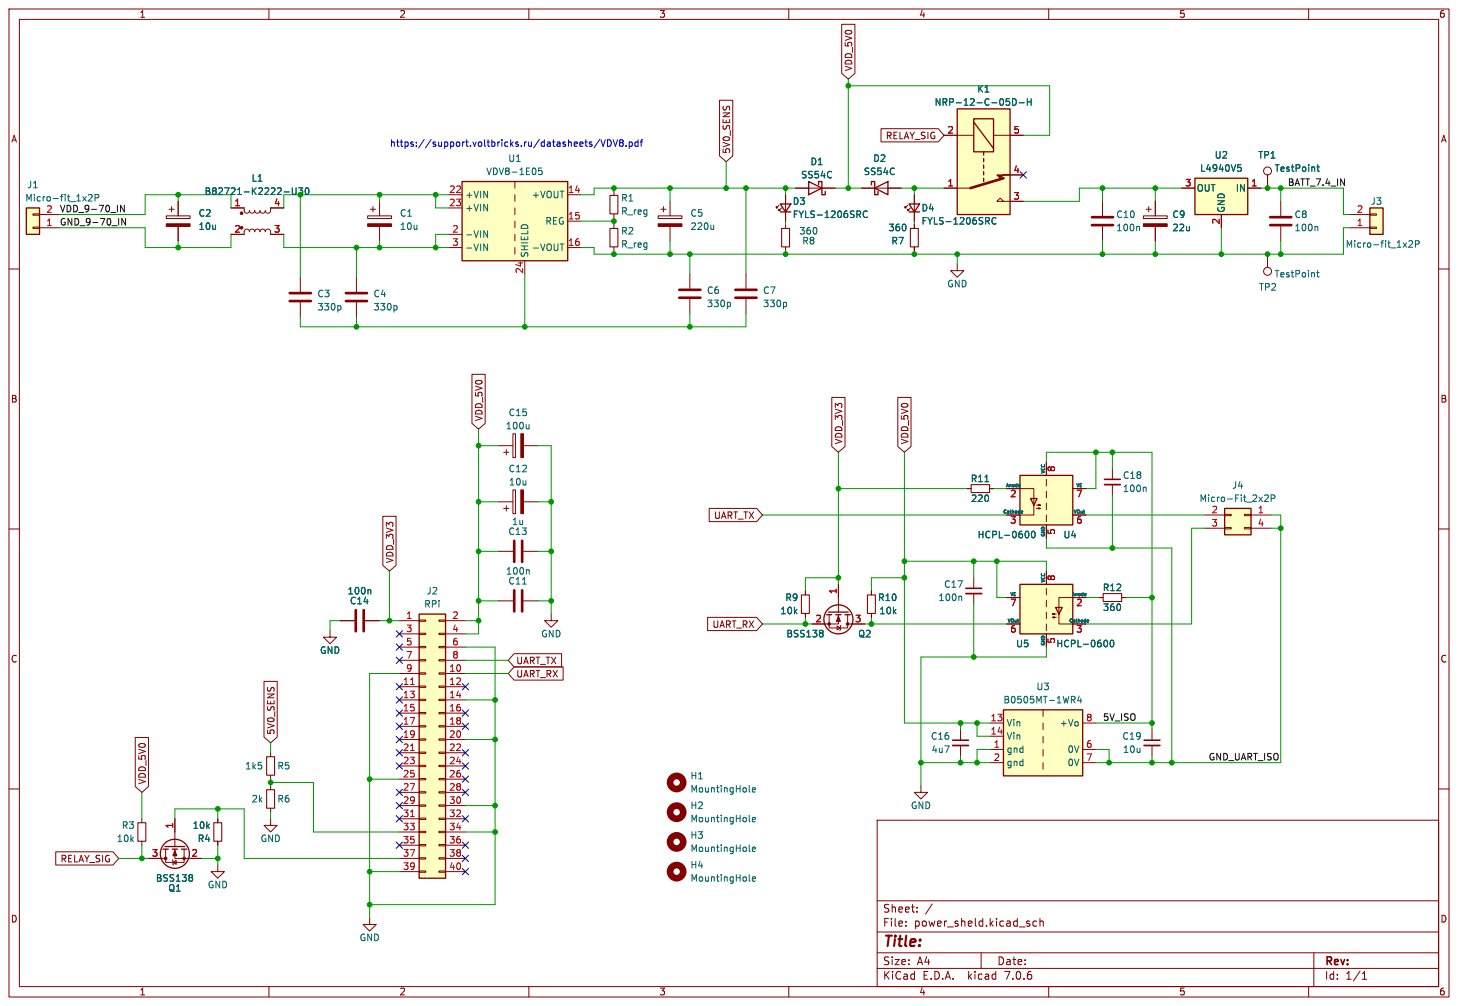
[picture p70: page 1]

Id: 1/1 Title: File: power_sheld.kicad_sch Sheet: /
