AeroKITties/Kitties-Hardware/Hardware/Royal Penguin/0.0/Board2Pdf/FC0-Assembly.pdf

1 | 2 | 3 | 4 | 5 | 6 1 | 2 | 3 | 4 | 5 | 6 ABCD | ABCD Date: KiCad E.D.A. pcbnew (6.0.6) Size: A4 | Rev:

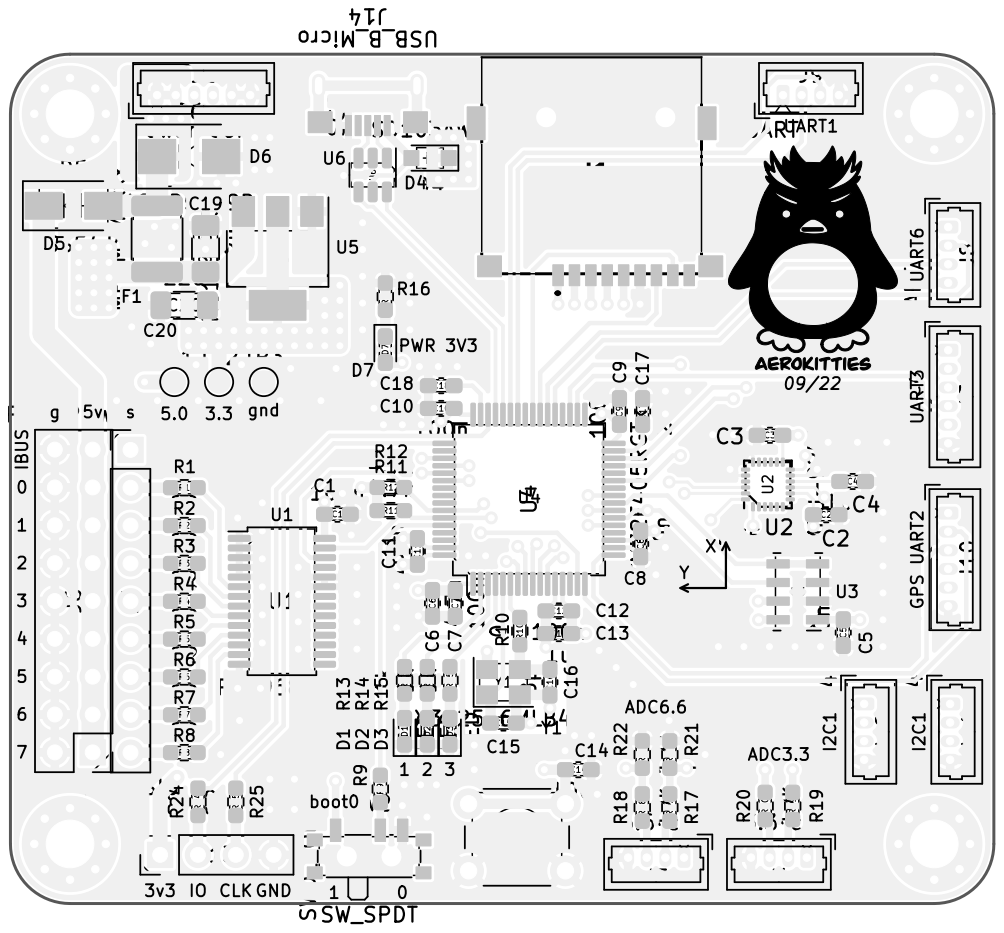
[picture p71: page 1]
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

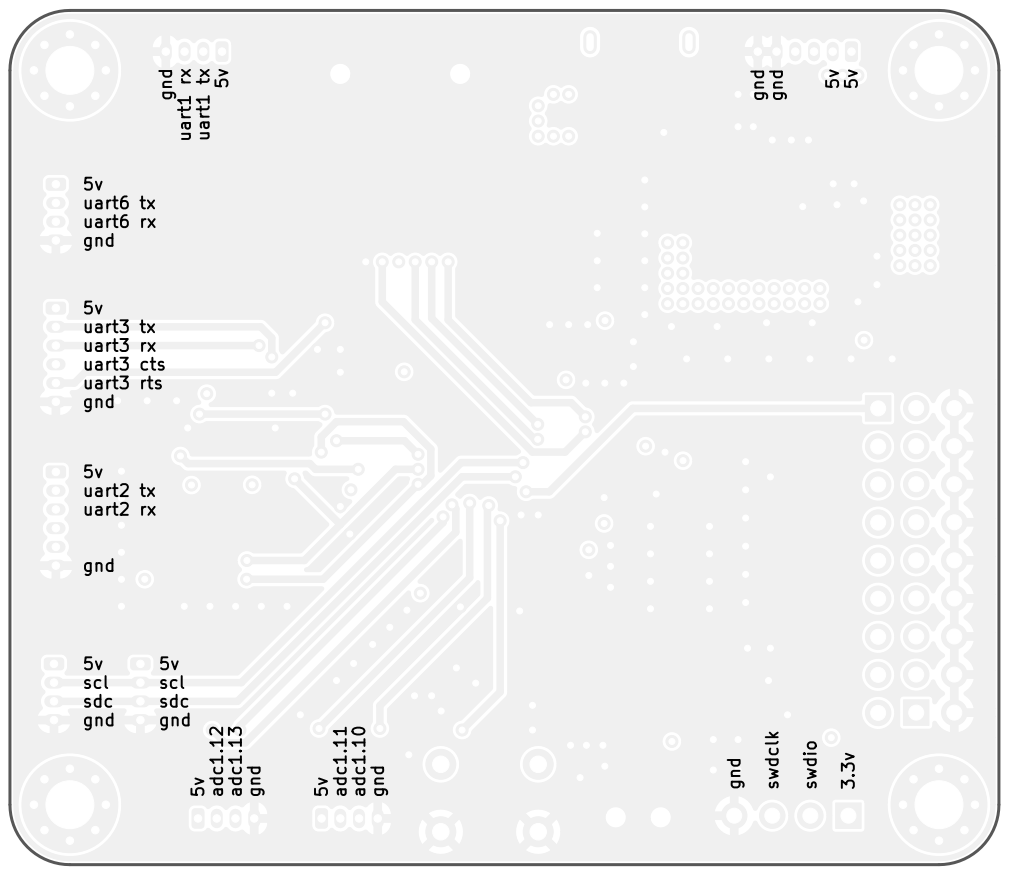
[picture p72: page 2]
Id: 1/1 Title:; uart6 tx; 5v 5v gnd; gnd; uart3 rx gnd; uart1 rx; uart2 tx; gnd adc1.10 uart1 tx; swdio; scl uart3 rts; swdclk adc1.11; sdc; adc1.12; 5v gnd; 3.3v 5v adc1.13 uart6 rx

sdc gnd
scl uart3 tx uart2 rx
uart3 cts

File: FC0.kicad_pcb Sheet: BlackAndWhiteBottom gnd
