AeroKITties/Kitties-Hardware/Hardware/Penguin Junior/Размеры.pdf

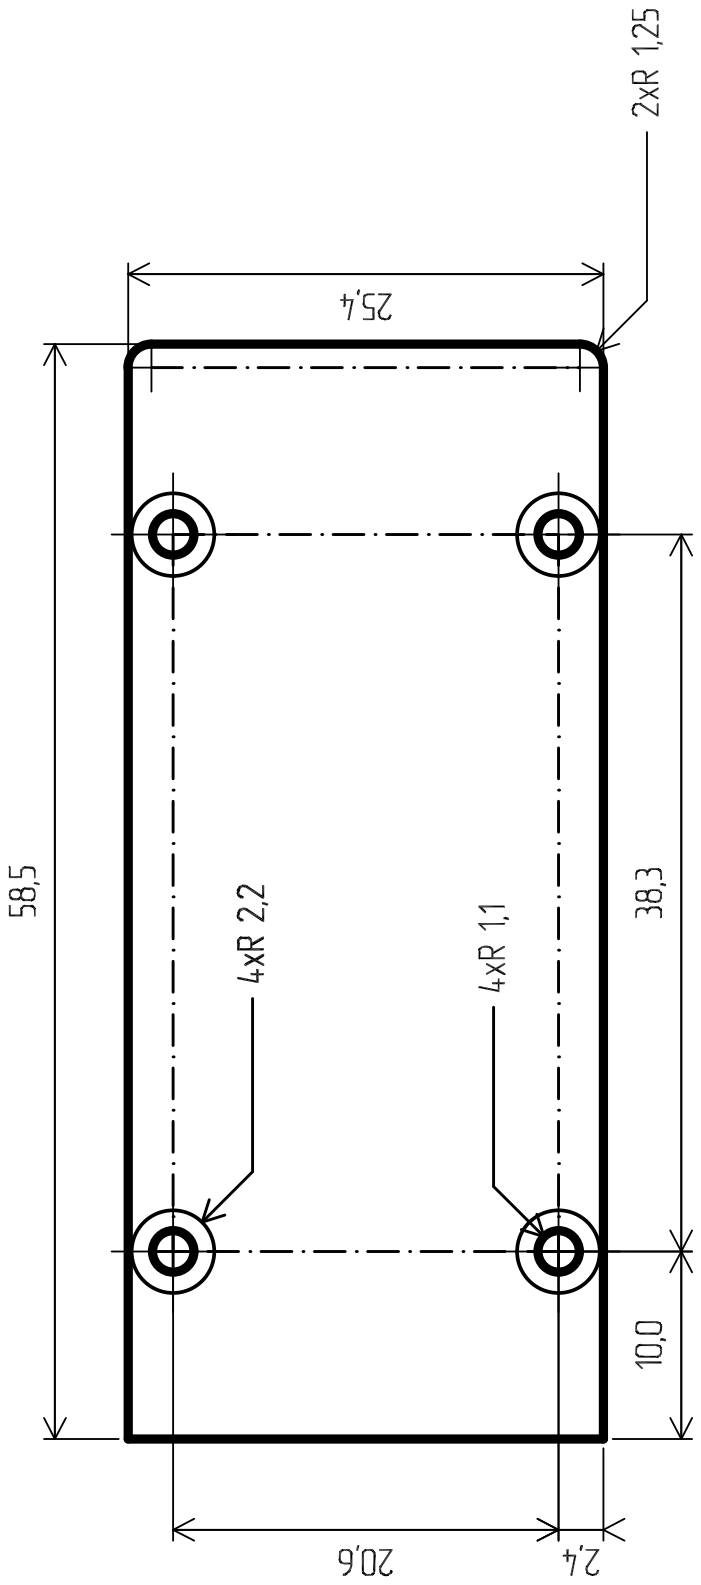
[picture p73: page 1]
