AeroKITties/Kitties-Hardware/(list of files, drawings)

Other design files:
Hardware/PiezoSensorBoard/ADC.SchDoc
Hardware/PiezoSensorBoard/MCU.SchDoc
Hardware/PiezoSensorBoard/PiezoSensorBoard.PcbDoc
Hardware/PiezoSensorBoard/PiezoSensorBoard.PrjPcb
Hardware/PiezoSensorBoard/Power.SchDoc
