AeroKITties/Kitties-Hardware/Hardware/CAN sensor net/Master board/Master board.kicad_pcb

## KiCad design Hardware/CAN sensor net/Master board/Master board.kicad_pcb (2024-03-16)

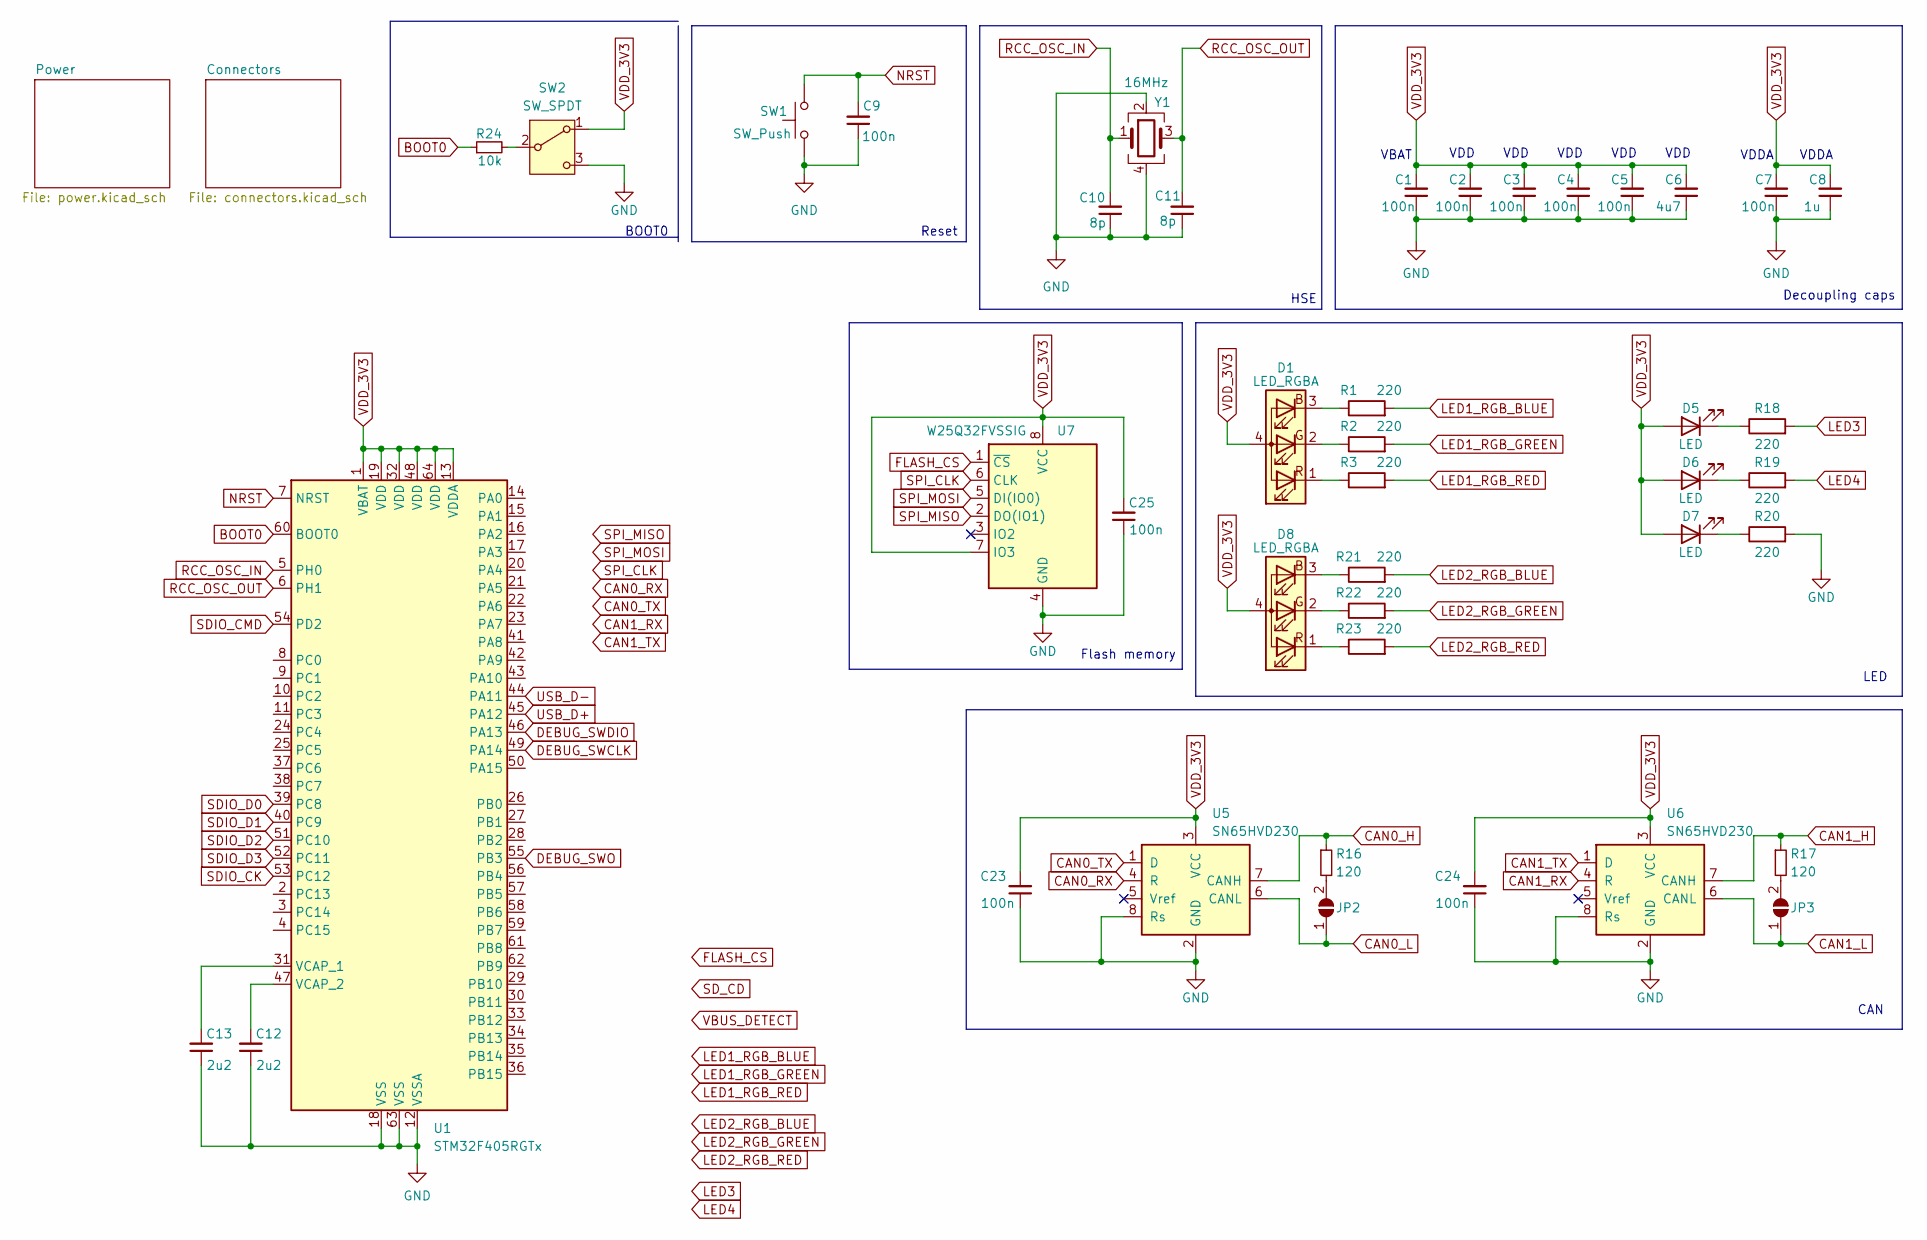
[picture p74: schematic Master board.kicad_sch]

Parts:
C1, C2, C3, C4, C5, C7, C9, C23, C24, C25: 100n; C_0603_1608Metric
C6: 4u7; C_0603_1608Metric
C8: 1u; C_0603_1608Metric
C10, C11: 8p; C_0603_1608Metric
C12, C13: 2u2; C_0603_1608Metric
D1, D8: LED_RGBA; LED_Cree-PLCC4_3.2x2.8mm_CCW
D5, D6, D7: LED; LED_1206_3216Metric
JP2, JP3: SolderJumper_2_Open; SolderJumper-2_P1.3mm_Open_RoundedPad1.0x1.5mm
R1, R2, R3, R18, R19, R20, R21, R22, R23: 220; R_0603_1608Metric
R16, R17: 120; R_0603_1608Metric
R24: 10k; R_0603_1608Metric
SW1: SW_Push; button_small
SW2: SW_SPDT; MSS-12D16
U1: STM32F405RGTx; LQFP-64_10x10mm_P0.5mm
U5, U6: SN65HVD230; SOIC-8_3.9x4.9mm_P1.27mm
U7: W25Q32FVSSIG; SOIC-8_5.23x5.23mm_P1.27mm
Y1: 16MHz; Crystal_SMD_3225-4Pin_3.2x2.5mm

Connections:
BOOT0: R24.1, U1.60 (BOOT0)
CAN0_H: R16.1, U5.7 (CANH); also elsewhere on the board
CAN0_L: JP2.1 (A), U5.6 (CANL); also elsewhere on the board
CAN0_RX: U5.4 (R)
CAN0_TX: U5.1 (D)
CAN1_H: R17.1, U6.7 (CANH); also elsewhere on the board
CAN1_L: JP3.1 (A), U6.6 (CANL); also elsewhere on the board
CAN1_RX: U6.4 (R)
CAN1_TX: U6.1 (D)
DEBUG_SWCLK: U1.49 (PA14); also elsewhere on the board
DEBUG_SWDIO: U1.46 (PA13); also elsewhere on the board
DEBUG_SWO: U1.55 (PB3); also elsewhere on the board
FLASH_CS: U7.1 (~CS)
GND: C1.1, C2.1, C3.1, C4.1, C5.1, C6.1, C7.1, C8.1, C9.1, C10.1, C11.1, C12.1, C13.1, C23.1, C24.1, C25.1, R20.2, SW1.1, SW2.3 (C), U1.12 (VSSA), U1.18 (VSS), U1.63 (VSS), U5.2 (GND), U5.8 (Rs), U6.2 (GND), U6.8 (Rs), U7.4 (GND), Y1.2, Y1.4; also elsewhere on the board
LED1_RGB_BLUE: R1.2
LED1_RGB_GREEN: R2.2
LED1_RGB_RED: R3.2
LED2_RGB_BLUE: R21.2
LED2_RGB_GREEN: R22.2
LED2_RGB_RED: R23.2
LED3: R18.2
LED4: R19.2
NRST: C9.2, SW1.2, U1.7 (NRST); also elsewhere on the board
unnamed: D1.3 (BK), R1.1
unnamed: D1.2 (GK), R2.1
unnamed: D1.1 (RK), R3.1
unnamed: D5.1 (K), R18.1
unnamed: D6.1 (K), R19.1
unnamed: D7.1 (K), R20.1
unnamed: D8.3 (BK), R21.1
unnamed: D8.2 (GK), R22.1
unnamed: D8.1 (RK), R23.1
unnamed: JP2.2 (B), R16.2
unnamed: JP3.2 (B), R17.2
unnamed: R24.2, SW2.2 (B)
unnamed: C13.2, U1.31 (VCAP_1)
unnamed: C12.2, U1.47 (VCAP_2)
RCC_OSC_IN: C10.2, U1.5 (PH0), Y1.1
RCC_OSC_OUT: C11.2, U1.6 (PH1), Y1.3
SDIO_CK: U1.53 (PC12); also elsewhere on the board
SDIO_CMD: U1.54 (PD2); also elsewhere on the board
SDIO_D0: U1.39 (PC8); also elsewhere on the board
SDIO_D1: U1.40 (PC9); also elsewhere on the board
SDIO_D2: U1.51 (PC10); also elsewhere on the board
SDIO_D3: U1.52 (PC11); also elsewhere on the board
SPI_CLK: U7.6 (CLK)
SPI_MISO: U7.2 (DO(IO1))
SPI_MOSI: U7.5 (DI(IO0))
USB_D+: U1.45 (PA12); also elsewhere on the board
USB_D-: U1.44 (PA11); also elsewhere on the board
VDD_3V3: C1.2, C2.2, C3.2, C4.2, C5.2, C6.2, C7.2, C8.2, C23.2, C24.2, C25.2, D1.4 (A), D5.2 (A), D6.2 (A), D7.2 (A), D8.4 (A), SW2.1 (A), U1.1 (VBAT), U1.13 (VDDA), U1.19 (VDD), U1.32 (VDD), U1.48 (VDD), U1.64 (VDD), U5.3 (VCC), U6.3 (VCC), U7.7 (IO3), U7.8 (VCC); also elsewhere on the board

Notes on the sheet:
VDDA
CAN
Reset
VDD
Flash memory
VBAT
BOOT0
Decoupling caps
LED
HSE

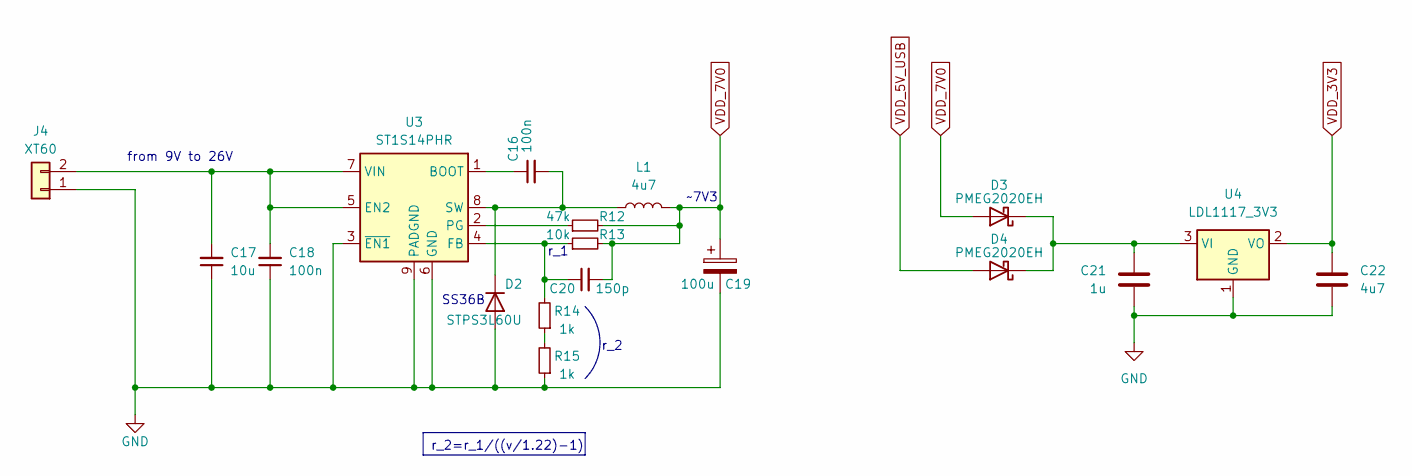
[picture p75: schematic power.kicad_sch]

Parts:
C16, C18: 100n; C_0603_1608Metric
C17: 10u; C_1210_3225Metric
C19: 100u; CP_Radial_D5.0mm_P2.00mm
C20: 150p; C_0603_1608Metric
C21: 1u; C_0603_1608Metric
C22: 4u7; C_0603_1608Metric
D2: STPS3L60U; D_SMB
D3, D4: PMEG2020EH; D_SOD-123F
J4: XT60; AMASS_XT30PW-M_1x02_P2.50mm_Horizontal
L1: 4u7; L_Sunlord_MWSA0503S
R12: 47k; R_0603_1608Metric
R13: 10k; R_0603_1608Metric
R14, R15: 1k; R_0603_1608Metric
U3: ST1S14PHR; TI_SO-PowerPAD-8
U4: LDL1117_3V3; SOT-223-3_TabPin2

Connections:
GND: C17.1, C18.1, C19.2, C21.2, C22.2, D2.2 (A), J4.1, R15.1, U3.3 (~EN1), U3.6 (GND), U3.9 (PADGND), U4.1 (GND); also elsewhere on the board
unnamed: C16.2, D2.1 (K), L1.1, U3.8 (SW)
unnamed: C21.1, D3.1 (K), D4.1 (K), U4.3 (VI)
unnamed: C17.2, C18.2, J4.2, U3.5 (EN2), U3.7 (VIN)
unnamed: R14.1, R15.2
unnamed: C16.1, U3.1 (BOOT)
unnamed: C20.1, R13.1, R14.2, U3.4 (FB)
unnamed: R12.1, U3.2 (PG)
VDD_3V3: C22.1, U4.2 (VO); also elsewhere on the board
VDD_5V_USB: D4.2 (A); also elsewhere on the board
VDD_7V0: C19.1, C20.2, D3.2 (A), L1.2, R12.2, R13.2; also elsewhere on the board

Notes on the sheet:
r_2=r_1/((v/1.22)-1)
r_2
from 9V to 26V
SS36B
r_1
~7V3

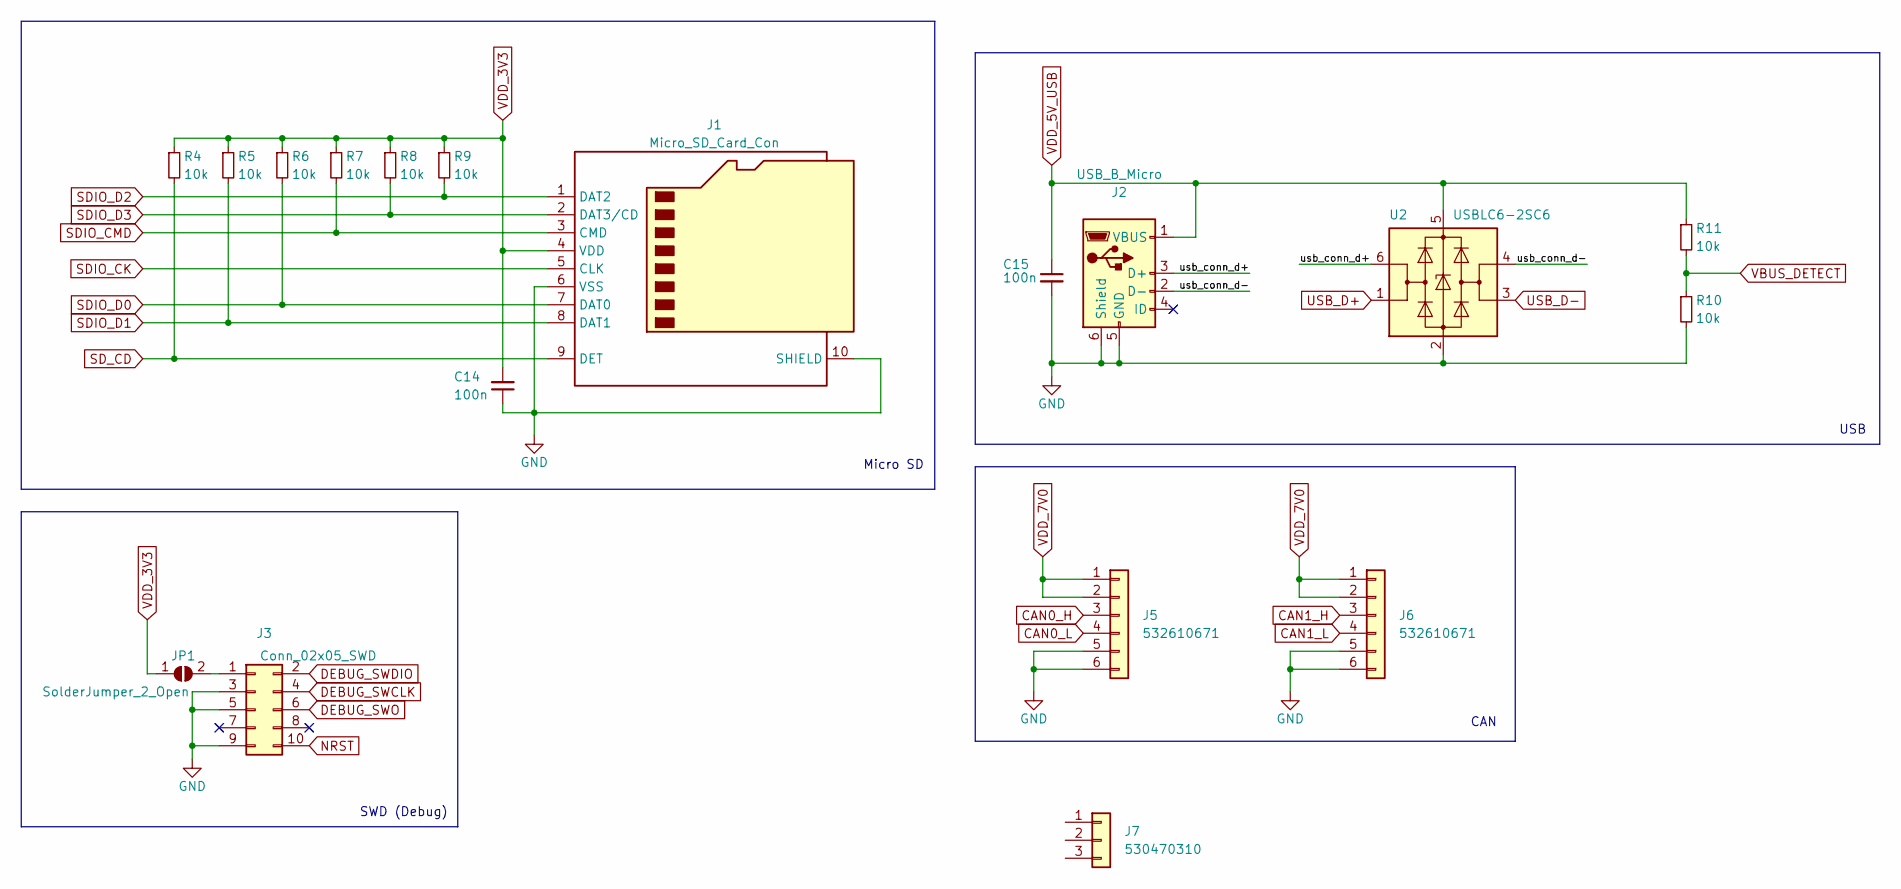
[picture p76: schematic connectors.kicad_sch]

Parts:
C14, C15: 100n; C_0603_1608Metric
J1: Micro_SD_Card_Con; TF01A
J2: USB_B_Micro; U-F-M5DD-W-2-SUS
J3: Conn_02x05_SWD; PinHeader_2x05_P1.27mm_Vertical
J5, J6: 532610671; Molex_PicoBlade_53261-0671_1x06-1MP_P1.25mm_Horizontal
J7: 530470310; Molex_PicoBlade_53047-0310_1x03_P1.25mm_Vertical
JP1: SolderJumper_2_Open; SolderJumper-2_P1.3mm_Open_RoundedPad1.0x1.5mm
R4, R5, R6, R7, R8, R9, R10, R11: 10k; R_0603_1608Metric
U2: USBLC6-2SC6; SOT-23-6

Connections:
/Connectors/usb_conn_d+: J2.3 (D+), U2.6 (I/O1)
/Connectors/usb_conn_d-: J2.2 (D-), U2.4 (I/O2)
CAN0_H: J5.3; also elsewhere on the board
CAN0_L: J5.4; also elsewhere on the board
CAN1_H: J6.3; also elsewhere on the board
CAN1_L: J6.4; also elsewhere on the board
DEBUG_SWCLK: J3.4; also elsewhere on the board
DEBUG_SWDIO: J3.2; also elsewhere on the board
DEBUG_SWO: J3.6; also elsewhere on the board
GND: C14.1, C15.2, J1.6 (VSS), J1.10 (SHIELD), J2.5 (GND), J2.6 (Shield), J3.3, J3.5, J3.9, J5.5, J5.6, J6.5, J6.6, R10.2, U2.2 (GND); also elsewhere on the board
NRST: J3.10; also elsewhere on the board
unnamed: J3.1, JP1.2 (B)
SDIO_CK: J1.5 (CLK); also elsewhere on the board
SDIO_CMD: J1.3 (CMD), R7.2; also elsewhere on the board
SDIO_D0: J1.7 (DAT0), R6.2; also elsewhere on the board
SDIO_D1: J1.8 (DAT1), R5.2; also elsewhere on the board
SDIO_D2: J1.1 (DAT2), R9.2; also elsewhere on the board
SDIO_D3: J1.2 (DAT3/CD), R8.2; also elsewhere on the board
SD_CD: J1.9 (DET), R4.2
USB_D+: U2.1 (I/O1); also elsewhere on the board
USB_D-: U2.3 (I/O2); also elsewhere on the board
VBUS_DETECT: R10.1, R11.2
VDD_3V3: C14.2, J1.4 (VDD), JP1.1 (A), R4.1, R5.1, R6.1, R7.1, R8.1, R9.1; also elsewhere on the board
VDD_5V_USB: C15.1, J2.1 (VBUS), R11.1, U2.5 (VBUS); also elsewhere on the board
VDD_7V0: J5.1, J5.2, J6.1, J6.2; also elsewhere on the board

Notes on the sheet:
CAN
USB
Micro SD
SWD (Debug)

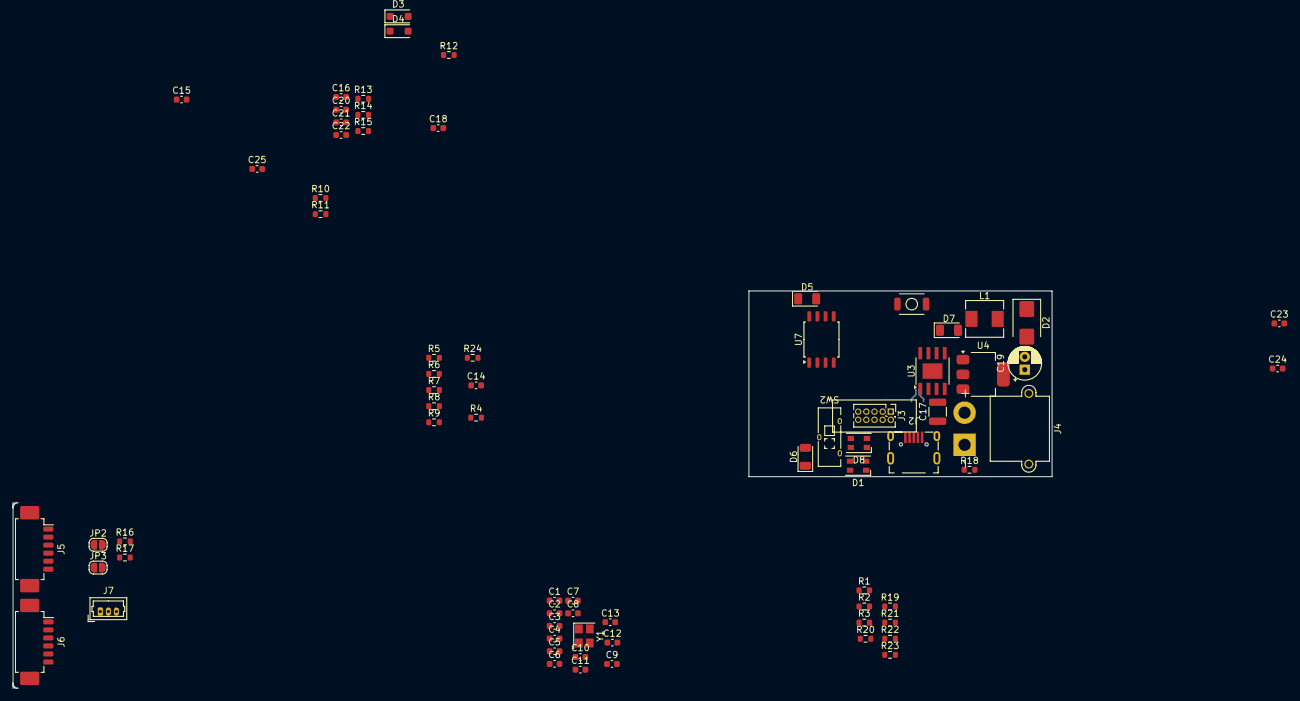
[picture p77: board Master board.kicad_pcb from above]

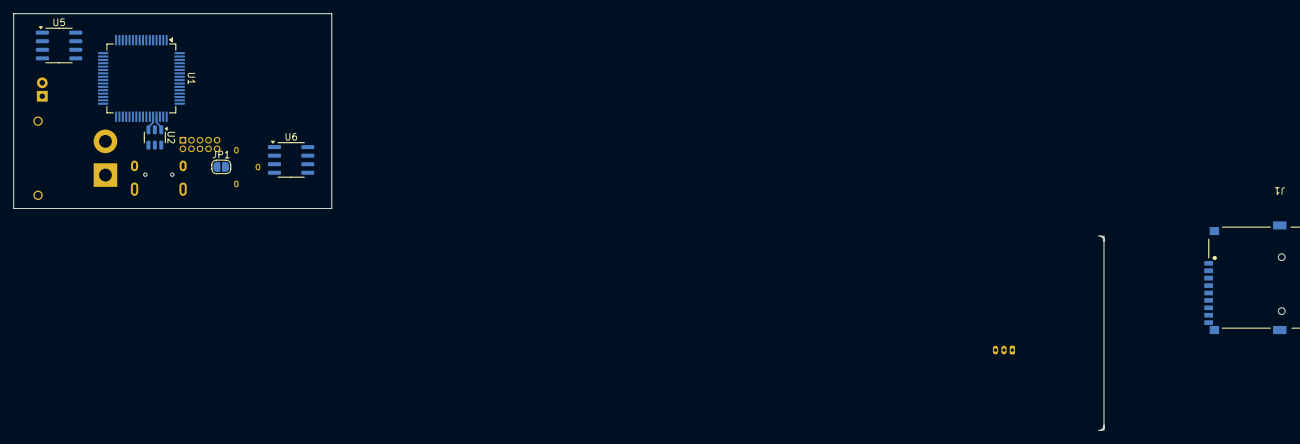
[picture p78: board Master board.kicad_pcb from below]

Board: 4 copper layers, 78 parts (6 on the bottom side), 49 nets.
