AeroKITties/Kitties-Hardware/Hardware/CAN sensor net/Piezo module/Piezo module.kicad_pcb

## KiCad design Hardware/CAN sensor net/Piezo module/Piezo module.kicad_pcb (2024-03-16)

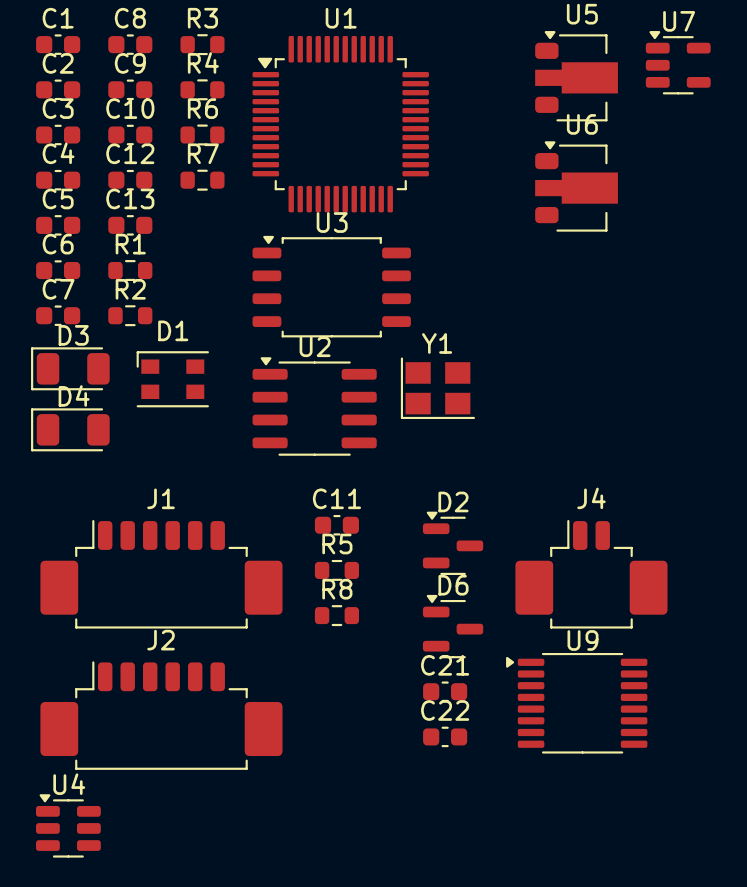
[picture p79: board Piezo module.kicad_pcb from above]

Board: 2 copper layers, 40 parts (0 on the bottom side), 21 nets, no tracks yet.

Parts:
C1, C2, C3, C4, C5, C9, C10, C11, C21, C22: 100n; C_0603_1608Metric
C6: 4u7; C_0603_1608Metric
C7: 10n; C_0603_1608Metric
C8: 1u; C_0603_1608Metric
C12, C13: 8p; C_0603_1608Metric
D1: LED_RGBA; LED_Cree-PLCC4_3.2x2.8mm_CCW
D2, D6: BZX84-C3V3; SOT-23
D3, D4: LED; LED_1206_3216Metric
J1, J2: 532610671; Molex_PicoBlade_53261-0671_1x06-1MP_P1.25mm_Horizontal
J4: 532610271; Molex_PicoBlade_53261-0271_1x02-1MP_P1.25mm_Horizontal
R1: 120; R_0603_1608Metric
R2, R3, R4, R6, R7: 220; R_0603_1608Metric
R5, R8: 10k; R_0603_1608Metric
U1: STM32F103C8Tx; LQFP-48_7x7mm_P0.5mm
U2: SN65HVD230; SOIC-8_3.9x4.9mm_P1.27mm
U3: W25Q32FVSSIG; SOIC-8_5.23x5.23mm_P1.27mm
U4: USBLC6-2SC6; SOT-23-6
U5: L79L05_SOT89; SOT-89-3
U6: L78L05_SOT89; SOT-89-3
U7: LD3985M33R_SOT23; SOT-23-5
U9: ADS1120-PW; TSSOP-16_4.4x5mm_P0.65mm
Y1: 16MHz; Crystal_SMD_3225-4Pin_3.2x2.5mm

Connections:
CAN_H: J1.3, J2.3, R1.1, U2.7 (CANH)
CAN_L: J1.4, J2.4, R1.2, U2.6 (CANL)
GND: C1.1, C2.1, C3.1, C4.1, C5.1, C6.1, C7.1, C8.1, C9.1, C10.1, C11.2, C12.1, C13.1, C21.2, C22.1, D2.1 (A), J1.5, J1.6, J2.5, J2.6, J4.2, R7.2, R8.2, U1.8 (VSSA), U1.23 (VSS), U1.35 (VSS), U1.47 (VSS), U2.2 (GND), U2.8 (Rs), U3.4 (GND), U4.2 (GND), U5.1 (GND), U6.2 (GND), U9.3 (CLK), U9.4 (DGND), U9.5 (AVSS), Y1.2, Y1.4
NRST: C9.2, U1.7 (NRST)
unnamed: D1.3 (BK), R2.1
unnamed: D1.2 (GK), R3.1
unnamed: D1.1 (RK), R4.1
unnamed: D2.3 (K), D6.1 (A), U9.11 (AIN0/REFP1)
unnamed: D3.1 (K), R6.1
unnamed: D4.1 (K), R7.1
RCC_OSC_IN: C12.2, U1.5 (PD0), Y1.1
RCC_OSC_OUT: C13.2, U1.6 (PD1), Y1.3
SPI_CLK: U3.6 (CLK), U9.1 (SCLK)
SPI_MISO: U3.2 (DO(IO1)), U9.15 (DOUT/~DRDY)
SPI_MOSI: U3.5 (DI(IO0)), U9.16 (DIN)
USB_D+: U1.33 (PA12), U4.1 (I/O1)
USB_D-: U1.32 (PA11), U4.3 (I/O2)
VBUS_DETECT: R5.2, R8.1
VDD_3V3: C1.2, C2.2, C3.2, C4.2, C5.2, C6.2, C7.2, C8.2, C10.2, C21.1, C22.2, D1.4 (A), D3.2 (A), D4.2 (A), D6.3 (K), U1.1 (VBAT), U1.9 (VDDA), U1.24 (VDD), U1.36 (VDD), U1.48 (VDD), U2.3 (VCC), U3.7 (IO3), U3.8 (VCC), U7.5 (VOUT), U9.12 (AVDD), U9.13 (DVDD)
VDD_5V_USB: C11.1, R5.1
VDD_7V0: J1.1, J1.2, J2.1, J2.2, U5.2 (VI), U6.3 (IN), U7.1 (VIN), U7.3 (INH)
