AeroKITties/Kitties-Hardware/Hardware/ciam/impeller/rpi_power_shield/power_sheld.kicad_pcb

## KiCad design Hardware/ciam/impeller/rpi_power_shield/power_sheld.kicad_pcb (2024-03-14)

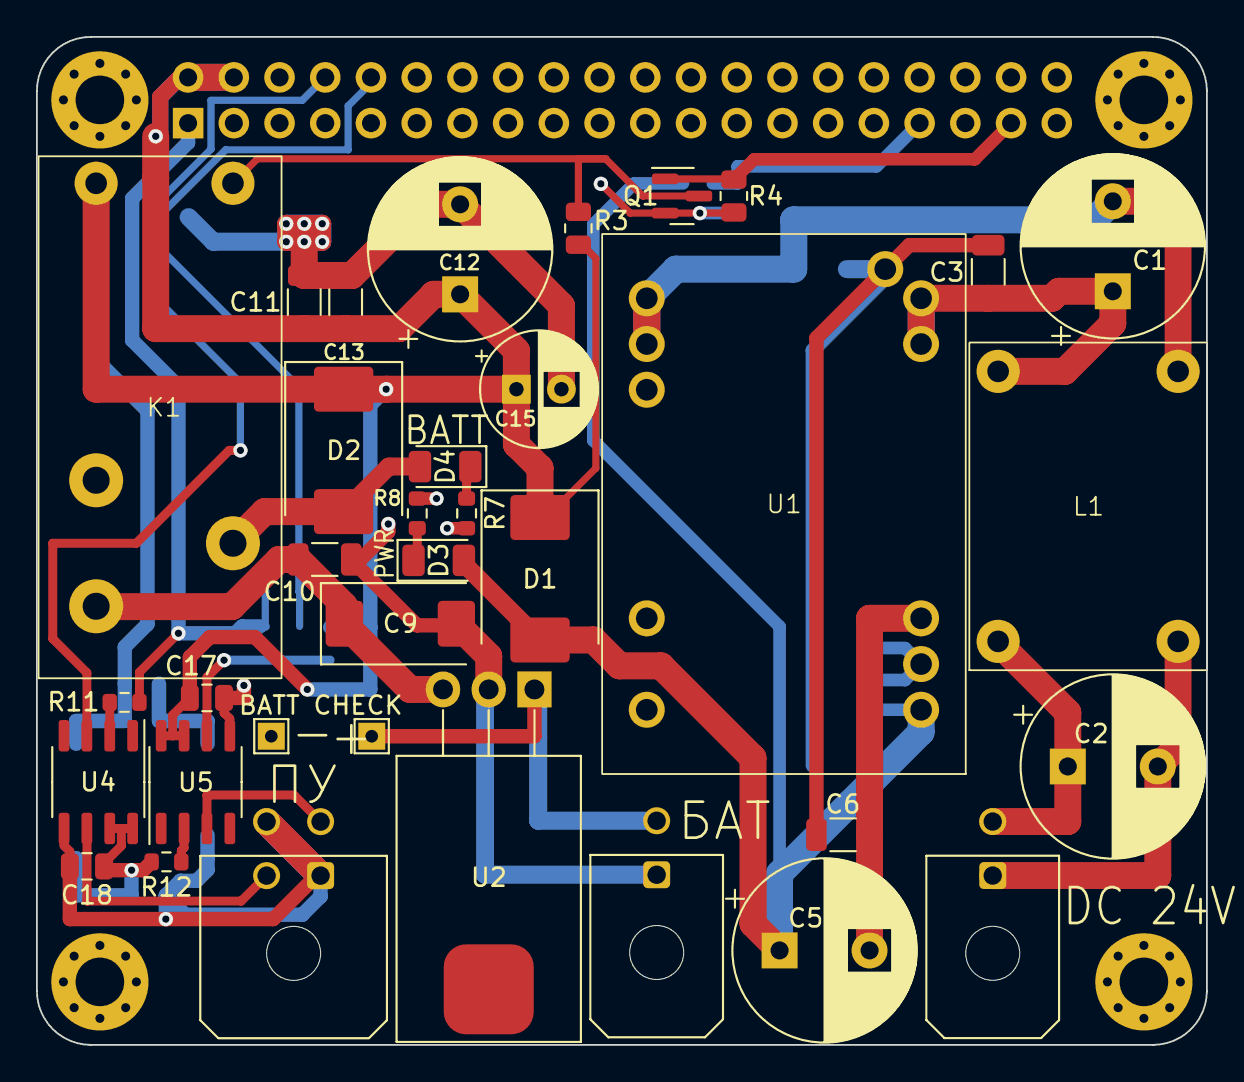
[picture p80: board power_sheld.kicad_pcb from above]

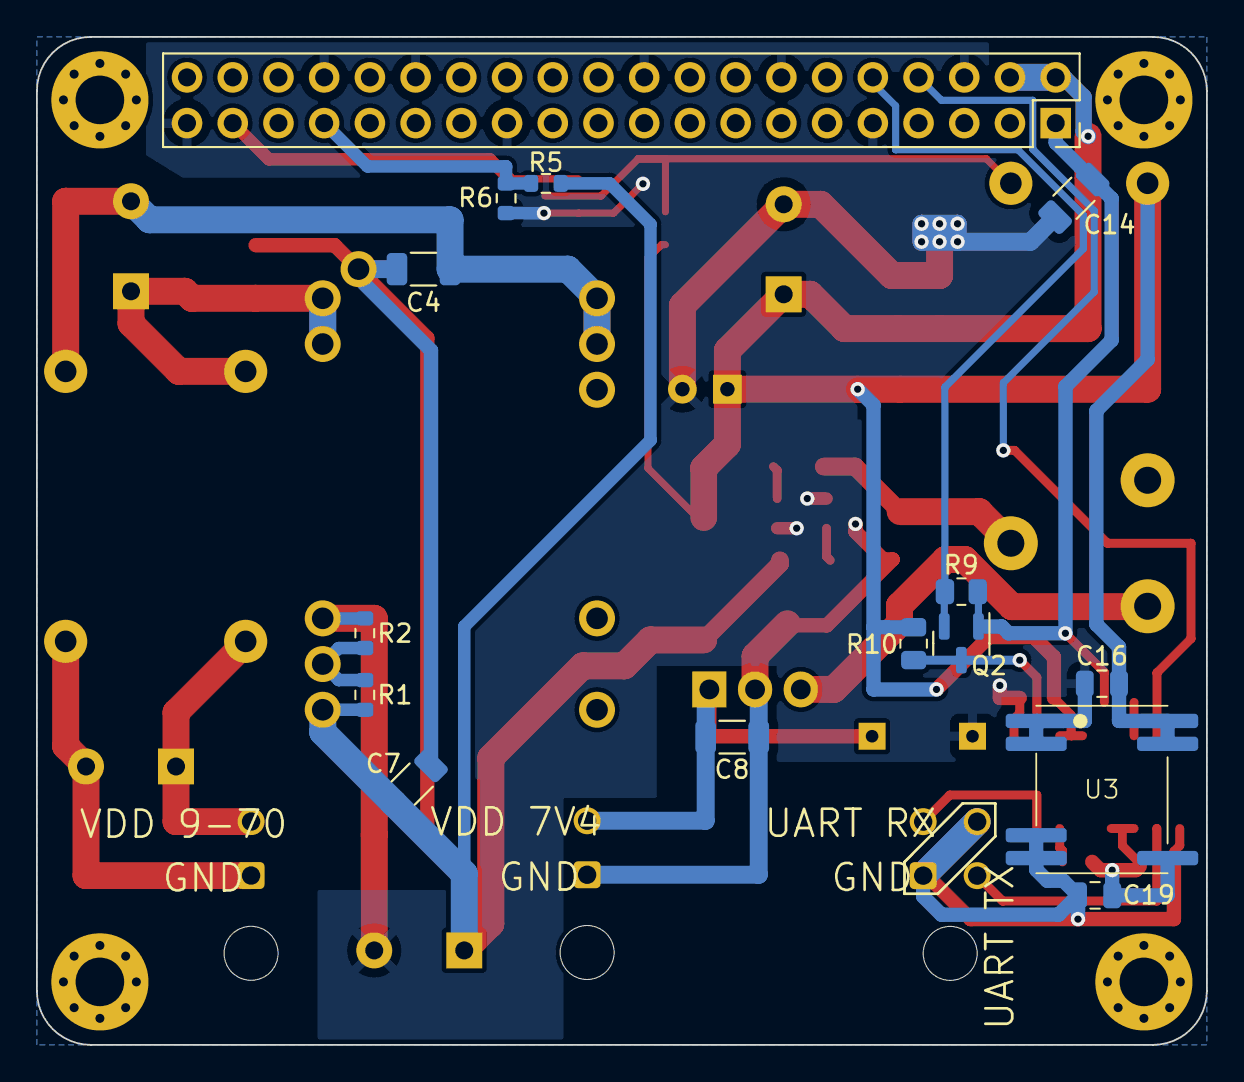
[picture p81: board power_sheld.kicad_pcb from below]

Board: 2 copper layers, 65.0 x 56.0 mm, 54 parts (15 on the bottom side), 27 nets.

Parts:
C1, C2, C12: 10u; CP_Radial_D10.0mm_P5.00mm
C3, C4, C6, C7: 330p; C_1206_3216Metric
C5: 220u; CP_Radial_D10.0mm_P5.00mm
C8, C10, C11, C14: 100n; C_1206_3216Metric
C9: 22u; CP_EIA-7343-31_Kemet-D
C13: 1u; C_1206_3216Metric
C15: 100u; CP_Radial_D6.3mm_P2.50mm
C16: 4u7; C_0805_2012Metric
C17, C18: 100n; C_0805_2012Metric
C19: 10u; C_0805_2012Metric
D1, D2: SS54C; D_SMC
D3, D4: FYLS-1206SRC; D_1206_3216Metric
H1, H2, H3, H4: MountingHole; MountingHole_2.7mm_M2.5_Pad_Via
J1, J3: Micro-fit_1x2P; Molex_Micro-Fit_3.0_43045-0200_2x01_P3.00mm_Horizontal
J2: RPi; PinSocket_2x20_P2.54mm_Vertical
J4: Micro-Fit_2x2P; Molex_Micro-Fit_3.0_43045-0400_2x02_P3.00mm_Horizontal
K1: NRP-12-C-05D-H
L1: B82721-K2222-U30
Q1, Q2: BSS138; SOT-23
R1, R2: R_reg; R_0603_1608Metric
R3, R4, R9, R10: 10k; R_0805_2012Metric
R5: 1k5; R_0603_1608Metric
R6: 2k; R_0603_1608Metric
R7, R8, R12: 360; R_0603_1608Metric
R11: 220; R_0603_1608Metric
TP1, TP2: TestPoint; TestPoint_THTPad_1.5x1.5mm_Drill0.7mm
U1: VDV8-1E05
U2: L4940V5; TO-220-3_Horizontal_TabDown
U3: B0505MT-1WR4
U4, U5: HCPL-0600; SO-8_3.9x4.9mm_P1.27mm

Connections:
5V0_SENS: C5.1, C7.1, D1.2 (A), D3.2 (A), R1.1, R5.2, U1.14 (+VOUT)
/5V_ISO: C18.1, C19.1, R12.2, U3.8 (+Vo), U4.7 (VE), U4.8 (VCC)
/BATT_7.4_IN: C8.1, J3.2, TP1.1, U2.1 (IN)
/GND_9-70_IN: C2.2, J1.1, L1.2
/GND_UART_ISO: C18.2, C19.2, J4.1 (Pin_2), J4.4, U3.6 (0V), U3.7 (0V), U4.5 (GND)
/VDD_9-70_IN: C2.1, J1.2, L1.1
GND: C5.2, C6.1, C8.2, C9.2, C10.2, C11.2, C12.2, C13.2, C14.1, C15.2, C16.2, C17.2, J2.6, J2.9, J2.14, J2.20, J2.25, J2.30, J2.34, J2.39, J3.1, Q1.2 (S), R2.2, R4.1, R6.2, R7.1, R8.1, TP2.1, U1.16 (-VOUT), U2.2 (GND), U3.1 (gnd), U3.2 (gnd), U5.5 (GND)
unnamed: C1.1, C3.1, L1.4, U1.22 (+VIN), U1.23 (+VIN)
unnamed: C1.2, C4.1, L1.3, U1.2 (-VIN), U1.3 (-VIN)
unnamed: D2.2 (A), D4.2 (A), K1.1
unnamed: D3.1 (K), R8.2
unnamed: D4.1 (K), R7.2
unnamed: J2.33, R5.1, R6.1
unnamed: J2.37, Q1.1 (G), R4.2
unnamed: J4.2 (Pin_1), U4.6 (VOut)
unnamed: J4.3, U5.3 (Cathode)
unnamed: Q2.3 (D), R10.2, U5.6 (VOut)
unnamed: R1.2, R2.1, U1.15 (REG)
unnamed: C3.2, C4.2, C6.2, C7.2, U1.24 (SHIELD)
unnamed: C9.1, C10.1, K1.3, U2.3 (OUT)
unnamed: R11.2, U4.2 (Anode)
unnamed: R12.1, U5.2 (Anode)
RELAY_SIG: K1.2, Q1.3 (D), R3.2
UART_RX: J2.10, Q2.2 (S), R9.2
UART_TX: J2.8, U4.3 (Cathode)
VDD_3V3: C14.2, J2.1, Q2.1 (G), R9.1, R11.1
VDD_5V0: C11.1, C12.1, C13.1, C15.1, C16.1, C17.1, D1.1 (K), D2.1 (K), J2.2, J2.4, K1.5, R3.1, R10.1, U3.13 (Vin), U3.14 (Vin), U5.7 (VE), U5.8 (VCC)
