AeroKITties/Kitties-Hardware/Hardware/Penguin Junior/Penguin Junior.kicad_pcb

## KiCad design Hardware/Penguin Junior/Penguin Junior.kicad_pcb (2024-03-14)

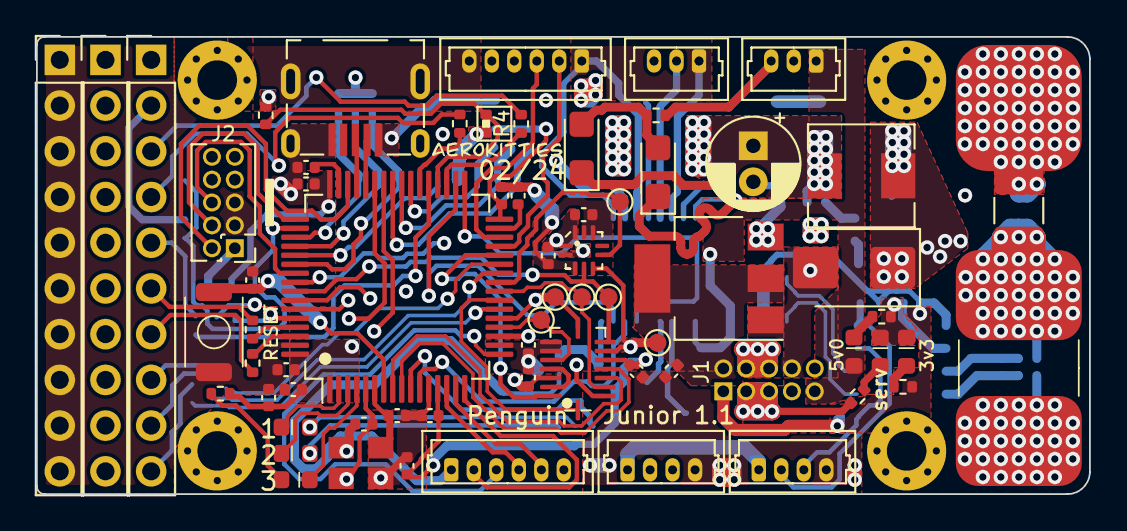
[picture p82: board Penguin Junior.kicad_pcb from above]

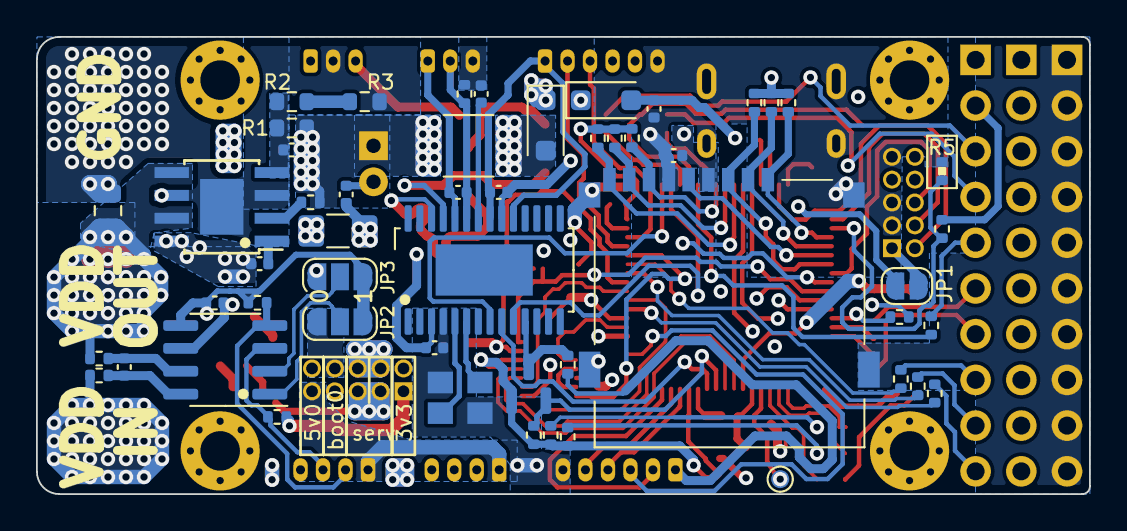
[picture p83: board Penguin Junior.kicad_pcb from below]

Board: 4 copper layers, 58.5 x 25.4 mm, 123 parts (52 on the bottom side), 103 nets.

Parts:
C1, C2, C3, C4, C5, C6, C9, C14, C15, C16, C17, C18, C19, C22, C24, C25, C26, C27, C28, C35: 100n; C_0402_1005Metric
C7, C34: 4u7; C_0402_1005Metric
C8, C33: 1u; C_0402_1005Metric
C10, C11: 8p; C_0402_1005Metric
C12, C13: 2u2; C_0402_1005Metric
C20, C21: 47; CP_EIA-3216-12_Kemet-S
C29: 10u; C_1210_3225Metric
C30: 100n; C_0805_2012Metric
C31: 100u; CP_Radial_D5.0mm_P2.00mm
C32: 150p; C_0402_1005Metric
D1, D2, D3: LED_MCU; LED_0603_1608Metric
D4, D6: PMEG2020EH; D_SOD-123F
D5: STPS3L60U; D_SMB
D7: LED_5V; LED_0603_1608Metric
D8: LED_SERVO; LED_0603_1608Metric
D9: LED_3V3; LED_0603_1608Metric
F1: MF-MSMF260-2; Fuse_1812_4532Metric_Pad1.30x3.40mm_HandSolder
F2: MF-NSMF050-2; Fuse_1206_3216Metric_Pad1.42x1.75mm_HandSolder
H1, H2, H3, H4: MountingHole; MountingHole_2.2mm_M2_Pad_Via
J1, J2: Conn_02x05_SWD; PinHeader_2x05_P1.27mm_Vertical
J3: Micro_SD_Card_Det1; TF01A
J4, J6: Conn_01x03_Video; Molex_PicoBlade_53047-0310_1x03_P1.25mm_Vertical
J5: USB_B_Micro; U-F-M5DD-W-2-SUS
J7, J12: Conn_01x06_UART; Molex_PicoBlade_53047-0610_1x06_P1.25mm_Vertical
J8: Conn_01x04_I2C; Molex_PicoBlade_53047-0410_1x04_P1.25mm_Vertical
J9, J10, J11: Conn_01x10; PinHeader_1x10_P2.54mm_Vertical
J13: Conn_01x04_UART; Molex_PicoBlade_53047-0410_1x04_P1.25mm_Vertical
J14: Conn_01x01; ContactPlatform_7.0x7.0
JP1: SolderJumper_2_Open; SolderJumper-2_P1.3mm_Open_RoundedPad1.0x1.5mm
JP2, JP3: SolderJumper_3_Open; SolderJumper-3_P1.3mm_Open_RoundedPad1.0x1.5mm_NumberLabels
L1: 4u7; L_Sunlord_MWSA0503S
Q1: BSS138; SOT-23
R1: 10K; R_0603_1608Metric
R2: 3K; R_0603_1608Metric
R3: 75; R_0603_1608Metric
R4, R5: 330; R_0402_1005Metric
R6, R9: 75; R_0402_1005Metric
R7, R8, R10, R11, R12, R13, R14, R15, R16: 10K; R_0402_1005Metric
R17, R18, R19, R22, R23, R24, R25, R26, R27, R28, R30, R31, R33, R34, R35, R36, R37, R38: 220; R_0402_1005Metric
R20, R21: 4k7; R_0402_1005Metric
R29: 0m2; R2725
R32: 47K; R_0402_1005Metric
SW1: SW_Push; button_small
TP1, TP2, TP3, TP4, TP5, TP6, TP7: TestPointSignal; TestPoint_Pad_D1.0mm_low
U1: STM32F405RGTx; LQFP-64_10x10mm_P0.5mm
U2: BMP388; LGA-10_2x2x0.75mm
U3: BMI088; LGA-16_3x4.5x0.95mm
U4: MAX7456; HTSSOP-28-1EP_4.4x9.7mm_P0.65mm_EP2.85x5.4mm
U5: ST1S14PHR; TI_SO-PowerPAD-8
U6: INA219AxD; SOIC-8_3.9x4.9mm_P1.27mm
U7: LDL1117_3V3; SOT-223-3_TabPin2
Y1: 16MHz; Crystal_SMD_3225-4Pin_3.2x2.5mm
Y2: 27MHz; Crystal_SMD_3225-4Pin_3.2x2.5mm

Connections:
3V3_JP: C34.1, J1.2, U7.2 (VO)
5V0_JP: D4.1 (K), D6.1 (K), F2.1, J1.10
5V0_SERVO_JP: D6.2 (A), F1.1, J1.4, J1.6
BOOT0: R10.1, U1.60 (BOOT0)
GND: C1.1, C2.1, C3.1, C4.1, C5.1, C6.1, C7.1, C8.1, C9.1, C10.1, C11.1, C12.1, C13.1, C14.1, C15.1, C16.2, C17.2, C18.2, C19.2, C24.1, C25.2, C27.2, C29.1, C30.1, C31.2, C33.2, C34.2, C35.2, D5.2 (A), D8.1 (K), D9.1 (K), J1.8, J2.3, J2.5, J2.9, J3.6 (VSS), J3.10 (SHIELD), J4.2, J5.5 (GND), J5.6 (Shield), J6.2, J7.6, J8.4, J10.1, J10.2, J10.3, J10.4, J10.5, J10.6, J10.7, J10.8, J10.9, J10.10, J12.6, J13.4, J14.1, JP2.1 (A), JP3.1 (A), R3.1, R4.1, R5.2, R9.1, R36.1, SW1.1, U1.12 (VSSA), U1.18 (VSS), U1.63 (VSS), U2.3 (VSS), U2.8 (VSS), U2.9 (VSS), U3.2 (NC), U3.4 (GND), U3.6 (GNDIO), U3.7 (PS), U4.4 (DGND), U4.20 (AGND), U4.23 (PGND), U5.3 (~EN1), U5.6 (GND), U5.9 (PADGND), U6.6 (GND), U7.1 (GND), Y1.2, Y1.4, Y2.2, Y2.4
I2C1_SCL: J8.2, R21.1, U1.58 (PB6), U6.4 (SCL)
I2C1_SDA: J8.3, R20.1, U1.59 (PB7), U6.3 (SDA)
INTERRUPTION1_ACCEL: U1.23 (PA7), U3.16 (INT1)
INTERRUPTION2_ACCEL: U1.28 (PB2), U3.1 (INT2)
INTERRUPTION3_GYRO: U1.9 (PC1), U3.12 (INT3)
INTERRUPTION4_GYRO: U1.8 (PC0), U3.13 (INT4)
LED_MCU_0: D1.1 (K), U1.2 (PC13)
LED_MCU_1: D2.1 (K), U1.3 (PC14)
LED_MCU_2: D3.1 (K), U1.4 (PC15)
NRST: C9.2, J2.10, SW1.2, U1.7 (NRST)
unnamed: C20.2, C21.2, R6.1
unnamed: D1.2 (A), R33.1
unnamed: D2.2 (A), R34.1
unnamed: D3.2 (A), R35.1
unnamed: C26.2, D5.1 (K), L1.1, U5.8 (SW)
unnamed: D7.1 (K), R36.2
unnamed: D8.2 (A), R37.2
unnamed: D9.2 (A), R38.2
unnamed: J1.7, R10.2
unnamed: J2.1, JP1.2 (B)
unnamed: J9.1, R17.2
unnamed: J9.2, R18.2
unnamed: J9.3, R19.2
unnamed: J9.4, R22.2
unnamed: J9.5, R23.2
unnamed: J9.6, R24.2
unnamed: J9.7, R25.2
unnamed: J9.8, R26.2
unnamed: J9.9, R27.2
unnamed: J9.10, R28.2
unnamed: JP2.2 (C), U6.1 (A1)
unnamed: JP3.2 (C), U6.2 (A0)
unnamed: Q1.3 (D), R8.2, U4.11 (SDOUT)
unnamed: R2.1, R3.2
unnamed: C12.2, U1.31 (VCAP_1)
unnamed: C13.2, U1.47 (VCAP_2)
unnamed: U4.5 (CLKIN), Y2.3
unnamed: C20.1, U4.25 (SAG)
unnamed: C22.1, U4.22 (VIN)
unnamed: C21.1, U4.26 (VOUT)
unnamed: U4.6 (XFB), Y2.1
unnamed: C26.1, U5.1 (BOOT)
unnamed: C32.1, R1.1, R2.2, U5.4 (FB)
unnamed: R32.1, U5.2 (PG)
unnamed: C28.1, R30.2, U6.8 (IN+)
unnamed: C28.2, R31.2, U6.7 (IN-)
RCC_OSC_IN: C10.2, TP7.1, U1.5 (PH0), Y1.1
RCC_OSC_OUT: C11.2, U1.6 (PH1), Y1.3
SDIO_CD: J3.9 (DET), R11.2, U1.41 (PA8)
SDIO_CK: J3.5 (CLK), U1.53 (PC12)
SDIO_CMD: J3.3 (CMD), R14.2, U1.54 (PD2)
SDIO_D0: J3.7 (DAT0), R13.2, U1.39 (PC8)
SDIO_D1: J3.8 (DAT1), R12.2, U1.40 (PC9)
SDIO_D2: J3.1 (DAT2), R16.1, U1.51 (PC10)
SDIO_D3: J3.2 (DAT3/CD), R15.2, U1.52 (PC11)
SPI1_BMI088_ACCEL_CS: TP6.1, U1.24 (PC4), U3.14 (CSB1)
SPI1_BMI088_GYRO_CS: TP5.1, U1.20 (PA4), U3.5 (CSB2)
SPI1_CLK: TP3.1, U1.21 (PA5), U2.2 (SCK), U3.8 (SCL/SCK)
SPI1_MISO: TP2.1, U1.56 (PB4), U2.5 (SDO), U3.10 (SDO2), U3.15 (SDO1)
SPI1_MOSI: TP1.1, U1.57 (PB5), U2.4 (SDI), U3.9 (SDA/SDI)
SPI1_MS5611_CS: TP4.1, U1.25 (PC5), U2.6 (CSB)
SPI2_MISO: Q1.2 (S), R7.2, U1.10 (PC2)
SPI2_MOSI: U1.11 (PC3), U4.9 (SDIN)
SPI2_OSD_CS: U1.33 (PB12), U4.8 (CS)
SPI2_SCK: U1.34 (PB13), U4.10 (SCLK)
SYS_JTCK-SWCLK: J2.4, U1.49 (PA14)
SYS_JTDO-SWO: J2.6, U1.55 (PB3)
SYS_JTMS-SWDIO: J2.2, U1.46 (PA13)
TM2_CH1/ADC2_EXTI15: R5.1, R18.1, U1.50 (PA15)
TM3_CH1: R23.1, U1.37 (PC6)
TM3_CH2: R22.1, U1.38 (PC7)
TM3_CH3: R27.1, U1.26 (PB0)
TM3_CH4: R26.1, U1.27 (PB1)
TM4_CH3: R24.1, U1.61 (PB8)
TM4_CH4: R25.1, U1.62 (PB9)
TM12_CH1: R19.1, U1.35 (PB14)
TM12_CH2/ADC1_EXTI15: R4.2, R17.1, U1.36 (PB15)
TM13_CH1: R28.1, U1.22 (PA6)
USART1_RX: J13.3, U1.43 (PA10)
USART1_TX: J13.2, U1.42 (PA9)
USART2_CTS: J7.4, U1.14 (PA0)
USART2_RTS: J7.5, U1.15 (PA1)
USART2_RX: J7.3, U1.17 (PA3)
USART2_TX: J7.2, U1.16 (PA2)
USART3_RX: J12.3, U1.30 (PB11)
USART3_TX: J12.2, U1.29 (PB10)
USB_OTG_FS_D+: J5.3 (D+), U1.45 (PA12)
USB_OTG_FS_D-: J5.2 (D-), U1.44 (PA11)
VDD_3V3: C1.2, C2.2, C3.2, C4.2, C5.2, C6.2, C7.2, C8.2, C14.2, C15.2, C16.1, C24.2, C27.1, C35.1, J1.1, J3.4 (VDD), JP1.1 (A), JP2.3 (B), JP3.3 (B), Q1.1 (G), R7.1, R11.1, R12.1, R13.1, R14.1, R15.1, R16.2, R20.2, R21.2, R33.2, R34.2, R35.2, R38.1, U1.1 (VBAT), U1.13 (VDDA), U1.19 (VDD), U1.32 (VDD), U1.48 (VDD), U1.64 (VDD), U2.1 (VDDIO), U2.10 (VDD), U3.3 (VDD), U3.11 (VDDIO), U6.5 (VS)
VDD_5V: C17.1, C18.1, C19.1, D7.2 (A), J1.9, J4.1, J6.1, J7.1, J8.1, J12.1, J13.1, R8.1, U4.3 (DVDD), U4.19 (RESET), U4.21 (AVDD), U4.24 (PVDD)
VDD_5V_SERVO: J1.3, J1.5, J11.1, J11.2, J11.3, J11.4, J11.5, J11.6, J11.7, J11.8, J11.9, J11.10, R37.1
VDD_5V_USB: C25.1, D4.2 (A), J5.1 (VBUS)
VDD_BUCK_5V: C31.1, C32.2, F1.2, L1.2, R1.2, R32.2
VDD_BUCK_6-26_IN: R29.2, R30.1
VDD_BUCK_6-26_OUT: C29.2, C30.2, R29.1, R31.1, U5.5 (EN2), U5.7 (VIN)
VDD_LDO_5V_IN: C33.1, F2.2, U7.3 (VI)
VIDEO_IN: C22.2, J6.3, R9.2
VIDEO_OUT: J4.3, R6.2
