AeroKITties/Kitties-Hardware/Hardware/Royal Penguin/2.0/2.0.kicad_pcb

## KiCad design Hardware/Royal Penguin/2.0/2.0.kicad_pcb (2024-03-14)

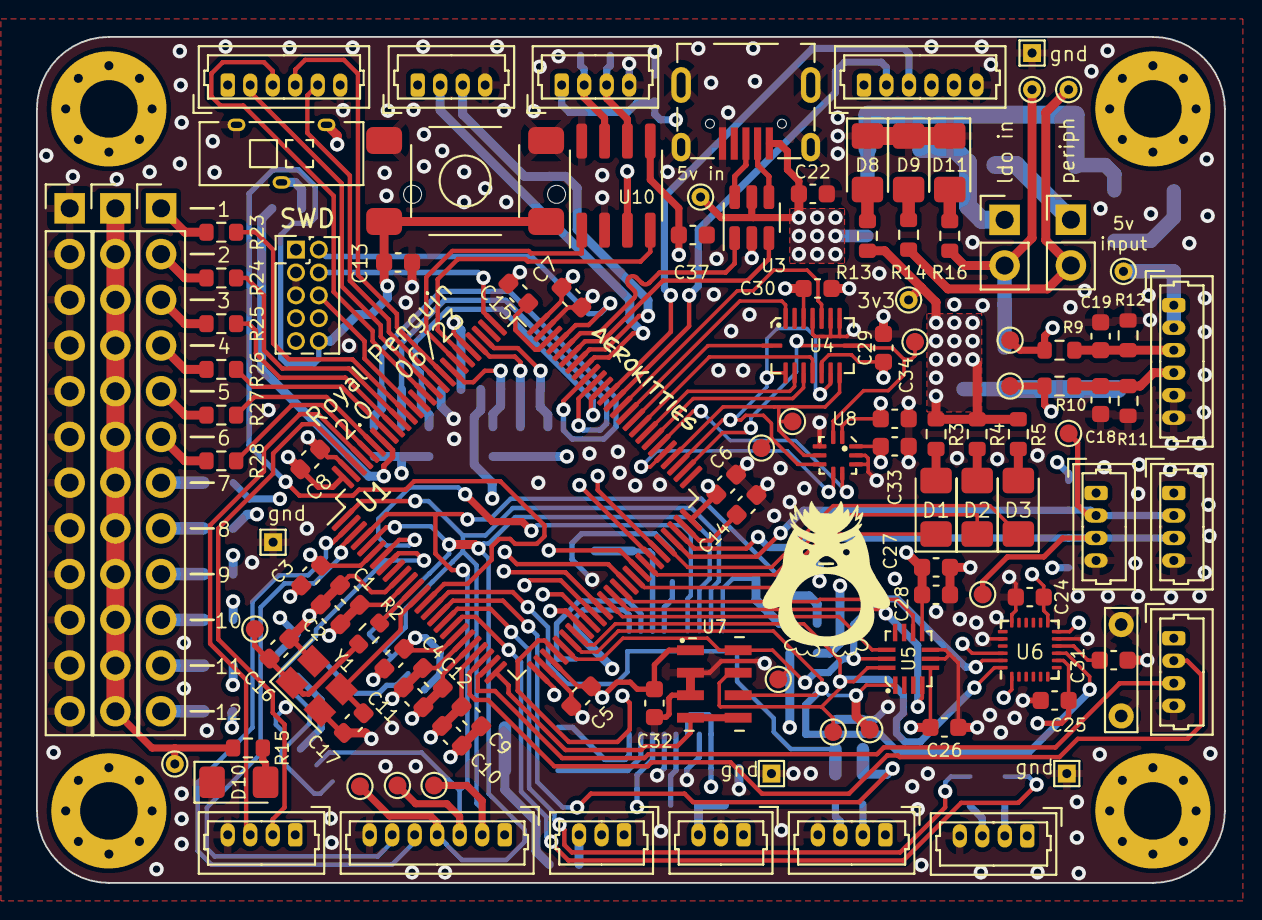
[picture p84: board 2.0.kicad_pcb from above]

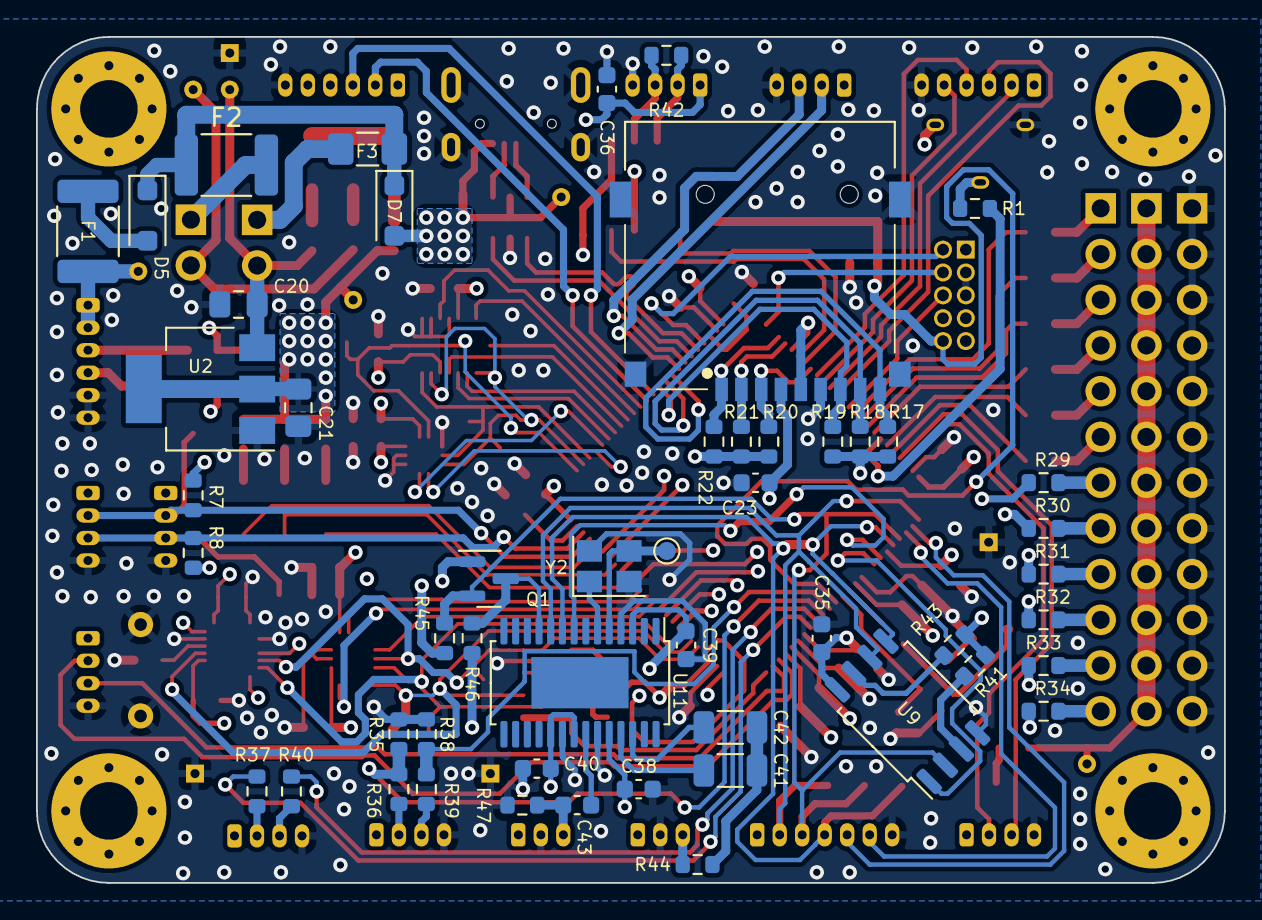
[picture p85: board 2.0.kicad_pcb from below]

Board: 4 copper layers, 66.0 x 47.0 mm, 169 parts (51 on the bottom side), 136 nets.

Parts:
C1: 4u7; C_0603_1608Metric
C2, C3, C4, C5, C6, C7, C8, C9, C11, C13, C18, C19, C22, C23, C24, C25, C27, C29, C30, C31, C32, C33, C34, C35, C36, C37, C38, C39, C40, C43: 100n; C_0603_1608Metric
C10, C12: 1u; C_0603_1608Metric
C14, C15, C28: 2u2; C_0603_1608Metric
C16, C17: 8p; C_0603_1608Metric
C20: 1u; C_0805_2012Metric_Pad1.18x1.45mm_HandSolder
C21: 4u7; C_0805_2012Metric_Pad1.18x1.45mm_HandSolder
C26: 10n; C_0603_1608Metric
C41, C42: 47u; C_1206_3216Metric
D1, D2, D3: LED_MCU; LED_1206_3216Metric_Pad1.42x1.75mm_HandSolder
D5, D7: PMEG2020EH; D_SOD-123F
D8, D9, D10, D11: LED_POWER; LED_1206_3216Metric_Pad1.42x1.75mm_HandSolder
F1, F2: MF-MSMF260-2; Fuse_1812_4532Metric_Pad1.30x3.40mm_HandSolder
F3: MF-NSMF050-2; Fuse_1206_3216Metric_Pad1.42x1.75mm_HandSolder
H1, H2, H3, H4: MH_M3_Corner; MountingHole_3.2mm_M3_Pad_Via
J1: Conn_Power_brick_01x06; Molex_PicoBlade_53047-0610_1x06_P1.25mm_Vertical
J2, J5: Conn_01x03_Video; Molex_PicoBlade_53047-0310_1x03_P1.25mm_Vertical
J3: USB_B_Micro; U-F-M5DD-W-2-SUS
J4: Micro_SD_Card_Con; TF01A
J6, J7, J8: Conn_01x12_servo; PinHeader_1x12_P2.54mm_Vertical
J9, J12: Conn_01x04_I2C; Molex_PicoBlade_53047-0410_1x04_P1.25mm_Vertical
J10, J11: Conn_01x06_UART; Molex_PicoBlade_53047-0610_1x06_P1.25mm_Vertical
J13, J14, J15: Conn_01x04_UART; Molex_PicoBlade_53047-0410_1x04_P1.25mm_Vertical
J16: Conn_02x05_SWD; PinHeader_2x05_P1.27mm_Vertical
J17: Conn_01x07_SPI; Molex_PicoBlade_53047-0710_1x07_P1.25mm_Vertical
J18, J19: Conn_01x04_ADC; Molex_PicoBlade_53047-0410_1x04_P1.25mm_Vertical
J20: Conn_01x04_CAN; Molex_PicoBlade_53047-0410_1x04_P1.25mm_Vertical
JP1, JP2: Jumper_power; PinHeader_1x02_P2.54mm_Vertical
Q1: BSS138; SOT-23
R1, R9, R10, R35, R36, R37, R38, R39, R40, R41, R43, R45, R46: 10k; R_0603_1608Metric
R2: 0; R_0603_1608Metric
R3, R4, R5, R13, R14, R15, R16: 220; R_0603_1608Metric
R7, R8: 4k7; R_0603_1608Metric
R11, R12: 1M; R_0603_1608Metric
R17, R18, R19, R20, R21, R22: 100k; R_0603_1608Metric
R23, R24, R25, R26, R27, R28, R29, R30, R31, R32, R33, R34: 22; R_0603_1608Metric
R42: 120; R_0603_1608Metric
R44, R47: 75; R_0603_1608Metric
SW1: SW_RESET; tactile switch 6x6mm smd
SW2: SW_BOOT0; MSS-12D16
TP1, TP2, TP3, TP5, TP6, TP7, TP8, TP9, TP10, TP11, TP12, TP13, TP14: TestPointSignal; TestPoint_Pad_D1.0mm
TP4, TP25: TestPointCrystal; TestPoint_Pad_D1.0mm
TP15, TP16, TP17, TP18, TP19, TP26: TestPointPower; TestPoint_THTPad_D1.0mm_Drill0.5mm
TP20, TP21, TP22, TP23: TestPointGND; TestPoint_THTPad_1.0x1.0mm_Drill0.5mm
TP24: BridgeGND; TestPoint_Bridge_Pitch5.08mm_Drill0.7mm
U1: STM32F427VGTx; LQFP-100_14x14mm_P0.5mm
U2: LDL1117S33R; SOT-223-3_TabPin2
U3: USBLC6-2SC6; SOT-23-6
U4: BMI088; LGA-16_3x4.5x0.95mm
U5: ICM-42688-P; LGA-14_2.5x3x0.91mm
U6: MPU-9250; InvenSense_QFN-24_3x3mm_P0.4mm
U7: MS5611-01BA; LGA-8_3x5mm_P1.25mm_handsolder
U8: BMP388; LGA-10_2x2x0.75mm
U9: W25Q32FVSSIG; SOIC-8_5.275x5.275mm_P1.27mm
U10: TJA1051T-3; SOIC-8_3.9x4.9mm_P1.27mm
U11: MAX7456; HTSSOP-28-1EP_4.4x9.7mm_P0.65mm_EP2.85x5.4mm
Y1: 16M; Crystal_SMD_3225-4Pin_3.2x2.5mm
Y2: 27M; Crystal_SMD_3225-4Pin_3.2x2.5mm

Connections:
/Connections/usb_conn_d+: J3.3 (D+), U3.6 (I/O1)
/Connections/usb_conn_d-: J3.2 (D-), U3.4 (I/O2)
/OSD/MAX7456_MISO_5V: Q1.3 (D), R46.2, U11.11 (SDOUT)
ADC2_IN10: R38.2, R39.1, U1.15 (PC0)
ADC2_IN11: R35.2, R36.1, U1.16 (PC1)
ADC2_IN12: R40.1, U1.17 (PC2)
ADC2_IN13: R37.1, U1.18 (PC3)
BATT_CURRENT_SENS: R9.2, TP14.1, U1.33 (PC4)
BATT_VOLT_SENS: R10.2, TP13.1, U1.34 (PC5)
BMI088_INT1: U1.60 (PD13), U4.16 (INT1)
BMI088_INT2: U1.61 (PD14), U4.1 (INT2)
BMI088_INT3: U1.59 (PD12), U4.12 (INT3)
BMI088_INT4: U1.57 (PD10), U4.13 (INT4)
BOOT0: R1.1, U1.94 (BOOT0)
CAN1_RX: U1.81 (PD0), U10.4 (RXD)
CAN1_TX: U1.82 (PD1), U10.1 (TXD)
CAN_HIGH: J20.2, R42.1, U10.7 (CANH)
CAN_LOW: J20.3, R42.2, U10.6 (CANL)
CS_BMI088_A: U1.58 (PD11), U4.14 (CSB1)
CS_BMI088_G: U1.62 (PD15), U4.5 (CSB2)
CS_BMP388: U1.55 (PD8), U8.6 (CSB)
CS_EXT0: J17.5, U1.2 (PE3)
CS_EXT1: J17.6, U1.3 (PE4)
CS_FLASH: U1.8 (PC14), U9.1 (~CS)
CS_ICM42688P: U1.37 (PB2), U5.12 (AP_CS)
CS_MPU9250: U1.29 (PA4), U6.22 (~CS)
CS_MS5611: U1.25 (PA2), U7.4 (CSB), U7.5 (CSB)
CS_OSD: U1.7 (PC13), U11.8 (CS)
GND: C1.2, C2.2, C3.2, C4.2, C5.2, C6.2, C7.2, C8.2, C9.2, C10.2, C11.2, C12.2, C13.2, C14.2, C15.2, C16.2, C17.2, C18.2, C19.2, C20.2, C21.2, C22.2, C23.1, C24.2, C25.2, C26.2, C27.2, C28.2, C29.2, C30.2, C31.2, C32.1, C33.1, C34.1, C35.1, C36.2, C37.2, C38.2, C39.2, C40.2, D8.1 (K), D9.1 (K), D10.1 (K), D11.1 (K), J1.5, J1.6, J2.2, J3.5 (GND), J3.6 (Shield), J4.6 (VSS), J4.10 (SHIELD), J5.2, J7.1, J7.2, J7.3, J7.4, J7.5, J7.6, J7.7, J7.8, J7.9, J7.10, J7.11, J7.12, J9.4, J10.6, J11.6, J12.4, J13.4, J14.4, J15.4, J16.3, J16.5, J16.9, J17.7, J18.4, J19.4, J20.4, R11.2, R12.2, R35.1, R38.1, R47.1, SW1.2, SW2.3 (C), TP20.1, TP21.1, TP22.1, TP23.1, TP24.1, U1.10 (VSS), U1.20 (VSSA), U1.27 (VSS), U1.74 (VSS), U1.99 (VSS), U2.1 (GND), U3.2 (GND), U4.4 (GND), U4.6 (GNDIO), U4.7 (PS), U5.6 (GND), U5.7 (RESV), U6.11 (FSYNC), U6.18 (GND), U6.20 (RESV_GND), U7.2 (PS), U7.3 (GND), U8.3 (VSS), U8.8 (VSS), U8.9 (VSS), U9.4 (GND), U10.2 (GND), U10.8 (S), U11.4 (DGND), U11.20 (AGND), U11.23 (PGND), Y1.2, Y1.4, Y2.2, Y2.4
HSE_IN: R2.2, U1.12 (PH0)
HSE_OUT: C17.1, U1.13 (PH1), Y1.3
I2C2_SCL: J9.2, J12.2, R7.1, TP11.1, U1.47 (PB10)
I2C2_SDA: J9.3, J12.3, R8.1, TP12.1, U1.48 (PB11)
ICM42688P_INT1: U1.38 (PE7), U5.4 (INT1/INT)
ICM42688P_INT2: U1.39 (PE8), U5.9 (INT2/FSYNC/CLKIN)
INT_BMP388: U1.56 (PD9), U8.7 (INT)
LED_MCU_0: D1.1 (K), U1.41 (PE10)
LED_MCU_1: D2.1 (K), U1.43 (PE12)
LED_MCU_2: D3.1 (K), U1.46 (PE15)
MPU9250_INT: U1.26 (PA3), U6.12 (INT)
NRST: C13.1, J16.10, SW1.1, U1.14 (NRST)
unnamed: C16.1, R2.1, TP4.1, Y1.1
unnamed: C41.2, C42.2, R44.1
unnamed: D1.2 (A), R3.1
unnamed: D2.2 (A), R4.1
unnamed: D3.2 (A), R5.1
unnamed: D5.2 (A), F1.2
unnamed: D5.1 (K), D7.1 (K), F2.1, F3.1
unnamed: D8.2 (A), R13.2
unnamed: D9.2 (A), R14.2
unnamed: D10.2 (A), R15.2
unnamed: D11.2 (A), R16.2
unnamed: C19.1, J1.3, R9.1, R12.1
unnamed: C18.1, J1.4, R10.1, R11.1
unnamed: J6.1, R23.2
unnamed: J6.2, R24.2
unnamed: J6.3, R25.2
unnamed: J6.4, R26.2
unnamed: J6.5, R27.2
unnamed: J6.6, R28.2
unnamed: J6.7, R29.2
unnamed: J6.8, R30.2
unnamed: J6.9, R31.2
unnamed: J6.10, R32.2
unnamed: J6.11, R33.2
unnamed: J6.12, R34.2
unnamed: J18.2, R36.2
unnamed: J18.3, R39.2
unnamed: J19.2, R37.2
unnamed: J19.3, R40.2
unnamed: F2.2, JP1.1 (A)
unnamed: F3.2, JP2.1 (A)
unnamed: R1.2, SW2.2 (B)
unnamed: C31.1, U6.10 (REGOUT)
unnamed: R41.1, U9.3 (IO2)
unnamed: R43.1, U9.7 (IO3)
unnamed: TP25.1, U11.5 (CLKIN), Y2.3
unnamed: C41.1, U11.25 (SAG)
unnamed: C43.1, U11.22 (VIN)
unnamed: C42.1, U11.26 (VOUT)
unnamed: U11.6 (XFB), Y2.1
SDIO_CLK: J4.5 (CLK), U1.80 (PC12)
SDIO_CMD: J4.3 (CMD), R20.2, U1.83 (PD2)
SDIO_DAT0: J4.7 (DAT0), R19.2, U1.65 (PC8)
SDIO_DAT1: J4.8 (DAT1), R18.2, U1.66 (PC9)
SDIO_DAT2: J4.1 (DAT2), R22.2, U1.78 (PC10)
SDIO_DAT3: J4.2 (DAT3/CD), R21.2, U1.79 (PC11)
SD_CD: J4.9 (DET), R17.2, U1.67 (PA8)
SPI1_MISO: TP2.1, U1.31 (PA6), U5.1 (AP_SDO/AP_AD0), U6.9 (AD0/MISO), U7.6 (SDO)
SPI1_MOSI: TP3.1, U1.32 (PA7), U5.14 (AP_SDI/AP_SDA), U6.24 (SDA/MOSI), U7.7 (SDI/SDA)
SPI1_SCK: TP1.1, U1.30 (PA5), U5.13 (AP_SCL/AP_SCLK), U6.23 (SCL/SCLK), U7.8 (SCLK)
SPI2_MISO: TP6.1, U1.53 (PB14), U4.10 (SDO2), U4.15 (SDO1), U8.5 (SDO)
SPI2_MOSI: TP7.1, U1.54 (PB15), U4.9 (SDA/SDI), U8.4 (SDI)
SPI2_SCK: TP5.1, U1.52 (PB13), U4.8 (SCL/SCK), U8.2 (SCK)
SPI4_MISO: J17.3, Q1.2 (S), R45.2, TP9.1, U1.4 (PE5), U9.2 (DO(IO1))
SPI4_MOSI: J17.4, TP10.1, U1.5 (PE6), U9.5 (DI(IO0)), U11.9 (SDIN)
SPI4_SCK: J17.2, TP8.1, U1.1 (PE2), U9.6 (CLK), U11.10 (SCLK)
SYS_SWCLK: J16.4, U1.76 (PA14)
SYS_SWDIO: J16.2, U1.72 (PA13)
SYS_SWO: J16.6, U1.89 (PB3)
TIM1_CH1: R32.1, U1.40 (PE9)
TIM1_CH2: R31.1, U1.42 (PE11)
TIM1_CH3: R30.1, U1.44 (PE13)
TIM1_CH4: R29.1, U1.45 (PE14)
TIM3_CH1: R23.1, U1.90 (PB4)
TIM3_CH2: R24.1, U1.91 (PB5)
TIM3_CH3: R34.1, U1.35 (PB0)
TIM3_CH4: R33.1, U1.36 (PB1)
TIM4_CH1: R25.1, U1.92 (PB6)
TIM4_CH2: R26.1, U1.93 (PB7)
TIM4_CH3: R27.1, U1.95 (PB8)
TIM4_CH4: R28.1, U1.96 (PB9)
UART4_RX: J13.3, U1.24 (PA1)
UART4_TX: J13.2, U1.23 (PA0)
UART8_RX: J15.3, U1.97 (PE0)
UART8_TX: J15.2, U1.98 (PE1)
USART1_RX: J14.3, U1.69 (PA10)
USART1_TX: J14.2, U1.68 (PA9)
USART2_CTS: J10.4, U1.84 (PD3)
USART2_RTS: J10.5, U1.85 (PD4)
USART2_RX: J10.3, U1.87 (PD6)
USART2_TX: J10.2, U1.86 (PD5)
USART6_RX: J11.3, U1.64 (PC7)
USART6_TX: J11.2, U1.63 (PC6)
USB_D+: U1.71 (PA12), U3.1 (I/O1)
USB_D-: U1.70 (PA11), U3.3 (I/O2)
VCAP_1: C14.1, U1.49 (VCAP_1)
VCAP_2: C15.1, U1.73 (VCAP_2)
VDD_3V3: C1.1, C2.1, C3.1, C4.1, C5.1, C6.1, C7.1, C8.1, C9.1, C10.1, C11.1, C12.1, C21.1, C23.2, C24.1, C25.1, C26.1, C27.1, C28.1, C29.1, C30.1, C32.2, C33.2, C34.2, C35.2, C37.1, J4.4 (VDD), J16.1, Q1.1 (G), R3.2, R4.2, R5.2, R7.2, R8.2, R13.1, R17.1, R18.1, R19.1, R20.1, R21.1, R22.1, R41.2, R43.2, R45.1, SW2.1 (A), TP19.1, U1.6 (VBAT), U1.11 (VDD), U1.19 (VDD), U1.21 (VREF+), U1.22 (VDDA), U1.28 (VDD), U1.50 (VDD), U1.75 (VDD), U1.100 (VDD), U2.2 (VO), U4.3 (VDD), U4.11 (VDDIO), U5.5 (VDDIO), U5.8 (VDD), U6.1 (RESV_VDDIO), U6.8 (VDDIO), U6.13 (VDD), U7.1 (VDD), U8.1 (VDDIO), U8.10 (VDD), U9.8 (VCC), U10.5 (VIO)
VDD_5V_BRICK: F1.1, J1.1, J1.2, TP15.1
VDD_5V_LDO: C20.1, JP2.2 (B), R16.1, TP17.1, U2.3 (VI)
VDD_5V_PERIPH: C36.1, C38.1, C39.1, C40.1, J2.1, J5.1, J9.1, J10.1, J11.1, J12.1, J13.1, J14.1, J15.1, J17.1, J18.1, J19.1, J20.1, JP1.2 (B), R14.1, R46.1, TP16.1, U10.3 (VCC), U11.3 (DVDD), U11.19 (RESET), U11.21 (AVDD), U11.24 (PVDD)
VDD_5V_SERVO: J8.1, J8.2, J8.3, J8.4, J8.5, J8.6, J8.7, J8.8, J8.9, J8.10, J8.11, J8.12, R15.1, TP26.1
VDD_5V_VBUS: C22.1, D7.2 (A), J3.1 (VBUS), TP18.1, U3.5 (VBUS)
VIDEO_IN: C43.2, J5.3, R47.2
VIDEO_OUT: J2.3, R44.2
