AeroKITties/Kitties-Hardware/Hardware/Royal Penguin/0.0/FC0.kicad_pcb

## KiCad design Hardware/Royal Penguin/0.0/FC0.kicad_pcb (2023-02-15)

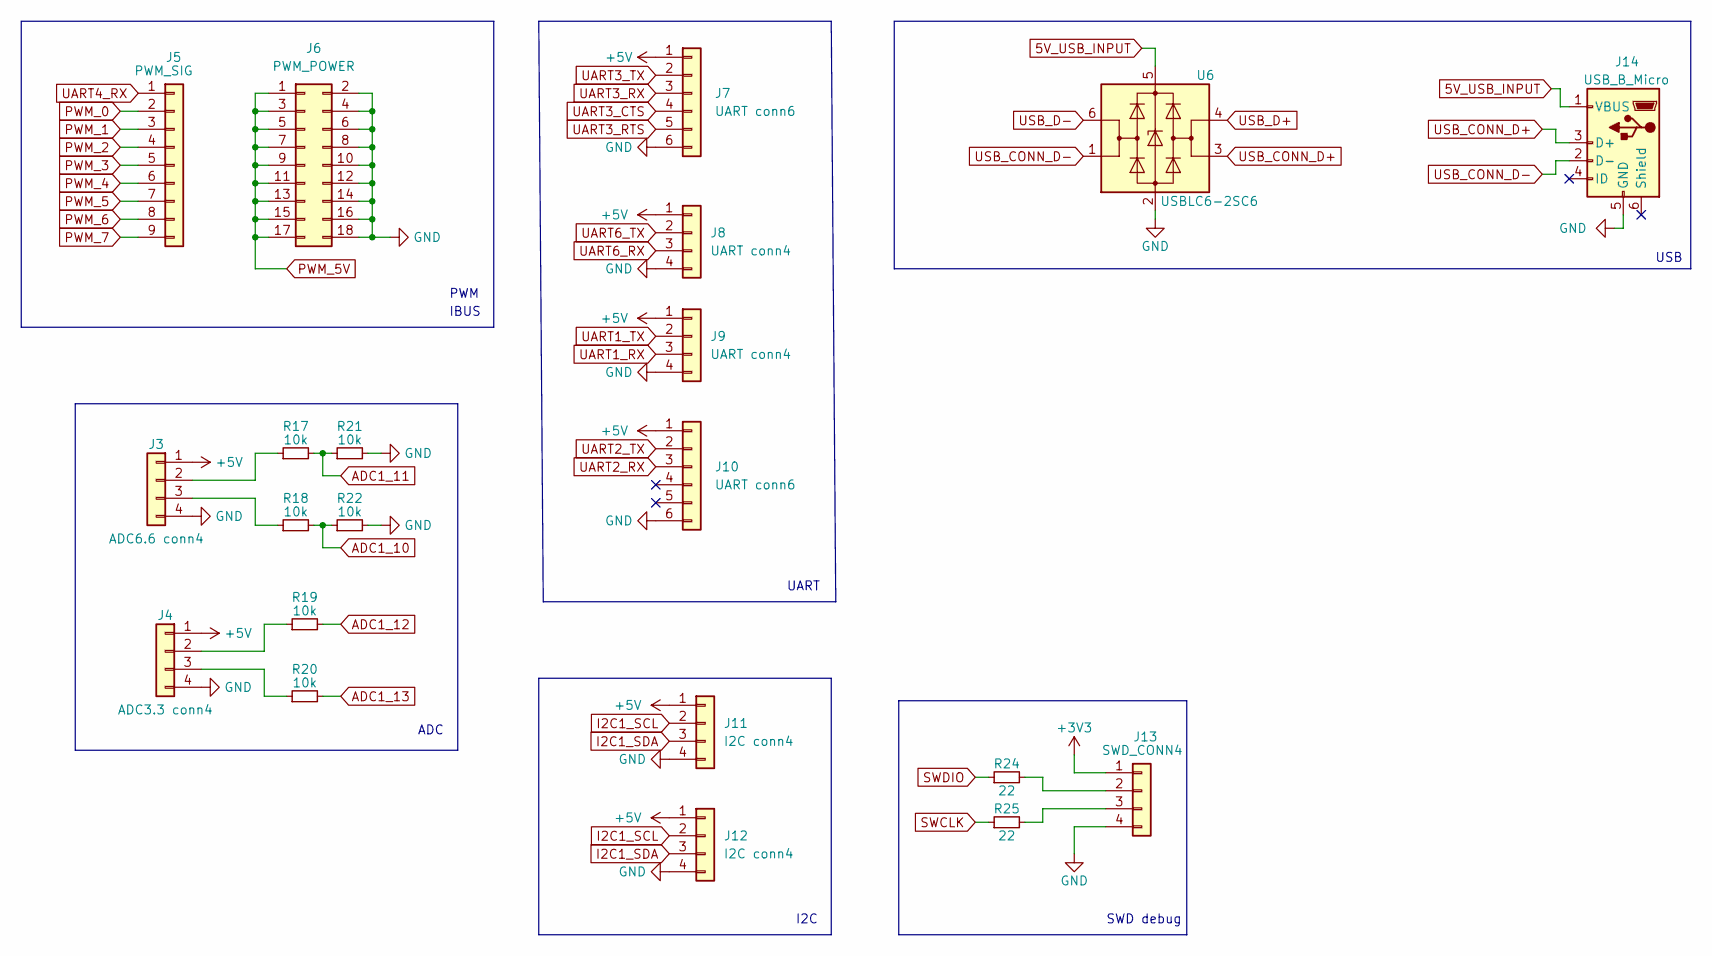
[picture p86: schematic connections.kicad_sch]

Parts:
J3: ADC6.6 conn4; Molex_PicoBlade_53047-0410_1x04_P1.25mm_Vertical
J4: ADC3.3 conn4; Molex_PicoBlade_53047-0410_1x04_P1.25mm_Vertical
J5: PWM_SIG; PinHeader_1x09_P2.54mm_Vertical
J6: PWM_POWER; PinHeader_2x09_P2.54mm_Vertical
J7, J10: UART conn6; Molex_PicoBlade_53047-0610_1x06_P1.25mm_Vertical
J8, J9: UART conn4; Molex_PicoBlade_53047-0410_1x04_P1.25mm_Vertical
J11, J12: I2C conn4; Molex_PicoBlade_53047-0410_1x04_P1.25mm_Vertical
J13: SWD_CONN4; PinHeader_1x04_P2.54mm_Vertical
J14: USB_B_Micro; USB_MICRO_B_10118193_0001LF
R17, R18, R19, R20, R21, R22: 10k; R_0603_1608Metric_Pad0.98x0.95mm_HandSolder; JLCPCB Part # C25804
R24, R25: 22; R_0603_1608Metric_Pad0.98x0.95mm_HandSolder; JLCPCB Part # C23345
U6: USBLC6-2SC6; SOT-23-6

Connections:
5V_USB_INPUT: J14.1 (VBUS), U6.5 (VBUS); also elsewhere on the board
+3V3: J13.1; also elsewhere on the board
+5V: J3.1, J4.1, J7.1, J8.1, J9.1, J10.1, J11.1, J12.1; also elsewhere on the board
ADC1_10: R18.2, R22.1; also elsewhere on the board
ADC1_11: R17.2, R21.1; also elsewhere on the board
ADC1_12: R19.2; also elsewhere on the board
ADC1_13: R20.2; also elsewhere on the board
GND: J3.4, J4.4, J6.2, J6.4, J6.6, J6.8, J6.10, J6.12, J6.14, J6.16, J6.18, J7.6, J8.4, J9.4, J10.6, J11.4, J12.4, J13.4, J14.5 (GND), R21.2, R22.2, U6.2 (GND); also elsewhere on the board
I2C1_SCL: J11.2, J12.2; also elsewhere on the board
I2C1_SDA: J11.3, J12.3; also elsewhere on the board
unnamed: J3.2, R17.1
unnamed: J3.3, R18.1
unnamed: J4.2, R19.1
unnamed: J4.3, R20.1
unnamed: J13.2, R24.2
unnamed: J13.3, R25.2
PWM_0: J5.2; also elsewhere on the board
PWM_1: J5.3; also elsewhere on the board
PWM_2: J5.4; also elsewhere on the board
PWM_3: J5.5; also elsewhere on the board
PWM_4: J5.6; also elsewhere on the board
PWM_5: J5.7; also elsewhere on the board
PWM_5V: J6.1, J6.3, J6.5, J6.7, J6.9, J6.11, J6.13, J6.15, J6.17; also elsewhere on the board
PWM_6: J5.8; also elsewhere on the board
PWM_7: J5.9; also elsewhere on the board
SWCLK: R25.1; also elsewhere on the board
SWDIO: R24.1; also elsewhere on the board
UART1_RX: J9.3; also elsewhere on the board
UART1_TX: J9.2; also elsewhere on the board
UART2_RX: J10.3; also elsewhere on the board
UART2_TX: J10.2; also elsewhere on the board
UART3_CTS: J7.4; also elsewhere on the board
UART3_RTS: J7.5; also elsewhere on the board
UART3_RX: J7.3; also elsewhere on the board
UART3_TX: J7.2; also elsewhere on the board
UART4_RX: J5.1; also elsewhere on the board
UART6_RX: J8.3; also elsewhere on the board
UART6_TX: J8.2; also elsewhere on the board
USB_CONN_D+: J14.3 (D+), U6.3 (I/O2)
USB_CONN_D-: J14.2 (D-), U6.1 (I/O1)
USB_D+: U6.4 (I/O2); also elsewhere on the board
USB_D-: U6.6 (I/O1); also elsewhere on the board

Notes on the sheet:
IBUS
UART
USB
PWM
SWD debug
I2C
ADC

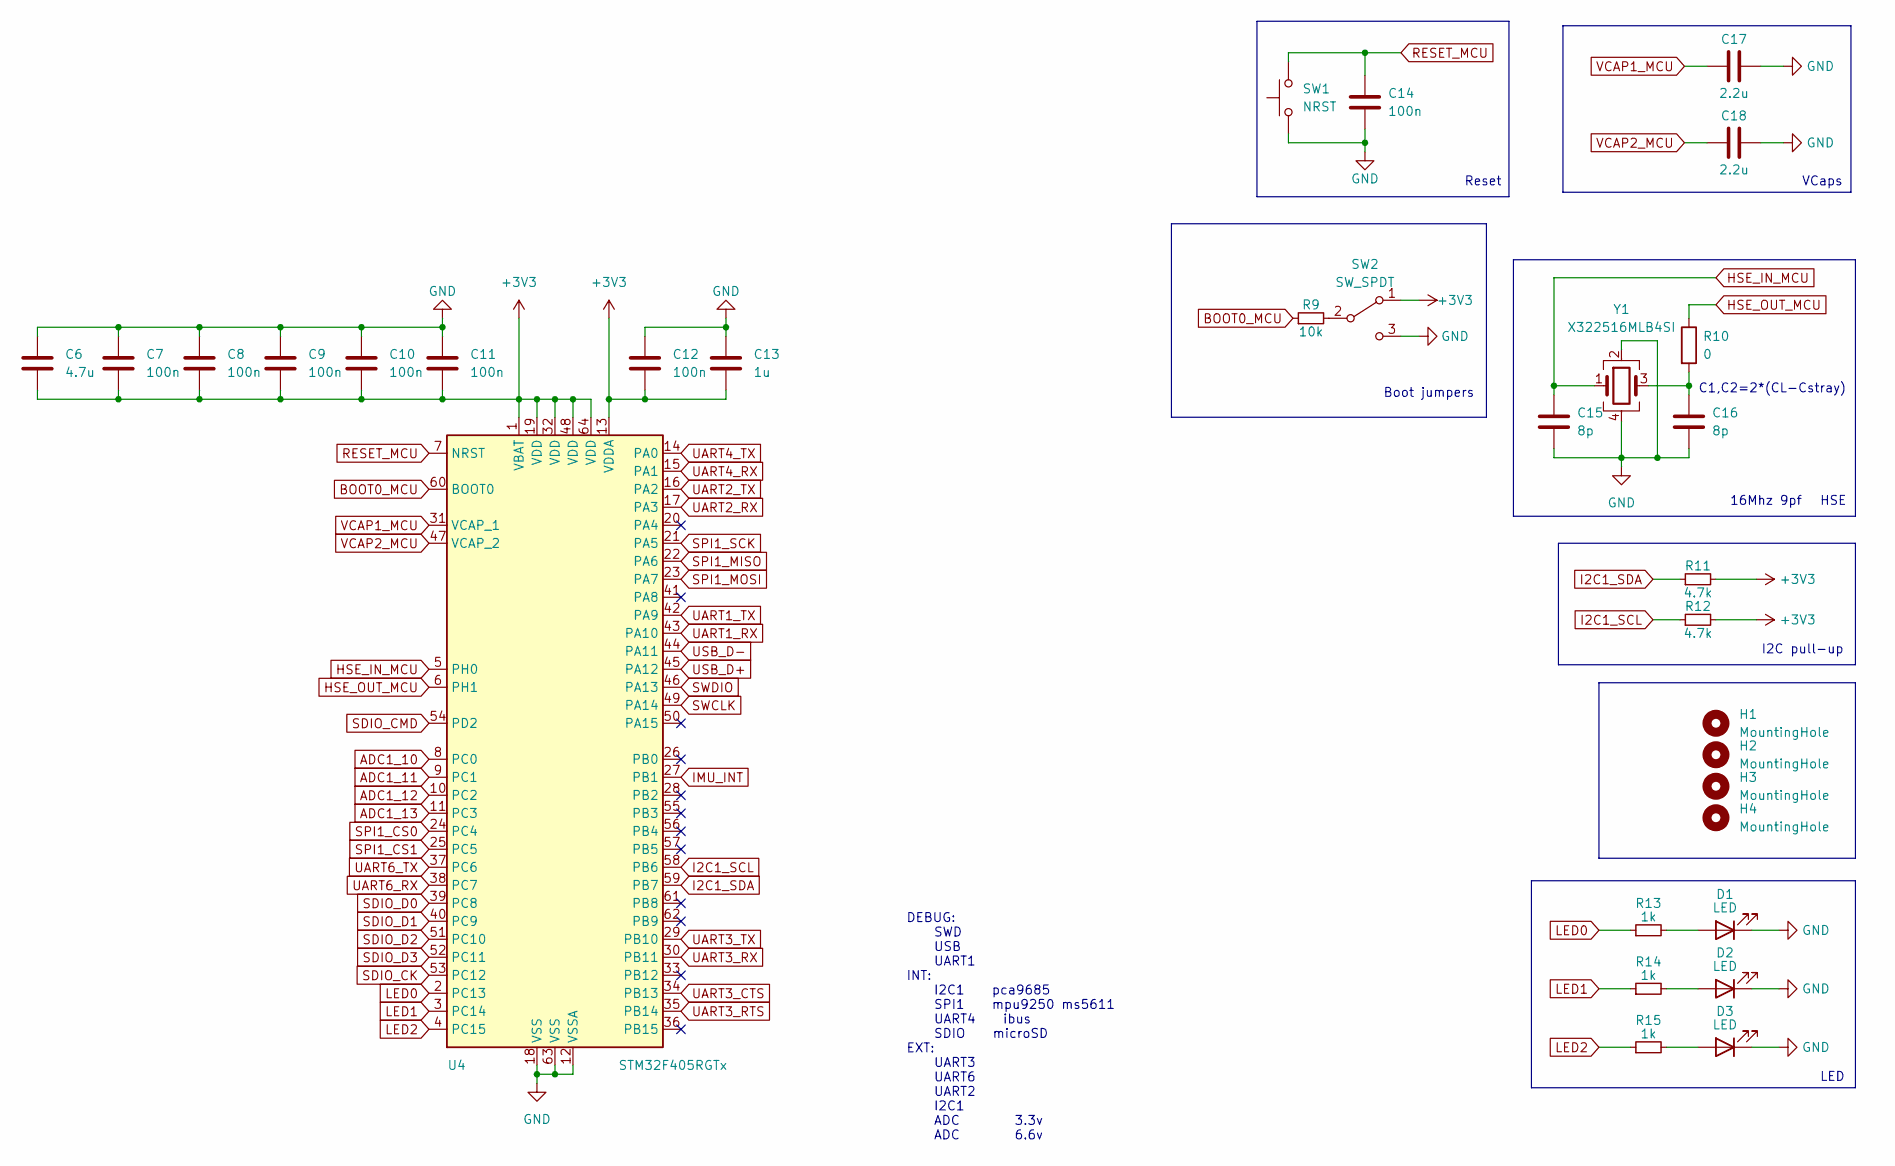
[picture p87: schematic mcu.kicad_sch]

Parts:
C6: 4.7u; C_0603_1608Metric_Pad1.08x0.95mm_HandSolder; JLCPCB Part # C19666
C7, C8, C9, C10, C11, C12, C14: 100n; C_0603_1608Metric_Pad1.08x0.95mm_HandSolder; JLCPCB Part # C14663
C13: 1u; C_0603_1608Metric_Pad1.08x0.95mm_HandSolder; JLCPCB Part # C15849
C15, C16: 8p; C_0603_1608Metric_Pad1.08x0.95mm_HandSolder; JLCPCB Part # C327316
C17, C18: 2.2u; C_0603_1608Metric_Pad1.08x0.95mm_HandSolder; JLCPCB Part # C23630
D1, D2, D3: LED; LED_0603_1608Metric_Pad1.05x0.95mm_HandSolder
H1, H2, H3, H4: MountingHole; MountingHole_3.2mm_M3_Pad_Via
R9: 10k; R_0603_1608Metric_Pad0.98x0.95mm_HandSolder; JLCPCB Part # C25804
R10: 0; R_0603_1608Metric_Pad0.98x0.95mm_HandSolder; JLCPCB Part # C21189
R11, R12: 4.7k; R_0603_1608Metric_Pad0.98x0.95mm_HandSolder; JLCPCB Part # C23162
R13, R14, R15: 1k; R_0603_1608Metric_Pad0.98x0.95mm_HandSolder; JLCPCB Part # C21190
SW1: NRST; SW_PUSH_6mm_H5mm
SW2: SW_SPDT; SW_SPDT_PCM12
U4: STM32F405RGTx; LQFP-64_10x10mm_P0.5mm
Y1: X322516MLB4SI; Crystal_SMD_3225-4Pin_3.2x2.5mm

Connections:
+3V3: C6.2, C7.2, C8.2, C9.2, C10.2, C11.2, C12.2, C13.2, R11.2, R12.2, SW2.1 (A), U4.1 (VBAT), U4.13 (VDDA), U4.19 (VDD), U4.32 (VDD), U4.48 (VDD), U4.64 (VDD); also elsewhere on the board
ADC1_10: U4.8 (PC0); also elsewhere on the board
ADC1_11: U4.9 (PC1); also elsewhere on the board
ADC1_12: U4.10 (PC2); also elsewhere on the board
ADC1_13: U4.11 (PC3); also elsewhere on the board
BOOT0_MCU: R9.1, U4.60 (BOOT0)
GND: C6.1, C7.1, C8.1, C9.1, C10.1, C11.1, C12.1, C13.1, C14.2, C15.2, C16.2, C17.2, C18.2, D1.1 (K), D2.1 (K), D3.1 (K), SW1.1, SW2.3 (C), U4.12 (VSSA), U4.18 (VSS), U4.63 (VSS), Y1.2, Y1.4; also elsewhere on the board
HSE_IN_MCU: C15.1, U4.5 (PH0), Y1.1
HSE_OUT_MCU: R10.1, U4.6 (PH1)
I2C1_SCL: R12.1, U4.58 (PB6); also elsewhere on the board
I2C1_SDA: R11.1, U4.59 (PB7); also elsewhere on the board
IMU_INT: U4.27 (PB1); also elsewhere on the board
LED0: R13.1, U4.2 (PC13)
LED1: R14.1, U4.3 (PC14)
LED2: R15.1, U4.4 (PC15)
unnamed: C16.1, R10.2, Y1.3
unnamed: D1.2 (A), R13.2
unnamed: D2.2 (A), R14.2
unnamed: D3.2 (A), R15.2
unnamed: R9.2, SW2.2 (B)
RESET_MCU: C14.1, SW1.2, U4.7 (NRST)
SDIO_CK: U4.53 (PC12); also elsewhere on the board
SDIO_CMD: U4.54 (PD2); also elsewhere on the board
SDIO_D0: U4.39 (PC8); also elsewhere on the board
SDIO_D1: U4.40 (PC9); also elsewhere on the board
SDIO_D2: U4.51 (PC10); also elsewhere on the board
SDIO_D3: U4.52 (PC11); also elsewhere on the board
SPI1_CS0: U4.24 (PC4); also elsewhere on the board
SPI1_CS1: U4.25 (PC5); also elsewhere on the board
SPI1_MISO: U4.22 (PA6); also elsewhere on the board
SPI1_MOSI: U4.23 (PA7); also elsewhere on the board
SPI1_SCK: U4.21 (PA5); also elsewhere on the board
SWCLK: U4.49 (PA14); also elsewhere on the board
SWDIO: U4.46 (PA13); also elsewhere on the board
UART1_RX: U4.43 (PA10); also elsewhere on the board
UART1_TX: U4.42 (PA9); also elsewhere on the board
UART2_RX: U4.17 (PA3); also elsewhere on the board
UART2_TX: U4.16 (PA2); also elsewhere on the board
UART3_CTS: U4.34 (PB13); also elsewhere on the board
UART3_RTS: U4.35 (PB14); also elsewhere on the board
UART3_RX: U4.30 (PB11); also elsewhere on the board
UART3_TX: U4.29 (PB10); also elsewhere on the board
UART4_RX: U4.15 (PA1); also elsewhere on the board
UART4_TX: U4.14 (PA0)
UART6_RX: U4.38 (PC7); also elsewhere on the board
UART6_TX: U4.37 (PC6); also elsewhere on the board
USB_D+: U4.45 (PA12); also elsewhere on the board
USB_D-: U4.44 (PA11); also elsewhere on the board
VCAP1_MCU: C17.1, U4.31 (VCAP_1)
VCAP2_MCU: C18.1, U4.47 (VCAP_2)

Notes on the sheet:
VCaps
HSE
LED
Reset
C1,C2=2*(CL-Cstray)
Boot jumpers
16Mhz 9pf
DEBUG: SWD USB UART1 INT: I2C1 pca9685 SPI1 mpu9250 ms5611 UART4 ibus SDIO microSD EXT: UART3 UART6 UART2 I2C1 ADC 3.3v ADC 6.6v
I2C pull-up

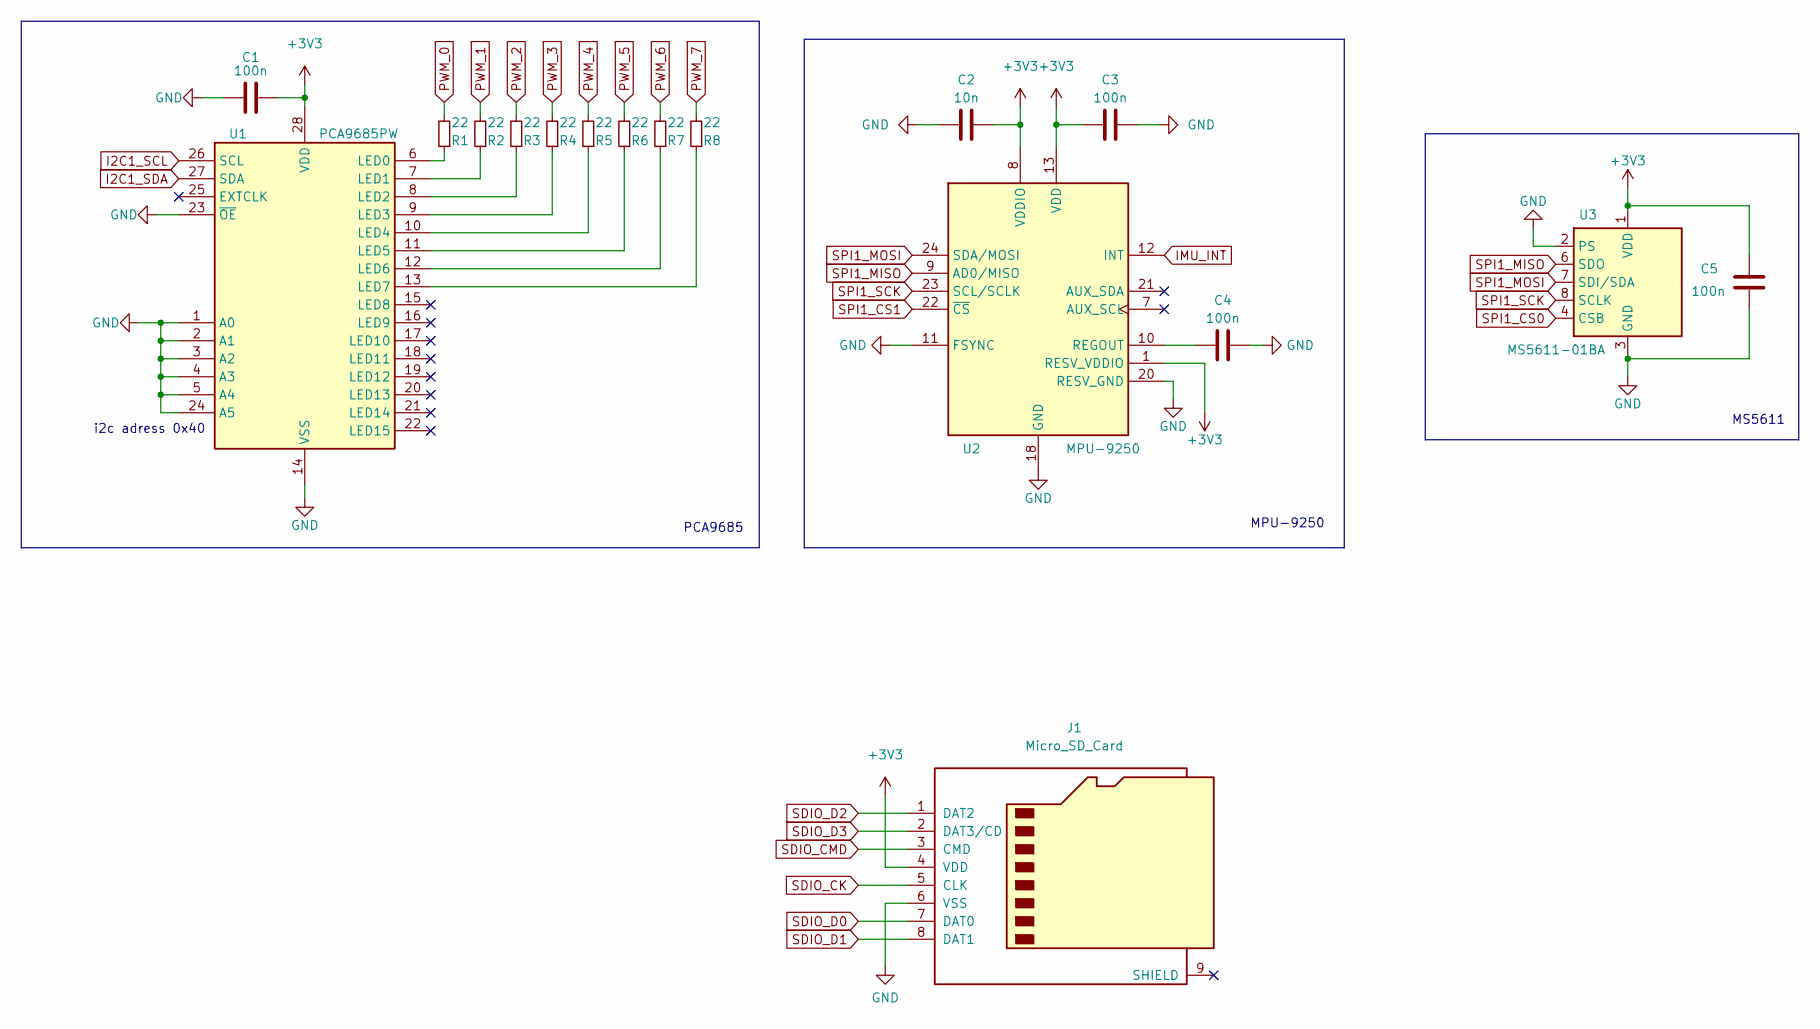
[picture p88: schematic peripherals.kicad_sch]

Parts:
C1, C3, C4, C5: 100n; C_0603_1608Metric_Pad1.08x0.95mm_HandSolder; JLCPCB Part # C14663
C2: 10n; C_0603_1608Metric_Pad1.08x0.95mm_HandSolder; JLCPCB Part # C57112
J1: Micro_SD_Card; TF15X15
R1, R2, R3, R4, R5, R6, R7, R8: 22; R_0603_1608Metric_Pad0.98x0.95mm_HandSolder; JLCPCB Part # C23345
U1: PCA9685PW; TSSOP-28_4.4x9.7mm_P0.65mm
U2: MPU-9250; InvenSense_QFN-24_3x3mm_P0.4mm
U3: MS5611-01BA; LGA-8_3x5mm_P1.25mm_handsolder

Connections:
+3V3: C1.2, C2.1, C3.1, C5.1, J1.4 (VDD), U1.28 (VDD), U2.1 (RESV_VDDIO), U2.8 (VDDIO), U2.13 (VDD), U3.1 (VDD); also elsewhere on the board
GND: C1.1, C2.2, C3.2, C4.2, C5.2, J1.6 (VSS), U1.1 (A0), U1.2 (A1), U1.3 (A2), U1.4 (A3), U1.5 (A4), U1.14 (VSS), U1.23 (~OE), U1.24 (A5), U2.11 (FSYNC), U2.18 (GND), U2.20 (RESV_GND), U3.2 (PS), U3.3 (GND); also elsewhere on the board
I2C1_SCL: U1.26 (SCL); also elsewhere on the board
I2C1_SDA: U1.27 (SDA); also elsewhere on the board
IMU_INT: U2.12 (INT); also elsewhere on the board
unnamed: C4.1, U2.10 (REGOUT)
unnamed: R1.1, U1.6 (LED0)
unnamed: R2.1, U1.7 (LED1)
unnamed: R3.1, U1.8 (LED2)
unnamed: R4.1, U1.9 (LED3)
unnamed: R5.1, U1.10 (LED4)
unnamed: R6.1, U1.11 (LED5)
unnamed: R7.1, U1.12 (LED6)
unnamed: R8.1, U1.13 (LED7)
PWM_0: R1.2; also elsewhere on the board
PWM_1: R2.2; also elsewhere on the board
PWM_2: R3.2; also elsewhere on the board
PWM_3: R4.2; also elsewhere on the board
PWM_4: R5.2; also elsewhere on the board
PWM_5: R6.2; also elsewhere on the board
PWM_6: R7.2; also elsewhere on the board
PWM_7: R8.2; also elsewhere on the board
SDIO_CK: J1.5 (CLK); also elsewhere on the board
SDIO_CMD: J1.3 (CMD); also elsewhere on the board
SDIO_D0: J1.7 (DAT0); also elsewhere on the board
SDIO_D1: J1.8 (DAT1); also elsewhere on the board
SDIO_D2: J1.1 (DAT2); also elsewhere on the board
SDIO_D3: J1.2 (DAT3/CD); also elsewhere on the board
SPI1_CS0: U3.4 (CSB), U3.5 (CSB); also elsewhere on the board
SPI1_CS1: U2.22 (~CS); also elsewhere on the board
SPI1_MISO: U2.9 (AD0/MISO), U3.6 (SDO); also elsewhere on the board
SPI1_MOSI: U2.24 (SDA/MOSI), U3.7 (SDI/SDA); also elsewhere on the board
SPI1_SCK: U2.23 (SCL/SCLK), U3.8 (SCLK); also elsewhere on the board

Notes on the sheet:
PCA9685
i2c adress 0x40
MPU-9250
MS5611

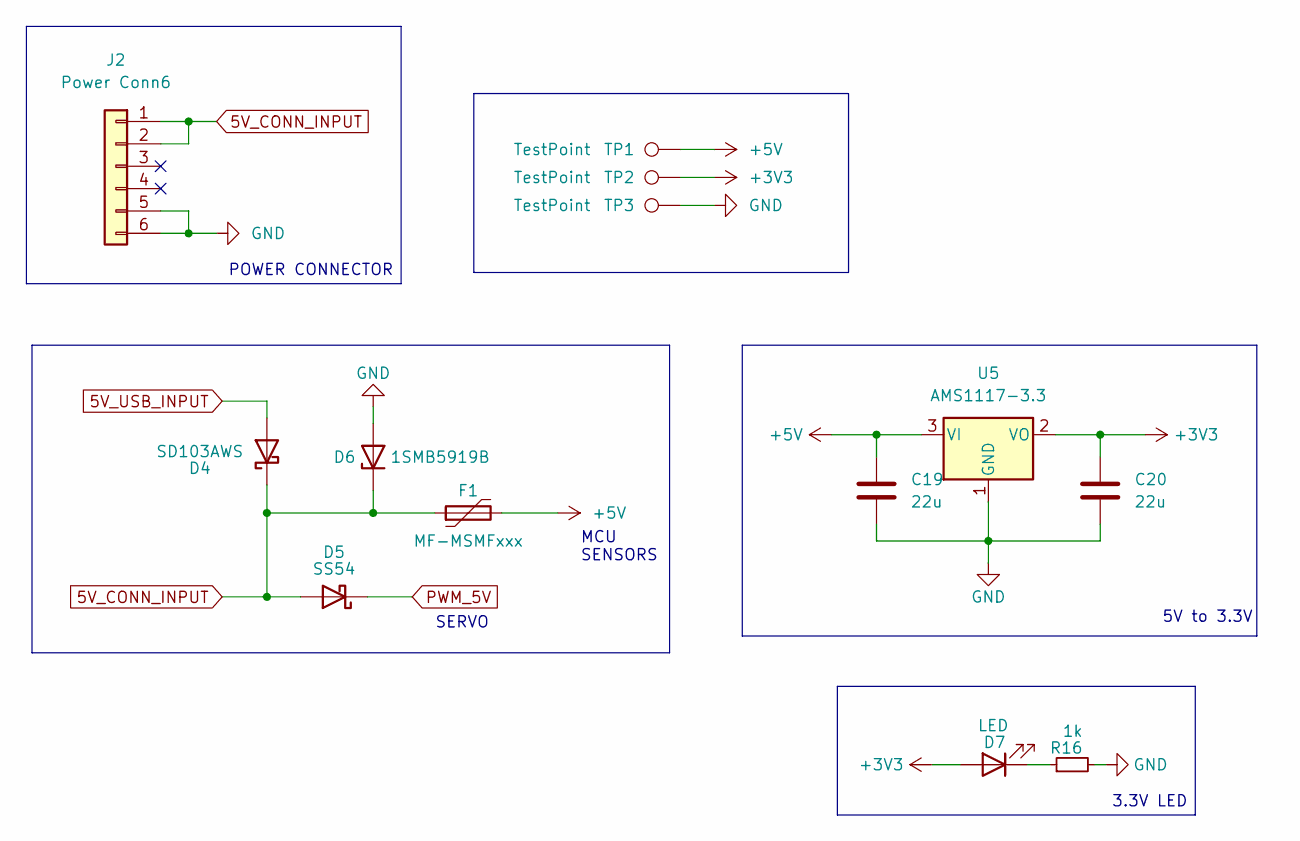
[picture p89: schematic power.kicad_sch]

Parts:
C19, C20: 22u; C_1206_3216Metric_Pad1.33x1.80mm_HandSolder; JLCPCB Part # C12891
D4: SD103AWS; D_SOD-323_HandSoldering; JLCPCB Part # C22452
D5: SS54; D_SMA; JLCPCB Part # C22452
D6: 1SMB5919B; D_SMB
D7: LED; LED_0603_1608Metric_Pad1.05x0.95mm_HandSolder
F1: MF-MSMFxxx; Fuse_1812_4532Metric_Pad1.30x3.40mm_HandSolder
J2: Power Conn6; Molex_PicoBlade_53047-0610_1x06_P1.25mm_Vertical
R16: 1k; R_0603_1608Metric_Pad0.98x0.95mm_HandSolder; JLCPCB Part # C21190
TP1, TP2, TP3: TestPoint; TestPoint_Pad_D1.5mm
U5: AMS1117-3.3; SOT-223-3_TabPin2

Connections:
5V_CONN_INPUT: D4.1 (K), D5.2 (A), D6.1 (K), F1.1, J2.1, J2.2
5V_USB_INPUT: D4.2 (A); also elsewhere on the board
+3V3: C20.1, D7.2 (A), TP2.1, U5.2 (VO); also elsewhere on the board
+5V: C19.1, F1.2, TP1.1, U5.3 (VI); also elsewhere on the board
GND: C19.2, C20.2, D6.2 (A), J2.5, J2.6, R16.2, TP3.1, U5.1 (GND); also elsewhere on the board
unnamed: D7.1 (K), R16.1
PWM_5V: D5.1 (K); also elsewhere on the board

Notes on the sheet:
POWER CONNECTOR
MCU SENSORS
3.3V LED
SERVO
5V to 3.3V

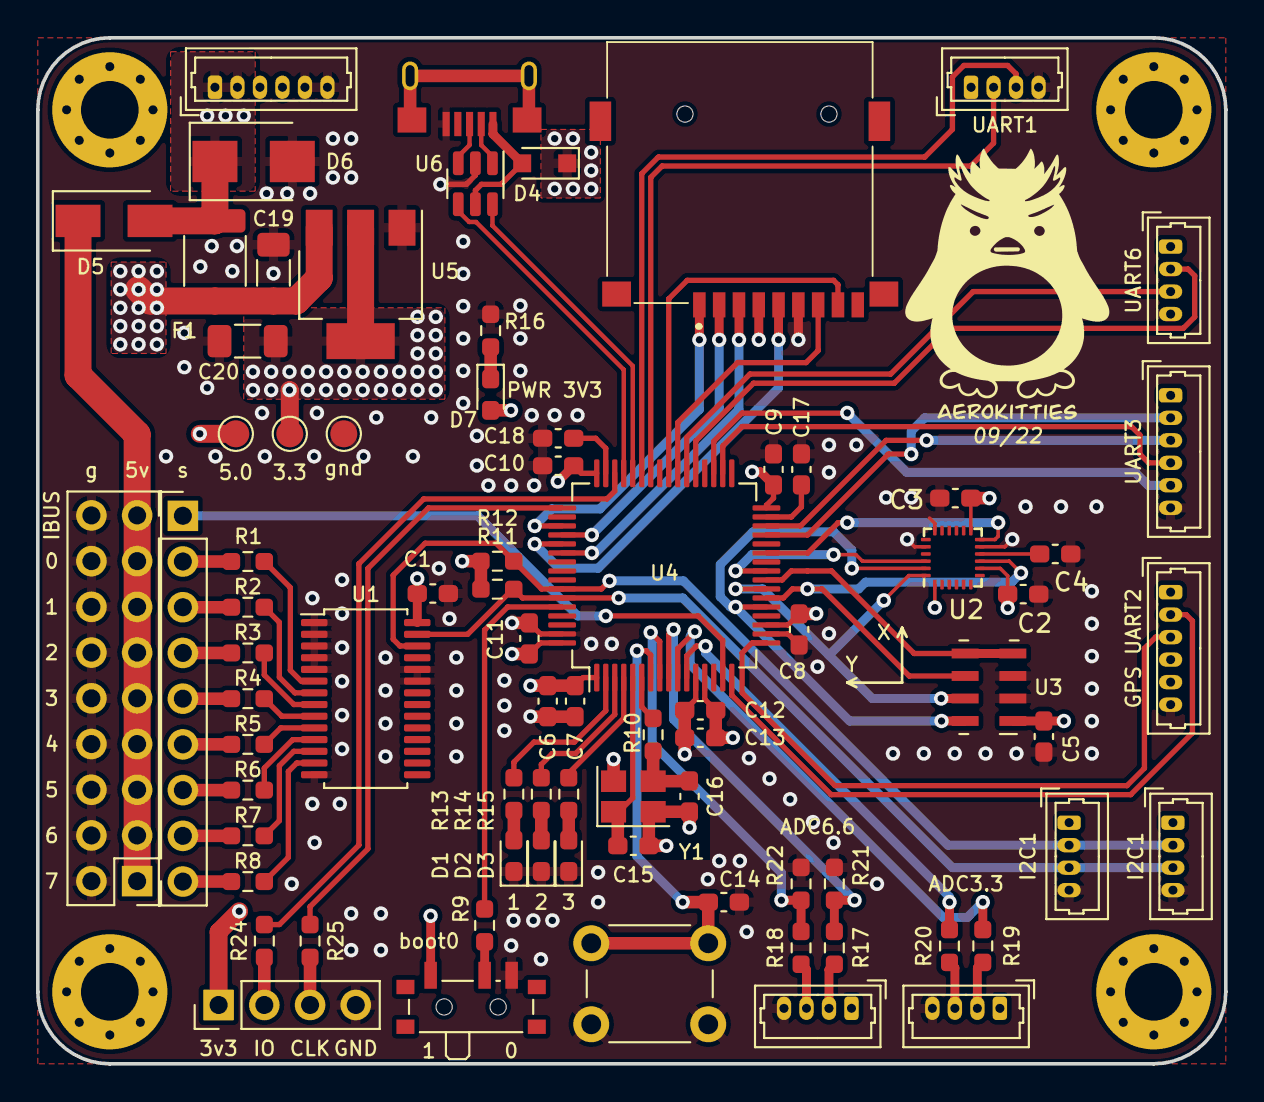
[picture p90: board FC0.kicad_pcb from above]

Board: 4 copper layers, 66.0 x 57.0 mm, 82 parts (0 on the bottom side), 79 nets.
