AeroKITties/Kitties-Hardware/Hardware/Royal Penguin/1.3/1.3.kicad_pcb

## KiCad design Hardware/Royal Penguin/1.3/1.3.kicad_pcb (2023-02-15)

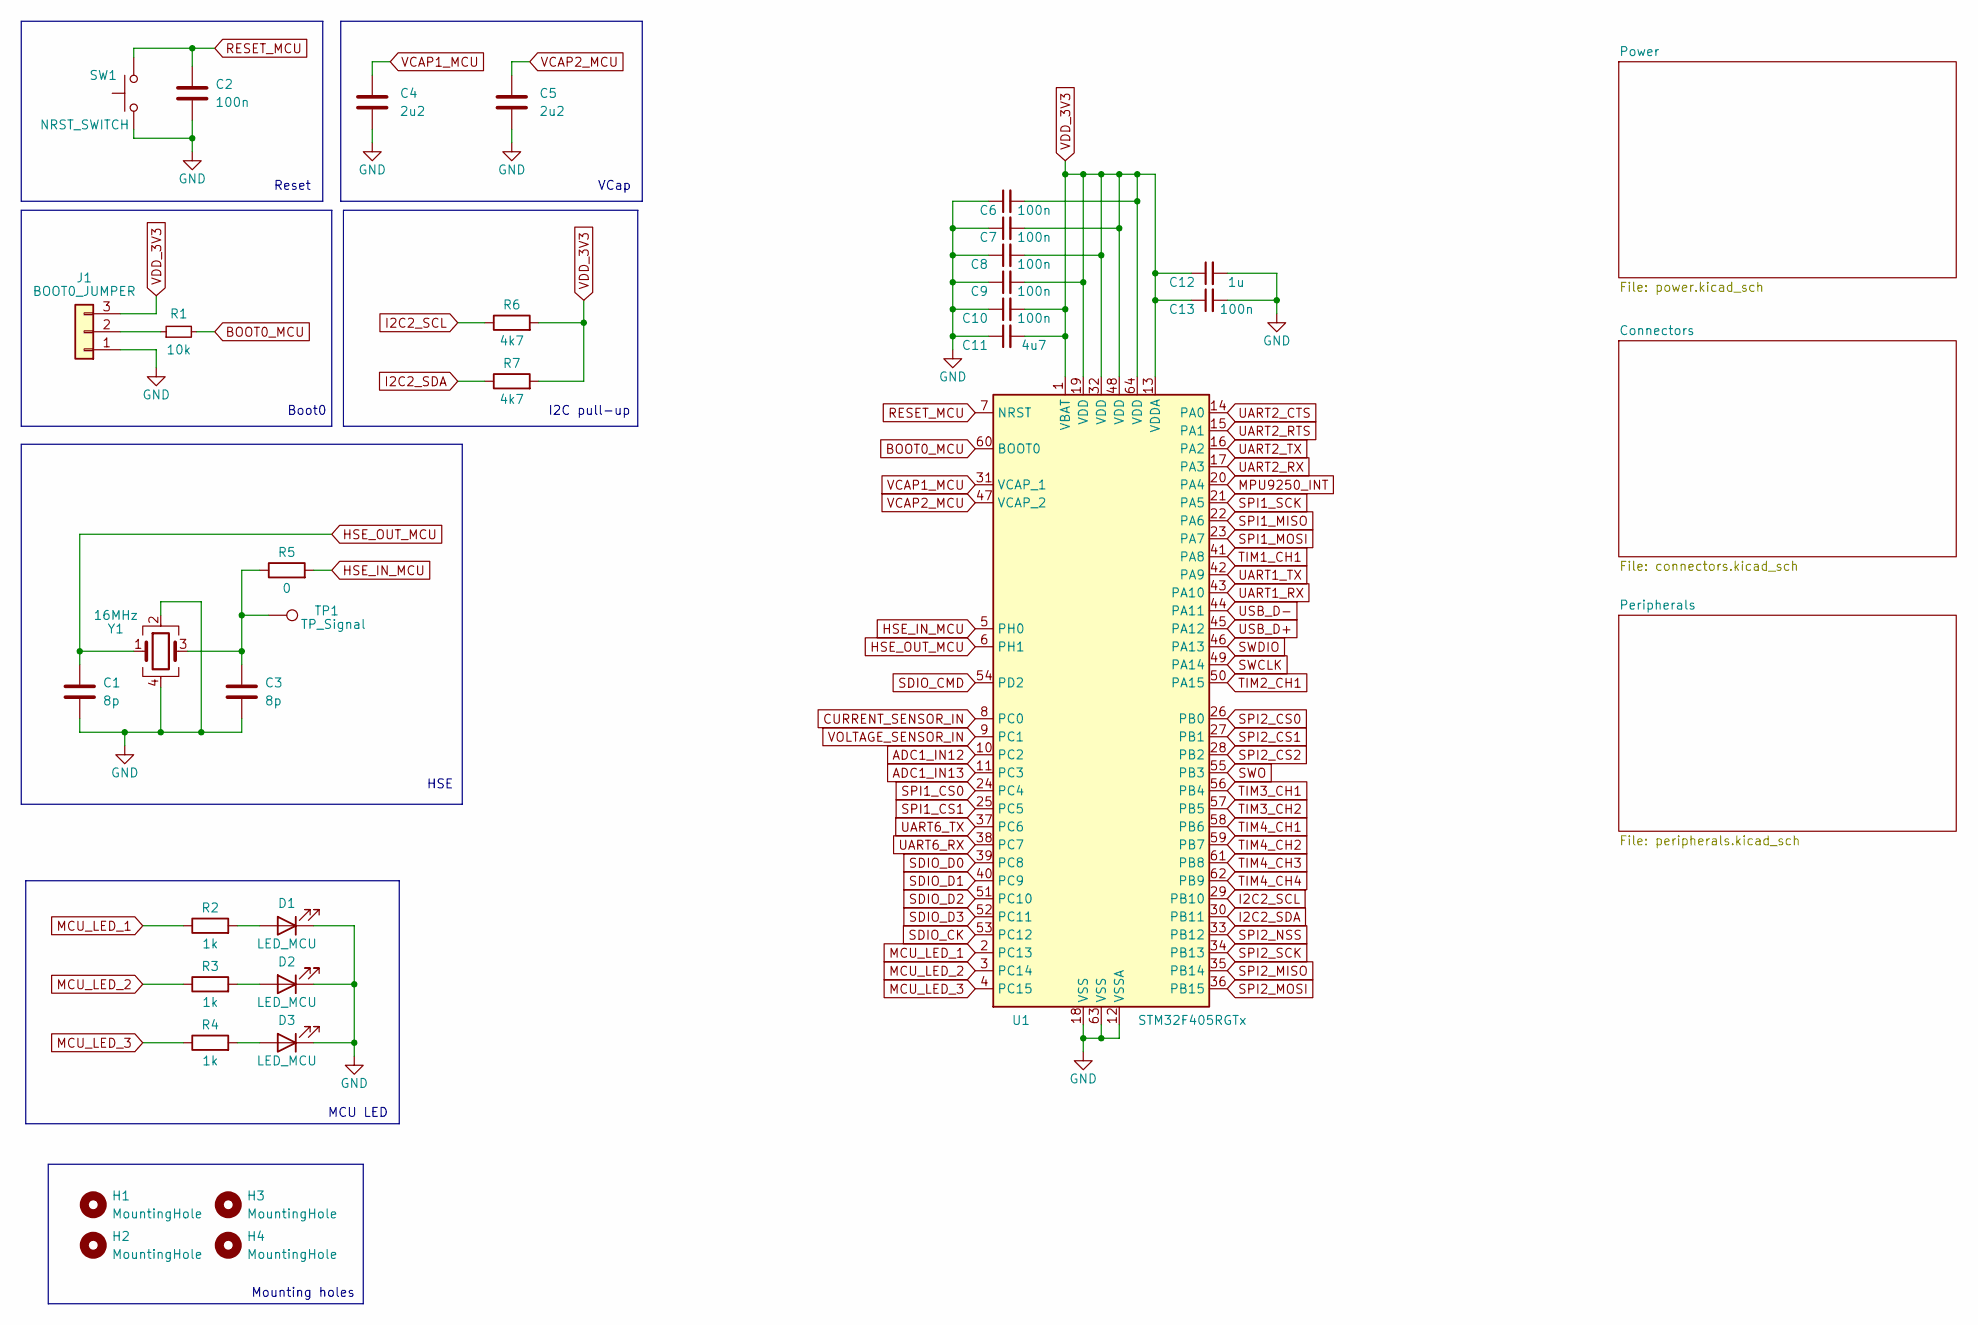
[picture p91: schematic 1.3.kicad_sch, MCU]

Parts:
C1, C3: 8p; C_0603_1608Metric_Pad1.08x0.95mm_HandSolder
C2, C6, C7, C8, C9, C10, C13: 100n; C_0603_1608Metric_Pad1.08x0.95mm_HandSolder
C4, C5: 2u2; C_0603_1608Metric_Pad1.08x0.95mm_HandSolder
C11: 4u7; C_0603_1608Metric_Pad1.08x0.95mm_HandSolder
C12: 1u; C_0603_1608Metric_Pad1.08x0.95mm_HandSolder
D1, D2, D3: LED_MCU; LED_1206_3216Metric_Pad1.42x1.75mm_HandSolder
H1, H2, H3, H4: MountingHole; MountingHole_3.2mm_M3_Pad_Via
J1: BOOT0_JUMPER; PinHeader_1x03_P2.54mm_Vertical
R1: 10k; R_0603_1608Metric_Pad0.98x0.95mm_HandSolder
R2, R3, R4: 1k; R_0603_1608Metric_Pad0.98x0.95mm_HandSolder
R5: 0; R_0603_1608Metric_Pad0.98x0.95mm_HandSolder
R6, R7: 4k7; R_0603_1608Metric_Pad0.98x0.95mm_HandSolder
SW1: NRST_SWITCH; SW_PUSH_6mm_H5mm
TP1: TP_Signal; TestPoint_Pad_D1.0mm
U1: STM32F405RGTx; LQFP-64_10x10mm_P0.5mm
Y1: 16MHz; Crystal_SMD_3225-4Pin_3.2x2.5mm

Connections:
ADC1_IN12: U1.10 (PC2); also elsewhere on the board
ADC1_IN13: U1.11 (PC3); also elsewhere on the board
BOOT0_MCU: R1.2, U1.60 (BOOT0)
CURRENT_SENSOR_IN: U1.8 (PC0); also elsewhere on the board
GND: C1.2, C2.2, C3.2, C4.2, C5.2, C6.1, C7.1, C8.1, C9.1, C10.1, C11.1, C12.2, C13.2, D1.1 (K), D2.1 (K), D3.1 (K), J1.1, SW1.1, U1.12 (VSSA), U1.18 (VSS), U1.63 (VSS), Y1.2, Y1.4; also elsewhere on the board
HSE_IN_MCU: R5.2, U1.5 (PH0)
HSE_OUT_MCU: C1.1, U1.6 (PH1), Y1.1
I2C2_SCL: R6.1, U1.29 (PB10); also elsewhere on the board
I2C2_SDA: R7.1, U1.30 (PB11); also elsewhere on the board
MCU_LED_1: R2.1, U1.2 (PC13)
MCU_LED_2: R3.1, U1.3 (PC14)
MCU_LED_3: R4.1, U1.4 (PC15)
MPU9250_INT: U1.20 (PA4); also elsewhere on the board
unnamed: C3.1, R5.1, TP1.1, Y1.3
unnamed: D1.2 (A), R2.2
unnamed: D2.2 (A), R3.2
unnamed: D3.2 (A), R4.2
unnamed: J1.2, R1.1
RESET_MCU: C2.1, SW1.2, U1.7 (NRST)
SDIO_CK: U1.53 (PC12); also elsewhere on the board
SDIO_CMD: U1.54 (PD2); also elsewhere on the board
SDIO_D0: U1.39 (PC8); also elsewhere on the board
SDIO_D1: U1.40 (PC9); also elsewhere on the board
SDIO_D2: U1.51 (PC10); also elsewhere on the board
SDIO_D3: U1.52 (PC11); also elsewhere on the board
SPI1_CS0: U1.24 (PC4); also elsewhere on the board
SPI1_CS1: U1.25 (PC5); also elsewhere on the board
SPI1_MISO: U1.22 (PA6); also elsewhere on the board
SPI1_MOSI: U1.23 (PA7); also elsewhere on the board
SPI1_SCK: U1.21 (PA5); also elsewhere on the board
SPI2_CS0: U1.26 (PB0); also elsewhere on the board
SPI2_CS1: U1.27 (PB1); also elsewhere on the board
SPI2_CS2: U1.28 (PB2); also elsewhere on the board
SPI2_MISO: U1.35 (PB14); also elsewhere on the board
SPI2_MOSI: U1.36 (PB15); also elsewhere on the board
SPI2_NSS: U1.33 (PB12); also elsewhere on the board
SPI2_SCK: U1.34 (PB13); also elsewhere on the board
SWCLK: U1.49 (PA14); also elsewhere on the board
SWDIO: U1.46 (PA13); also elsewhere on the board
SWO: U1.55 (PB3); also elsewhere on the board
TIM1_CH1: U1.41 (PA8); also elsewhere on the board
TIM2_CH1: U1.50 (PA15); also elsewhere on the board
TIM3_CH1: U1.56 (PB4); also elsewhere on the board
TIM3_CH2: U1.57 (PB5); also elsewhere on the board
TIM4_CH1: U1.58 (PB6); also elsewhere on the board
TIM4_CH2: U1.59 (PB7); also elsewhere on the board
TIM4_CH3: U1.61 (PB8); also elsewhere on the board
TIM4_CH4: U1.62 (PB9); also elsewhere on the board
UART1_RX: U1.43 (PA10); also elsewhere on the board
UART1_TX: U1.42 (PA9); also elsewhere on the board
UART2_CTS: U1.14 (PA0); also elsewhere on the board
UART2_RTS: U1.15 (PA1); also elsewhere on the board
UART2_RX: U1.17 (PA3); also elsewhere on the board
UART2_TX: U1.16 (PA2); also elsewhere on the board
UART6_RX: U1.38 (PC7); also elsewhere on the board
UART6_TX: U1.37 (PC6); also elsewhere on the board
USB_D+: U1.45 (PA12); also elsewhere on the board
USB_D-: U1.44 (PA11); also elsewhere on the board
VCAP1_MCU: C4.1, U1.31 (VCAP_1)
VCAP2_MCU: C5.1, U1.47 (VCAP_2)
VDD_3V3: C6.2, C7.2, C8.2, C9.2, C10.2, C11.2, C12.1, C13.1, J1.3, R6.2, R7.2, U1.1 (VBAT), U1.13 (VDDA), U1.19 (VDD), U1.32 (VDD), U1.48 (VDD), U1.64 (VDD); also elsewhere on the board
VOLTAGE_SENSOR_IN: U1.9 (PC1); also elsewhere on the board

Notes on the sheet:
HSE
VCap
I2C pull-up
Reset
MCU LED
Mounting holes
Boot0

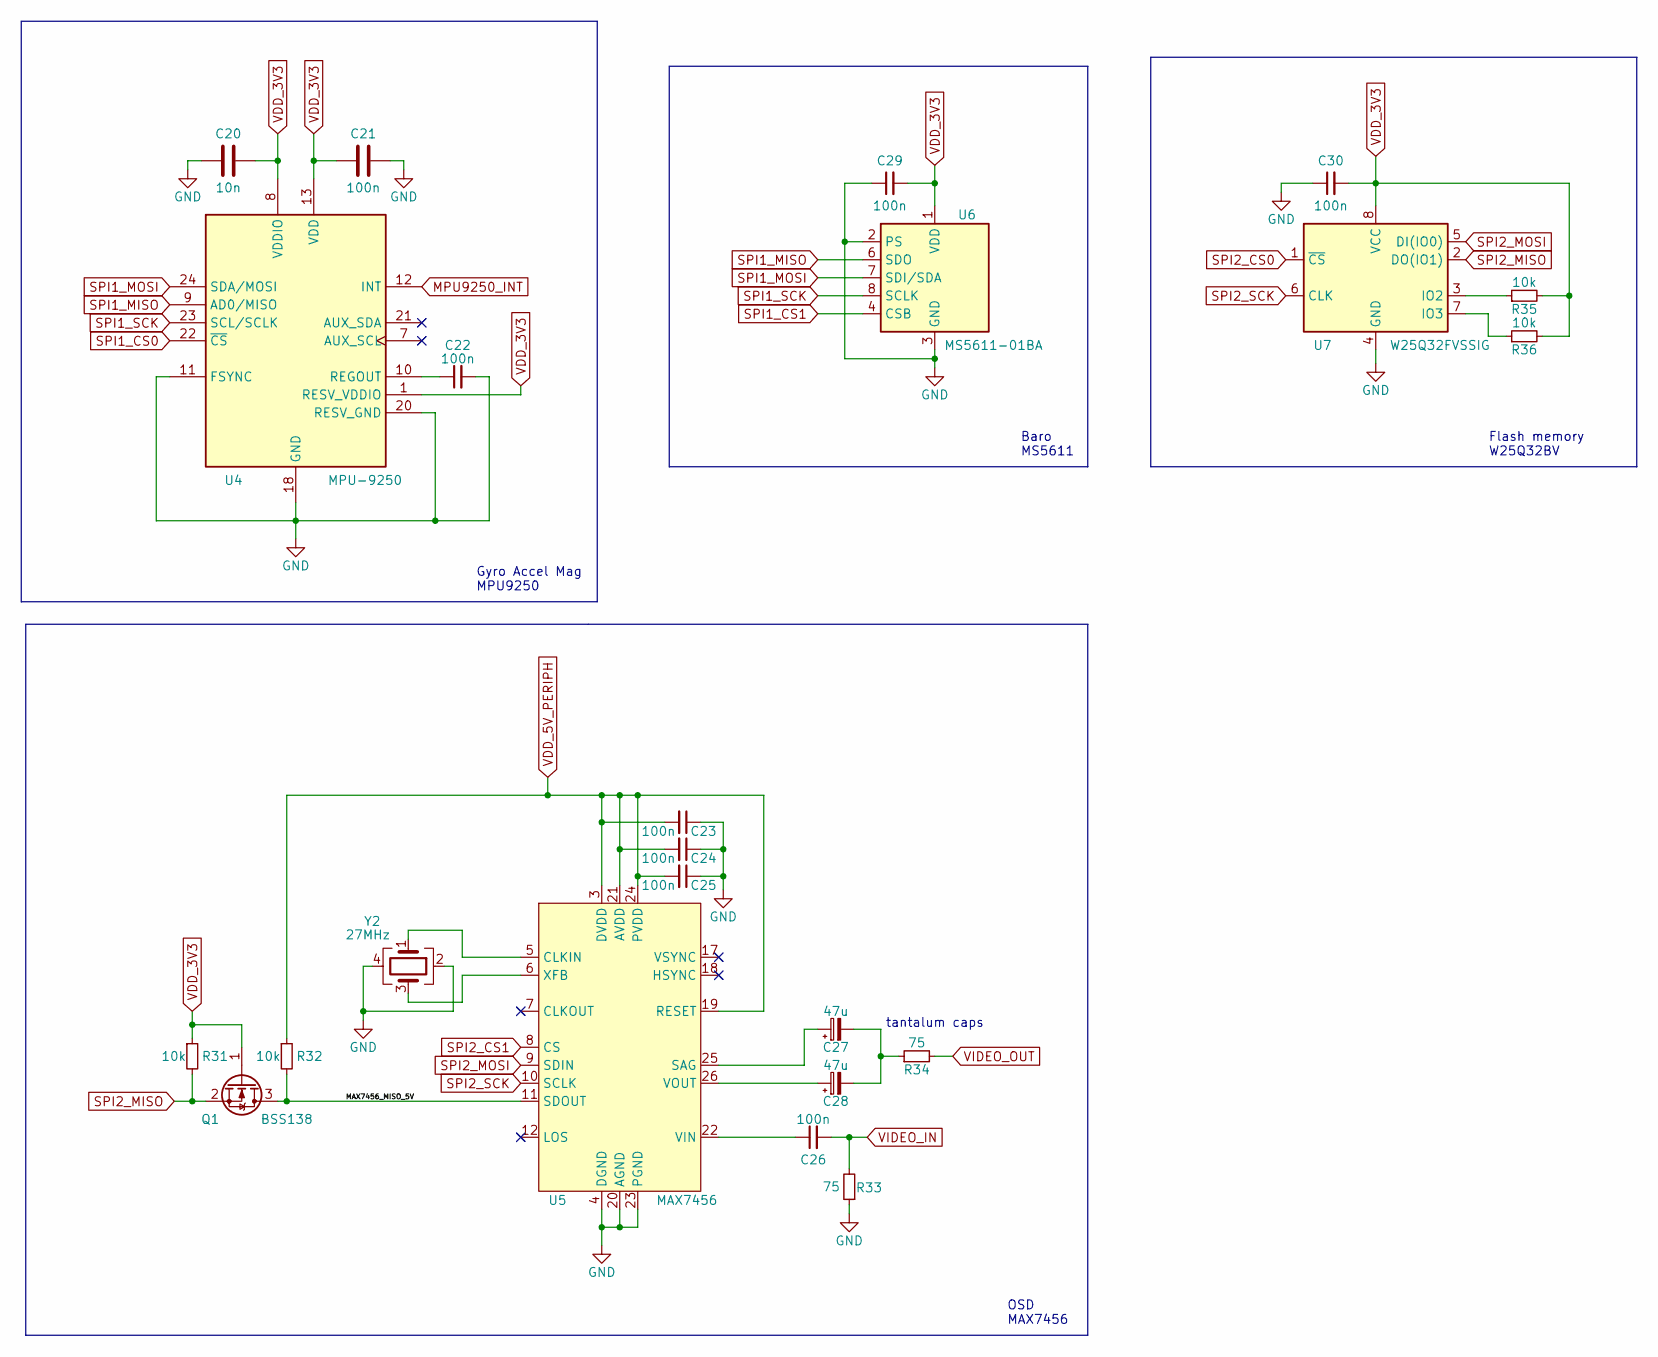
[picture p92: schematic peripherals.kicad_sch]

Parts:
C20: 10n; C_0603_1608Metric_Pad1.08x0.95mm_HandSolder
C21, C22, C23, C24, C25, C26, C29, C30: 100n; C_0603_1608Metric_Pad1.08x0.95mm_HandSolder
C27, C28: 47u; C_1206_3216Metric_Pad1.33x1.80mm_HandSolder
Q1: BSS138; SOT-23
R31, R32, R35, R36: 10k; R_0603_1608Metric_Pad0.98x0.95mm_HandSolder
R33, R34: 75; R_0603_1608Metric_Pad0.98x0.95mm_HandSolder
U4: MPU-9250; InvenSense_QFN-24_3x3mm_P0.4mm
U5: MAX7456; HTSSOP-28-1EP_4.4x9.7mm_P0.65mm_EP2.85x5.4mm_ThermalVias
U6: MS5611-01BA; LGA-8_3x5mm_P1.25mm_handsolder
U7: W25Q32FVSSIG; SOIC-8_5.275x5.275mm_P1.27mm
Y2: 27MHz; Crystal_SMD_3225-4Pin_3.2x2.5mm

Connections:
/Peripherals/MAX7456_MISO_5V: Q1.3 (D), R32.2, U5.11 (SDOUT)
GND: C20.1, C21.2, C22.2, C23.1, C24.1, C25.1, C29.1, C30.1, R33.1, U4.11 (FSYNC), U4.18 (GND), U4.20 (RESV_GND), U5.4 (DGND), U5.20 (AGND), U5.23 (PGND), U6.2 (PS), U6.3 (GND), U7.4 (GND), Y2.2, Y2.4; also elsewhere on the board
MPU9250_INT: U4.12 (INT); also elsewhere on the board
unnamed: C22.1, U4.10 (REGOUT)
unnamed: C26.1, U5.22 (VIN)
unnamed: C27.1, U5.25 (SAG)
unnamed: C27.2, C28.2, R34.1
unnamed: C28.1, U5.26 (VOUT)
unnamed: R35.1, U7.3 (IO2)
unnamed: R36.1, U7.7 (IO3)
unnamed: U5.5 (CLKIN), Y2.1
unnamed: U5.6 (XFB), Y2.3
SPI1_CS0: U4.22 (~CS); also elsewhere on the board
SPI1_CS1: U6.4 (CSB), U6.5 (CSB); also elsewhere on the board
SPI1_MISO: U4.9 (AD0/MISO), U6.6 (SDO); also elsewhere on the board
SPI1_MOSI: U4.24 (SDA/MOSI), U6.7 (SDI/SDA); also elsewhere on the board
SPI1_SCK: U4.23 (SCL/SCLK), U6.8 (SCLK); also elsewhere on the board
SPI2_CS0: U7.1 (~CS); also elsewhere on the board
SPI2_CS1: U5.8 (CS); also elsewhere on the board
SPI2_MISO: Q1.2 (S), R31.2, U7.2 (DO(IO1)); also elsewhere on the board
SPI2_MOSI: U5.9 (SDIN), U7.5 (DI(IO0)); also elsewhere on the board
SPI2_SCK: U5.10 (SCLK), U7.6 (CLK); also elsewhere on the board
VDD_3V3: C20.2, C21.1, C29.2, C30.2, Q1.1 (G), R31.1, R35.2, R36.2, U4.1 (RESV_VDDIO), U4.8 (VDDIO), U4.13 (VDD), U6.1 (VDD), U7.8 (VCC); also elsewhere on the board
VDD_5V_PERIPH: C23.2, C24.2, C25.2, R32.1, U5.3 (DVDD), U5.19 (RESET), U5.21 (AVDD), U5.24 (PVDD); also elsewhere on the board
VIDEO_IN: C26.2, R33.2; also elsewhere on the board
VIDEO_OUT: R34.2; also elsewhere on the board

Notes on the sheet:
Flash memory W25Q32BV
Gyro Accel Mag MPU9250
OSD MAX7456
Baro MS5611
tantalum caps

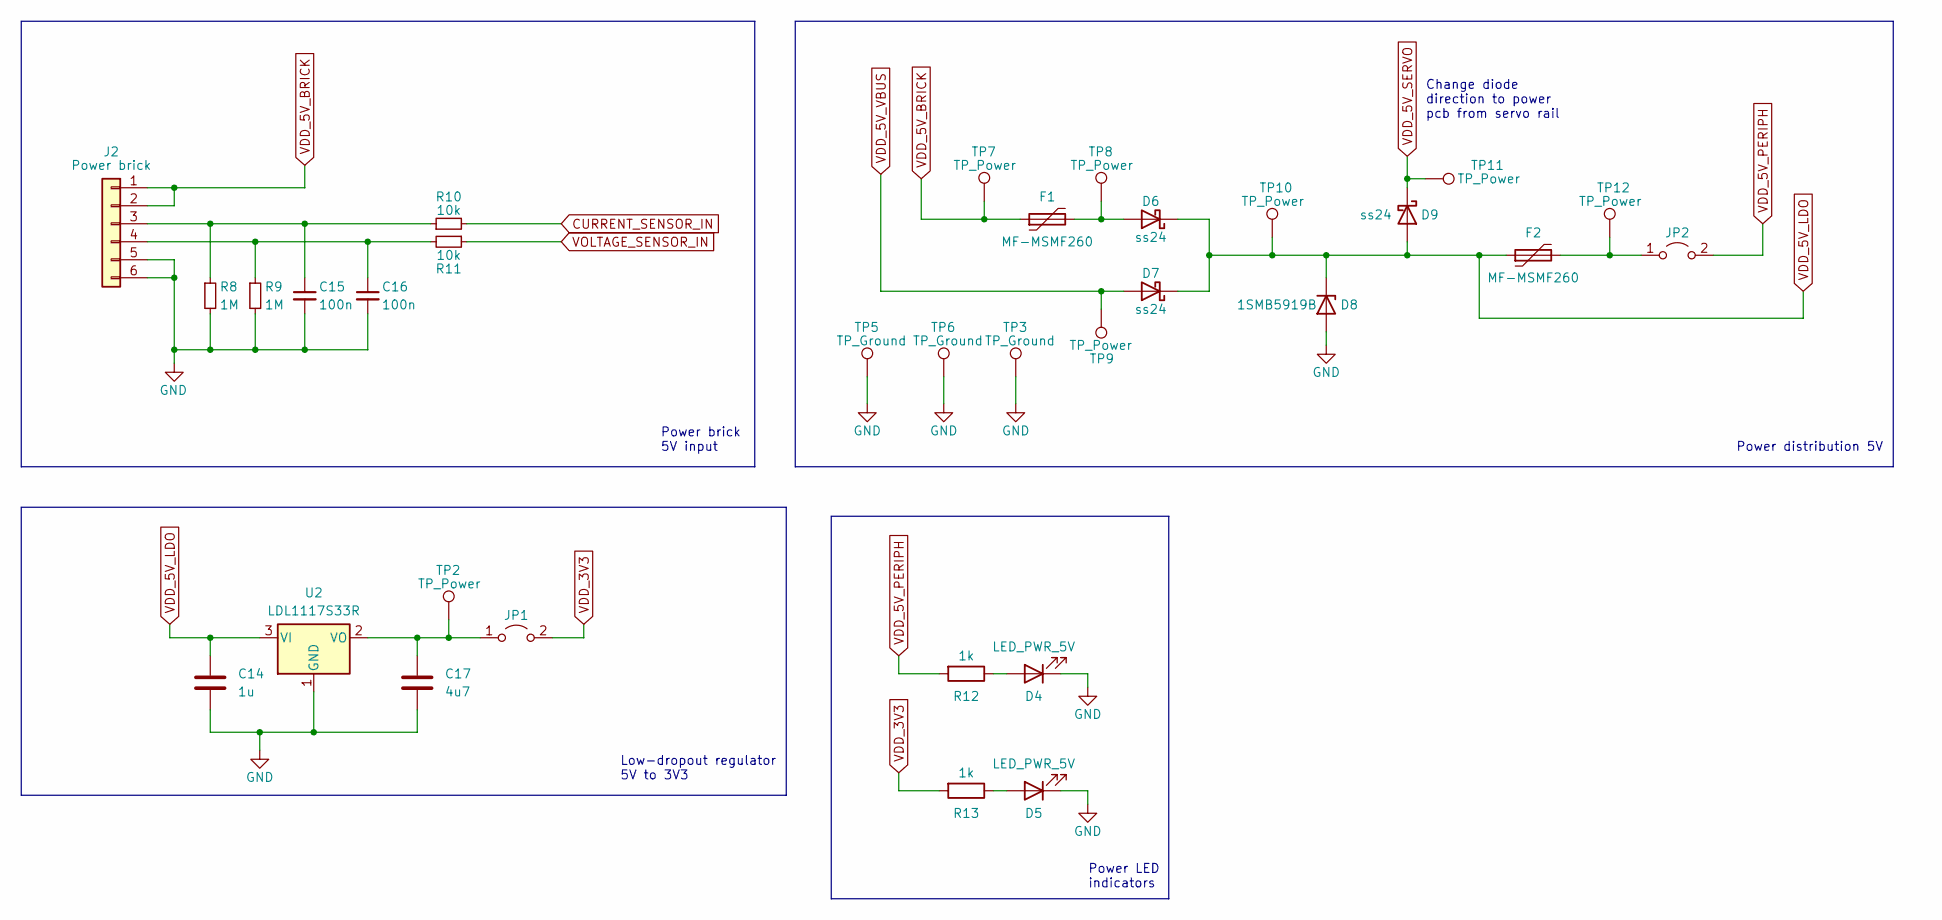
[picture p93: schematic power.kicad_sch]

Parts:
C14: 1u; C_0805_2012Metric_Pad1.18x1.45mm_HandSolder
C15, C16: 100n; C_0603_1608Metric_Pad1.08x0.95mm_HandSolder
C17: 4u7; C_0805_2012Metric_Pad1.18x1.45mm_HandSolder
D4, D5: LED_PWR_5V; LED_1206_3216Metric_Pad1.42x1.75mm_HandSolder
D6, D7, D9: ss24; D_SMB
D8: 1SMB5919B; D_SMB
F1, F2: MF-MSMF260; Fuse_1812_4532Metric_Pad1.30x3.40mm_HandSolder
J2: Power brick; Molex_PicoBlade_53047-0610_1x06_P1.25mm_Vertical
JP1, JP2: Jumper_power; PinHeader_1x02_P2.54mm_Vertical
R8, R9: 1M; R_0603_1608Metric_Pad0.98x0.95mm_HandSolder
R10, R11: 10k; R_0603_1608Metric_Pad0.98x0.95mm_HandSolder
R12, R13: 1k; R_0603_1608Metric_Pad0.98x0.95mm_HandSolder
TP2, TP7, TP8, TP9, TP10, TP11, TP12: TP_Power; TestPoint_Pad_D1.0mm
TP3, TP5, TP6: TP_Ground; TestPoint_Pad_D1.0mm
U2: LDL1117S33R; SOT-223-3_TabPin2

Connections:
CURRENT_SENSOR_IN: R10.2; also elsewhere on the board
GND: C14.2, C15.2, C16.2, C17.2, D4.1 (K), D5.1 (K), D8.2 (A), J2.5, J2.6, R8.2, R9.2, TP3.1, TP5.1, TP6.1, U2.1 (GND); also elsewhere on the board
unnamed: C15.1, J2.3, R8.1, R10.1
unnamed: C16.1, J2.4, R9.1, R11.2
unnamed: C17.1, JP1.1 (A), TP2.1, U2.2 (VO)
unnamed: D4.2 (A), R12.1
unnamed: D5.2 (A), R13.1
unnamed: D6.2 (A), F1.2, TP8.1
unnamed: F2.2, JP2.1 (A), TP12.1
VDD_3V3: JP1.2 (B), R13.2; also elsewhere on the board
VDD_5V_BRICK: F1.1, J2.1, J2.2, TP7.1
VDD_5V_LDO: C14.1, D6.1 (K), D7.1 (K), D8.1 (K), D9.2 (A), F2.1, TP10.1, U2.3 (VI)
VDD_5V_PERIPH: JP2.2 (B), R12.2; also elsewhere on the board
VDD_5V_SERVO: D9.1 (K), TP11.1; also elsewhere on the board
VDD_5V_VBUS: D7.2 (A), TP9.1; also elsewhere on the board
VOLTAGE_SENSOR_IN: R11.1; also elsewhere on the board

Notes on the sheet:
Power LED indicators
Power brick 5V input
Change diode direction to power pcb from servo rail
Power distribution 5V
Low-dropout regulator 5V to 3V3

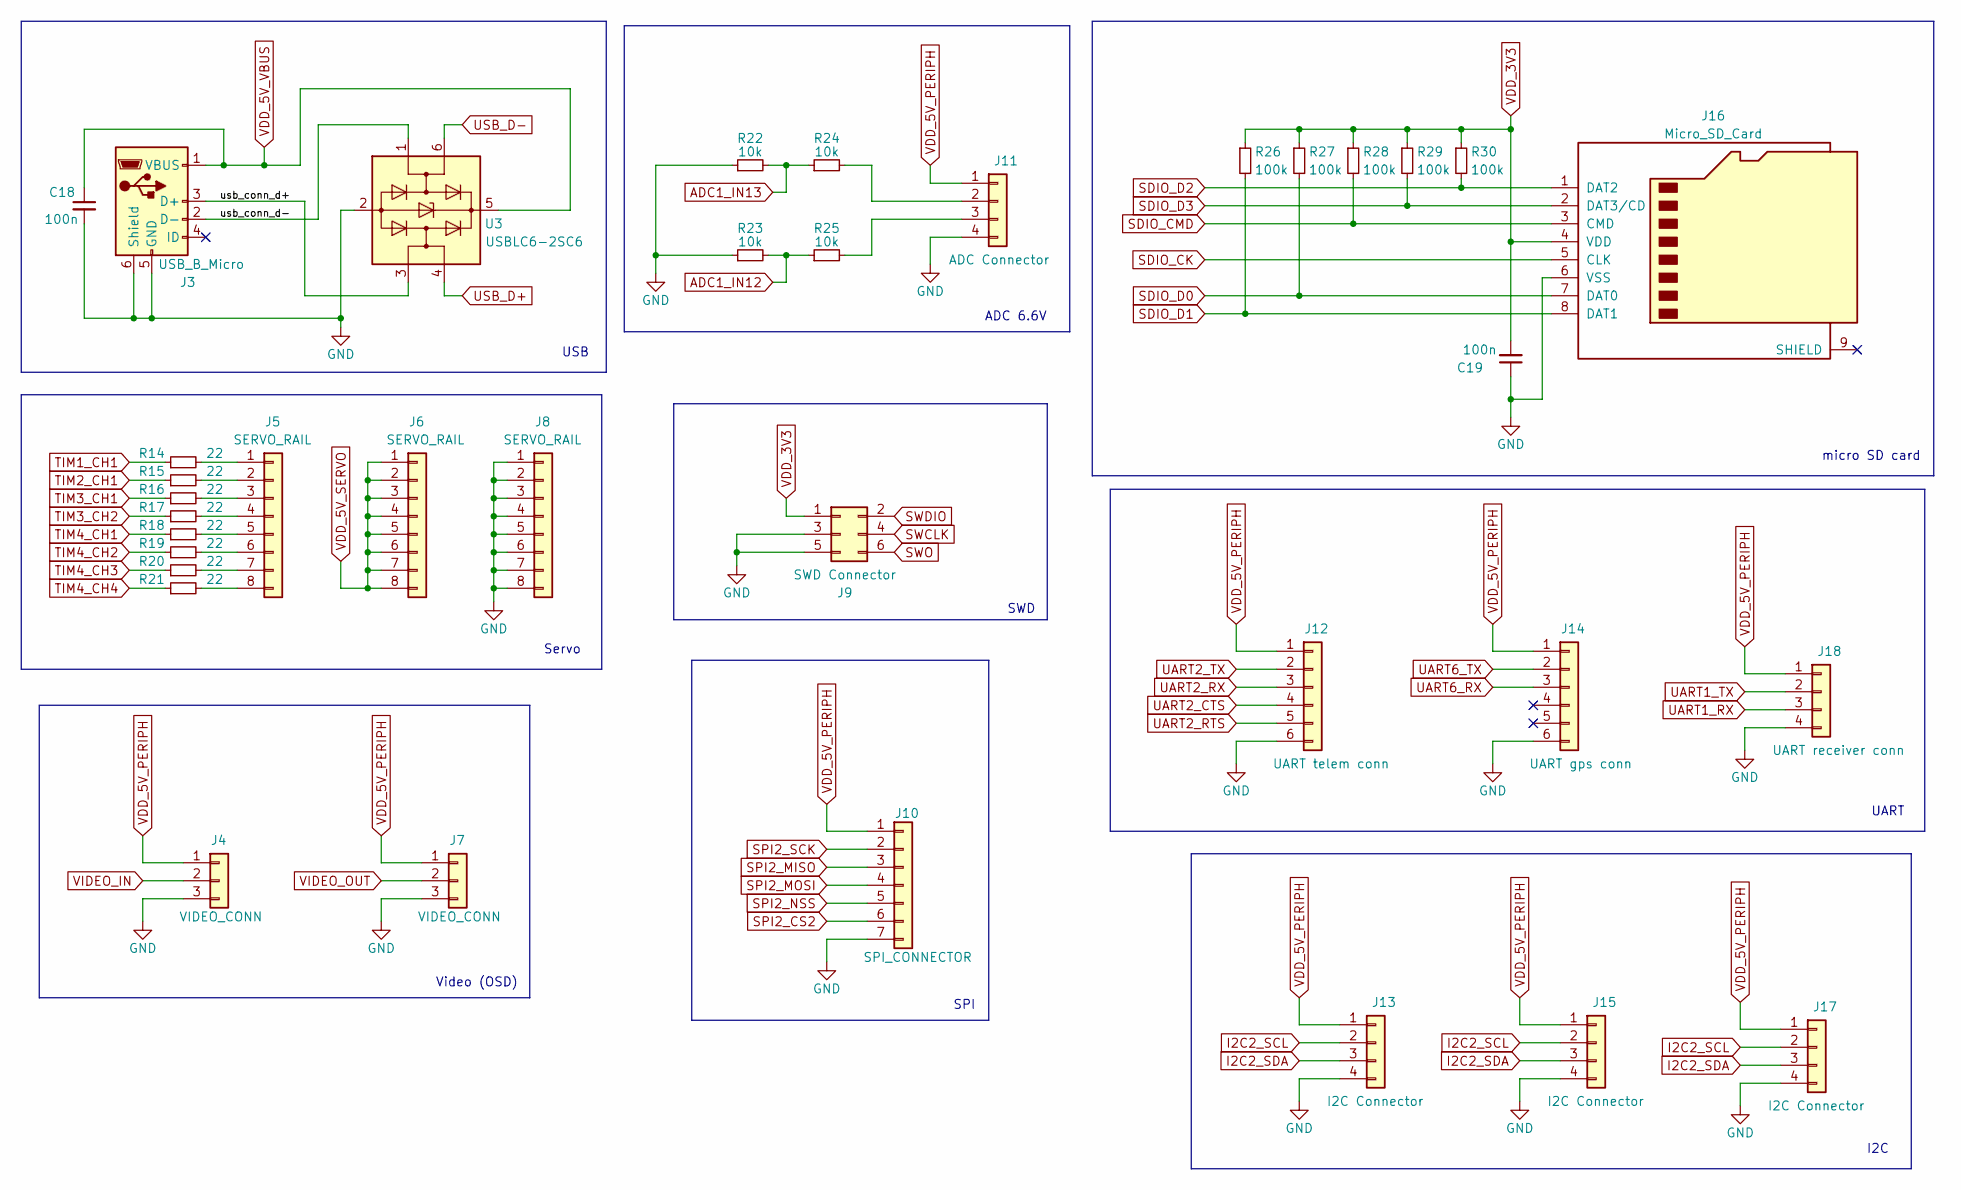
[picture p94: schematic connectors.kicad_sch]

Parts:
C18, C19: 100n; C_0603_1608Metric_Pad1.08x0.95mm_HandSolder
J3: USB_B_Micro; USB_MICRO NIUEWISX
J4, J7: VIDEO_CONN; Molex_PicoBlade_53047-0310_1x03_P1.25mm_Vertical
J5, J6, J8: SERVO_RAIL; PinHeader_1x08_P2.54mm_Vertical
J9: SWD Connector; PinHeader_2x03_P2.54mm_Vertical
J10: SPI_CONNECTOR; Molex_PicoBlade_53047-0710_1x07_P1.25mm_Vertical
J11: ADC Connector; Molex_PicoBlade_53047-0410_1x04_P1.25mm_Vertical
J12: UART telem conn; Molex_PicoBlade_53047-0610_1x06_P1.25mm_Vertical
J13, J15, J17: I2C Connector; Molex_PicoBlade_53047-0410_1x04_P1.25mm_Vertical
J14: UART gps conn; Molex_PicoBlade_53047-0610_1x06_P1.25mm_Vertical
J16: Micro_SD_Card; TF15X15
J18: UART receiver conn; Molex_PicoBlade_53047-0410_1x04_P1.25mm_Vertical
R14, R15, R16, R17, R18, R19, R20, R21: 22; R_0603_1608Metric_Pad0.98x0.95mm_HandSolder
R22, R23, R24, R25: 10k; R_0603_1608Metric_Pad0.98x0.95mm_HandSolder
R26, R27, R28, R29, R30: 100k; R_0603_1608Metric_Pad0.98x0.95mm_HandSolder
U3: USBLC6-2SC6; SOT-23-6_Handsoldering

Connections:
/Connectors/usb_conn_d+: J3.3 (D+), U3.3 (I/O2)
/Connectors/usb_conn_d-: J3.2 (D-), U3.1 (I/O1)
ADC1_IN12: R23.2, R25.1; also elsewhere on the board
ADC1_IN13: R22.2, R24.1; also elsewhere on the board
GND: C18.2, C19.1, J3.5 (GND), J3.6 (Shield), J4.3, J7.3, J8.1, J8.2, J8.3, J8.4, J8.5, J8.6, J8.7, J8.8, J9.3, J9.5, J10.7, J11.4, J12.6, J13.4, J14.6, J15.4, J16.6 (VSS), J16.MP1, J16.MP2, J16.MP3, J16.MP4, J17.4, J18.4, R22.1, R23.1, U3.2 (GND); also elsewhere on the board
I2C2_SCL: J13.2, J15.2, J17.2; also elsewhere on the board
I2C2_SDA: J13.3, J15.3, J17.3; also elsewhere on the board
unnamed: J5.1, R14.2
unnamed: J5.2, R15.2
unnamed: J5.3, R16.2
unnamed: J5.4, R17.2
unnamed: J5.5, R18.2
unnamed: J5.6, R19.2
unnamed: J5.7, R20.2
unnamed: J5.8, R21.2
unnamed: J11.2, R24.2
unnamed: J11.3, R25.2
SDIO_CK: J16.5 (CLK); also elsewhere on the board
SDIO_CMD: J16.3 (CMD), R28.2; also elsewhere on the board
SDIO_D0: J16.7 (DAT0), R27.2; also elsewhere on the board
SDIO_D1: J16.8 (DAT1), R26.2; also elsewhere on the board
SDIO_D2: J16.1 (DAT2), R30.2; also elsewhere on the board
SDIO_D3: J16.2 (DAT3/CD), R29.2; also elsewhere on the board
SPI2_CS2: J10.6; also elsewhere on the board
SPI2_MISO: J10.3; also elsewhere on the board
SPI2_MOSI: J10.4; also elsewhere on the board
SPI2_NSS: J10.5; also elsewhere on the board
SPI2_SCK: J10.2; also elsewhere on the board
SWCLK: J9.4; also elsewhere on the board
SWDIO: J9.2; also elsewhere on the board
SWO: J9.6; also elsewhere on the board
TIM1_CH1: R14.1; also elsewhere on the board
TIM2_CH1: R15.1; also elsewhere on the board
TIM3_CH1: R16.1; also elsewhere on the board
TIM3_CH2: R17.1; also elsewhere on the board
TIM4_CH1: R18.1; also elsewhere on the board
TIM4_CH2: R19.1; also elsewhere on the board
TIM4_CH3: R20.1; also elsewhere on the board
TIM4_CH4: R21.1; also elsewhere on the board
UART1_RX: J18.3; also elsewhere on the board
UART1_TX: J18.2; also elsewhere on the board
UART2_CTS: J12.4; also elsewhere on the board
UART2_RTS: J12.5; also elsewhere on the board
UART2_RX: J12.3; also elsewhere on the board
UART2_TX: J12.2; also elsewhere on the board
UART6_RX: J14.3; also elsewhere on the board
UART6_TX: J14.2; also elsewhere on the board
USB_D+: U3.4 (I/O2); also elsewhere on the board
USB_D-: U3.6 (I/O1); also elsewhere on the board
VDD_3V3: C19.2, J9.1, J16.4 (VDD), R26.1, R27.1, R28.1, R29.1, R30.1; also elsewhere on the board
VDD_5V_PERIPH: J4.1, J7.1, J10.1, J11.1, J12.1, J13.1, J14.1, J15.1, J17.1, J18.1; also elsewhere on the board
VDD_5V_SERVO: J6.1, J6.2, J6.3, J6.4, J6.5, J6.6, J6.7, J6.8; also elsewhere on the board
VDD_5V_VBUS: C18.1, J3.1 (VBUS), U3.5 (VBUS); also elsewhere on the board
VIDEO_IN: J4.2; also elsewhere on the board
VIDEO_OUT: J7.2; also elsewhere on the board

Notes on the sheet:
UART
Video (OSD)
micro SD card
USB
Servo
SWD
ADC 6.6V
SPI
I2C

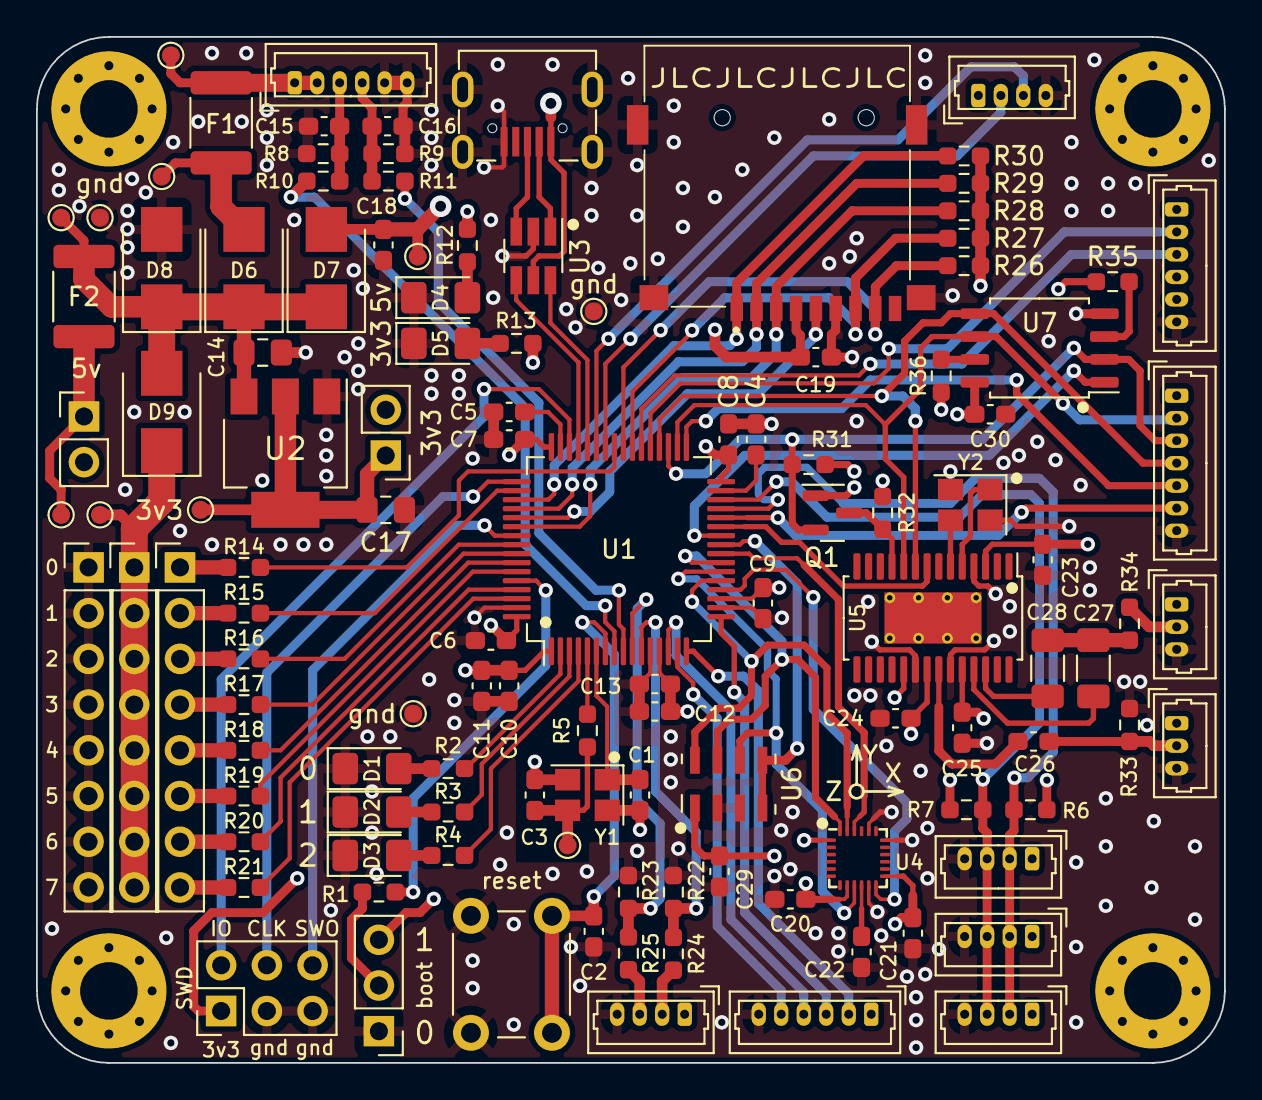
[picture p95: board 1.3.kicad_pcb from above]

Board: 4 copper layers, 66.0 x 57.0 mm, 123 parts (0 on the bottom side), 98 nets.
