AeroKITties/Kitties-Hardware/Hardware/Royal Penguin/2.0/2.0.ioc

Mcu.UserName=STM32F427VGTx
PA0/WKUP.Signal=UART4_TX
PA1.Signal=UART4_RX
PA10.Signal=USART1_RX
PA11.Signal=USB_OTG_FS_DM
PA12.Signal=USB_OTG_FS_DP
PA13.Signal=SYS_JTMS-SWDIO
PA14.Signal=SYS_JTCK-SWCLK
PA2.GPIO_Label=CS_MS5611
PA2.Signal=GPIO_Output
PA3.GPIO_Label=MPU9250_INT
PA3.Signal=GPIO_Input
PA4.GPIO_Label=CS_MPU9250
PA4.Signal=GPIO_Output
PA5.Signal=SPI1_SCK
PA6.Signal=SPI1_MISO
PA7.Signal=SPI1_MOSI
PA8.GPIO_Label=SD_CD
PA8.Signal=GPIO_Input
PA9.Signal=USART1_TX
PB0.Signal=S_TIM3_CH3
PB1.Signal=S_TIM3_CH4
PB10.Signal=I2C2_SCL
PB11.Signal=I2C2_SDA
PB12.GPIO_Label=LED_MCU_3
PB12.Signal=GPIO_Output
PB13.Signal=SPI2_SCK
PB14.Signal=SPI2_MISO
PB15.Signal=SPI2_MOSI
PB2/BOOT1.GPIO_Label=CS_ICM42688P
PB2/BOOT1.Signal=GPIO_Output
PB3.Signal=SYS_JTDO-SWO
PB4.Signal=S_TIM3_CH1
PB5.Signal=S_TIM3_CH2
PB6.Signal=S_TIM4_CH1
PB7.Signal=S_TIM4_CH2
PB8.Signal=S_TIM4_CH3
PB9.Signal=S_TIM4_CH4
PC0.Signal=ADCx_IN10
PC1.Signal=ADCx_IN11
PC10.Signal=SDIO_D2
PC11.Signal=SDIO_D3
PC12.Signal=SDIO_CK
PC13.GPIO_Label=CS_OSD
PC13.Signal=GPIO_Output
PC14/OSC32_IN.GPIO_Label=CS_FLASH
PC14/OSC32_IN.Signal=GPIO_Output
PC2.Signal=ADCx_IN12
PC3.Signal=ADCx_IN13
PC4.GPIO_Label=BATT_CURRENT_SENS
PC4.Signal=ADCx_IN14
PC5.GPIO_Label=BATT_VOLT_SENS
PC5.Signal=ADCx_IN15
PC6.Signal=USART6_TX
PC7.Signal=USART6_RX
PC8.Signal=SDIO_D0
PC9.Signal=SDIO_D1
PD0.Signal=CAN1_RX
PD1.Signal=CAN1_TX
PD10.GPIO_Label=CS_BMI088_A
PD10.Signal=GPIO_Output
PD11.GPIO_Label=CS_BMI088_G
PD11.Signal=GPIO_Output
PD12.GPIO_Label=BMI088_INT1
PD12.Signal=GPIO_Input
PD13.GPIO_Label=BMI088_INT2
PD13.Signal=GPIO_Input
PD14.GPIO_Label=BMI088_INT3
PD14.Signal=GPIO_Input
PD15.GPIO_Label=BMI088_INT4
PD15.Signal=GPIO_Input
PD2.Signal=SDIO_CMD
PD3.Signal=USART2_CTS
PD4.Signal=USART2_RTS
PD5.Signal=USART2_TX
PD6.Signal=USART2_RX
PD8.GPIO_Label=CS_BMP388
PD8.Signal=GPIO_Output
PD9.GPIO_Label=INT_BMP388
PD9.Signal=GPIO_Input
PE0.Signal=UART8_RX
PE1.Signal=UART8_TX
PE10.GPIO_Label=LED_MCU_0
PE10.Signal=GPIO_Output
PE11.Signal=S_TIM1_CH2
PE12.GPIO_Label=LED_MCU_1
PE12.Signal=GPIO_Output
PE13.Signal=S_TIM1_CH3
PE14.Signal=S_TIM1_CH4
PE15.GPIO_Label=LED_MCU_2
PE15.Signal=GPIO_Output
PE2.Signal=SPI4_SCK
PE3.GPIO_Label=CS_EXT0
PE3.Signal=GPIO_Output
PE4.GPIO_Label=CS_EXT1
PE4.Signal=GPIO_Output
PE5.Signal=SPI4_MISO
PE6.Signal=SPI4_MOSI
PE7.GPIO_Label=ICM42688P_INT1
PE7.Signal=GPIO_Input
PE8.GPIO_Label=ICM42688P_INT2
PE8.Signal=GPIO_Input
PE9.Signal=S_TIM1_CH1
PH0/OSC_IN.Signal=RCC_OSC_IN
PH1/OSC_OUT.Signal=RCC_OSC_OUT
