AeroKITties/Kitties-Hardware/(commit log)

2022-08-19 added tight kicad template
2022-10-11 updated footprints
2022-10-11 updated 3d models
    [Molex_PicoBlade_53047-0410_1x04_P1.25mm_Vertical.stp, Molex_PicoBlade_53047-0610_1x06_P1.25mm_Vertical.stp, NEO.STEP, SMA-angled.STEP, smd1812.stp]
2022-10-11 added FC0
    [FC0-B_Cu.gbr, FC0-B_Mask.gbr, FC0-B_Paste.gbr, FC0-B_Silkscreen.gbr, FC0-Edge_Cuts.gbr, FC0-F_Cu.gbr, FC0-F_Mask.gbr, FC0-F_Paste.gbr]
2022-10-12 updated FC0
    added information about silkscreen errors
    fixed silkscreen errors
    [FC0.kicad_pcb]
2023-02-12 updated kicad user lib
2023-02-15 added FC1 R3
    [R3.kicad_pcb, R3.kicad_sch, connectors.kicad_sch, peripherals.kicad_sch, power.kicad_sch]
2023-03-19 changed project folders naming
    [FC0-B_Cu.gbr, FC0-B_Mask.gbr, FC0-B_Paste.gbr, FC0-B_Silkscreen.gbr, FC0-Edge_Cuts.gbr, FC0-F_Cu.gbr, FC0-F_Mask.gbr, FC0-F_Paste.gbr]
2023-03-19 changed 1.3 file names
    [1.3.kicad_pcb, 1.3.kicad_sch]
2023-03-19 moved all royal penguin pcbs to one folder
    [1.3.kicad_pcb, 1.3.kicad_sch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]
2023-06-28 added 3d models
    [BMI088.STEP, BMP388.STEP, Fuse_1206.STEP, Fuse_1812.STEP, ICM-42688-P.STEP, MAX7456.STEP, MPU-9250.STEP, MSS-12D16.STEP]
2023-06-28 added footprints
2023-06-28 added v2.0
    [2.0-B_Cu.gbl, 2.0-B_Mask.gbs, 2.0-B_Paste.gbp, 2.0-B_Silkscreen.gbo, 2.0-Edge_Cuts.gm1, 2.0-F_Cu.gtl, 2.0-F_Mask.gts, 2.0-F_Paste.gtp]
2023-07-30 added impeller project
    [can.kicad_sch, impeller.kicad_pcb, impeller.kicad_sch, power.kicad_sch]
2023-08-02 updated ciam project
    [can.kicad_sch, connectors.kicad_sch, encoders.kicad_sch, impeller.kicad_sch, indicators.kicad_sch, power.kicad_sch, switches.kicad_sch]
2023-08-07 updated impeller project
    [can.kicad_sch, connectors.kicad_sch, encoders.kicad_sch, impeller.kicad_pcb, impeller.kicad_sch, indicators.kicad_sch, power.kicad_sch, switches.kicad_sch]
2023-08-08 multiple fixes
    [bom_пульт_экраны.xlsx, can.kicad_sch, connectors.kicad_sch, encoders.kicad_sch, impeller.kicad_sch, indicators.kicad_sch, power.kicad_sch, switches.kicad_sch]
2023-08-08 fixed bug in encoders sheet
    [encoders.kicad_sch]
2023-08-08 updated bom
    [bom_плата.xlsx, bom_пульт_экраны.xlsx, can.kicad_sch, connectors.kicad_sch, encoders.kicad_sch, impeller.kicad_sch, indicators.kicad_sch, power.kicad_sch]
2023-08-10 updated component info
    [impeller.kicad_sch]
2023-08-14 changed 12-5V dc-dc converter
    [power.kicad_sch]
2023-08-16 added thrust lever
    [connectors.kicad_sch]
2023-08-16 updated thrust level voltage divider
    [connectors.kicad_sch]
2023-08-16 added power shield project
    [power_sheld.kicad_pcb, power_sheld.kicad_sch]
2023-08-23 added rpi shield project
    [BOM_RPi_Shield.xlsx, BOM_RPi_Shield_PCB.xlsx, BOM_другое.xlsx, BOM_плата_кпу.xlsx, connectors.kicad_sch, power_sheld.kicad_pcb, power_sheld.kicad_sch]
2023-08-24 added rpi uart isolation
    [power_sheld.kicad_sch]
2023-08-25 fixed uart
    [connectors.kicad_sch]
2023-10-16 Updated penguin project
    [2.0.kicad_pcb, Connectors.kicad_sch, OSD.kicad_sch, Penguin Junior.kicad_pcb, Penguin Junior.kicad_sch, Power.kicad_sch, Sensors.kicad_sch]
2023-11-02 Updated project
    [Connectors.kicad_sch, OSD.kicad_sch, Penguin Junior.kicad_pcb, Penguin Junior.kicad_sch, Power.kicad_sch, Sensors.kicad_sch]
2023-12-27 Update Penguin project
    [bom.xlsx]
2024-02-24 added Piezo sensor board project
    [PiezoSensorBoard.PrjPcb]
2024-02-25 Added power 10V0
    [PiezoSensorBoard.PrjPcb, Power.SchDoc]
2024-02-26 Started ADC file
    [ADC.SchDoc, PiezoSensorBoard.PrjPcb, Power.SchDoc]
2024-02-28 Penguin Junior 1.1 release
    [Connectors.kicad_sch, OSD.kicad_sch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]
2024-02-28 Minor changes
    [Penguin Junior-B_Cu.gbl, Penguin Junior-B_Mask.gbs, Penguin Junior-B_Paste.gbp, Penguin Junior-B_Silkscreen.gbo, Penguin Junior-Edge_Cuts.gm1, Penguin Junior-F_Cu.gtl, Penguin Junior-F_Mask.gts, Penguin Junior-F_Paste.gtp]
2024-02-29 Added CPU
    [ADC.SchDoc, MCU.SchDoc, PiezoSensorBoard.PrjPcb, Power.SchDoc]
2024-03-04 Updated MCU
    [ADC.SchDoc, MCU.SchDoc, Power.SchDoc]
2024-03-05 Plased boot0 switch
    [ADC.SchDoc, MCU.SchDoc, PiezoSensorBoard.PrjPcb, Power.SchDoc]
2024-03-13 Another update
    [ADC.SchDoc, MCU.SchDoc, PiezoSensorBoard.PcbDoc, PiezoSensorBoard.PrjPcb, Power.SchDoc]
2024-03-13 Updated KiCad version
    [Connectors.kicad_sch, OSD.kicad_sch, Penguin Junior.kicad_pcb, Penguin Junior.kicad_sch, Power.kicad_sch, Sensors.kicad_sch]
2024-03-14 added empty projects for main board, sensor module, imu module
    [IMU module.kicad_pcb, IMU module.kicad_sch, Master board.kicad_pcb, Master board.kicad_sch, Piezo module.kicad_pcb, Piezo module.kicad_sch]
2024-03-14 added master board schematic
    [LED_3528_RGB.STEP, Master board.kicad_pcb, Master board.kicad_sch, XT60PW-M--3DModel-STEP-269445.STEP, connectors.kicad_sch, power.kicad_sch]
2024-03-14 changed xt60 to xt30
    [Master board.kicad_pcb, XT30PW-M--3DModel-STEP-1.STEP, power.kicad_sch]
2024-03-14 Master board сoncept
    [Master board.kicad_pcb, Master board.kicad_sch, power.kicad_sch]
2024-03-15 added spi flash memory
    [Master board.kicad_sch]
2024-03-15 minor fixes
    [Master board.kicad_pcb, power.kicad_sch]
2024-03-15 added piezo module schematic (early version)
    [Piezo module.kicad_sch, connectors.kicad_sch, piezo.kicad_sch, power.kicad_sch]
2024-03-16 added solder jumpers for 120R CAN
    [Master board.kicad_sch, Piezo module.kicad_sch]
2024-03-16 Added UART port
    [Master board.kicad_pcb, Master board.kicad_sch, connectors.kicad_sch, power.kicad_sch]
